CreatorKanata/pneutouch-ai-rehc2026/README.md

<!-- Project entry point: what the system is, how it works, and how to run it. -->
# PneuTouch AI

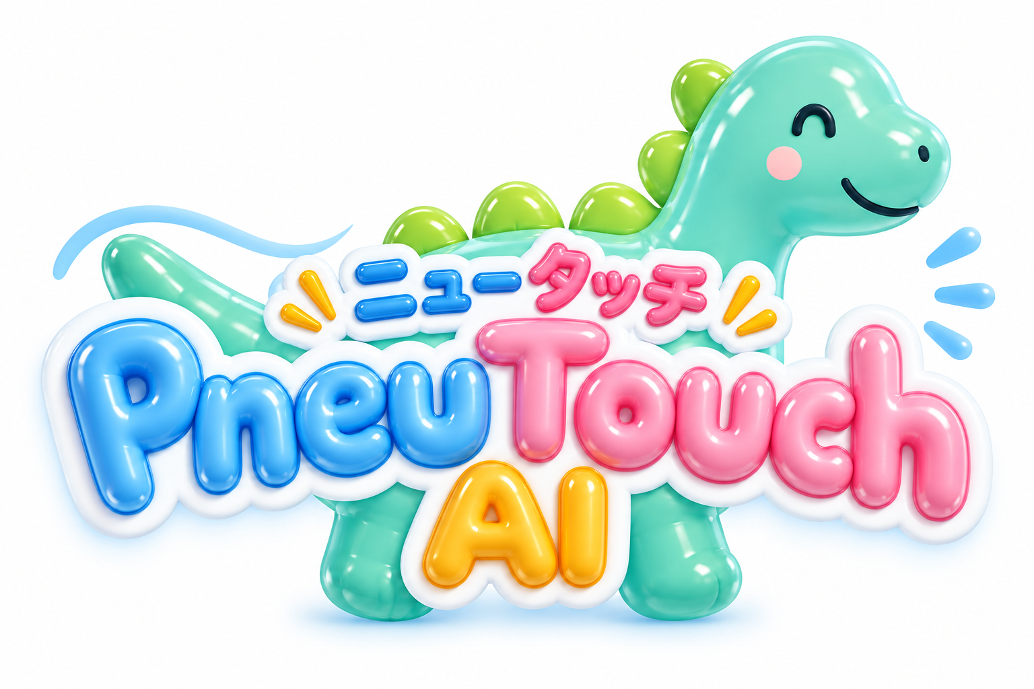
[picture p1: images/logo/pneu-touch-ai-thumbnail.png]
PneuTouch AI — 触れると動き出す中空恐竜


**Created by Kanata the Kid Creator.**

やわらかいTPU製の中空恐竜を7つの空気室に分け、
**たった1個の空気圧センサーの波形から「どこを触られたか」を推定する**システムです。
推定はROHMのマイコン ML63Q2557 に搭載された Solist-AI で行い、学習も推論もチップの中だけで完結します。
触った場所に応じて、画面の中の恐竜が反応します。

ROHM EDGE HACK CHALLENGE 2026（REHC2026）の応募作品です。

| | リンク |
|---|---|
| 作品ページ（ProtoPedia） | <https://protopedia.net/prototype/9781> |
| デモ動画（YouTube） | <https://youtu.be/TioNkfCQrJ0> |

## システム構成

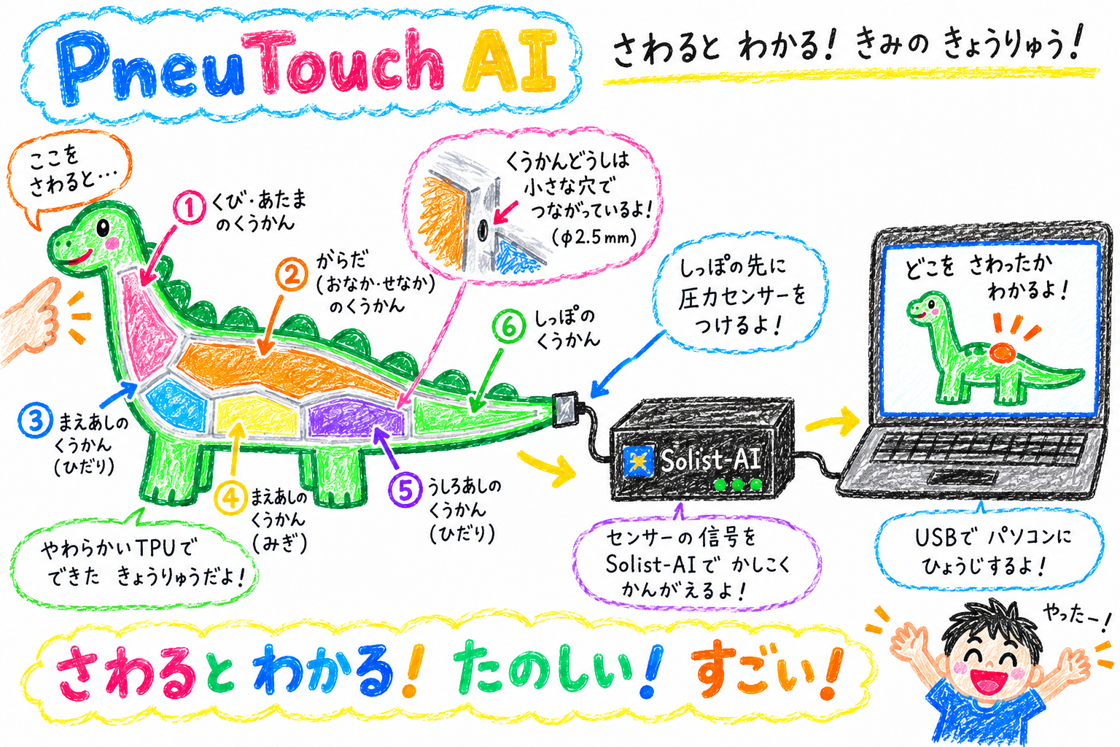
[picture p2: images/others/system.png]
システム構成


## しくみ

ふつう、7か所のタッチを検出するには7個のセンサーが必要です。
PneuTouch AI は、センサーを増やす代わりに**恐竜の「形」に情報を持たせます**。
恐竜の中には電子部品も配線も入っておらず、センサーはしっぽの先に1個だけです。

```text
恐竜を押す → 空気が穴を通って伝わる → 圧力の波形を測る → 波形の形を12個の数にする
→ Solist-AI が部位を当てる → LCD と画面の恐竜が反応する
```

### 1. 恐竜の中は7つの部屋

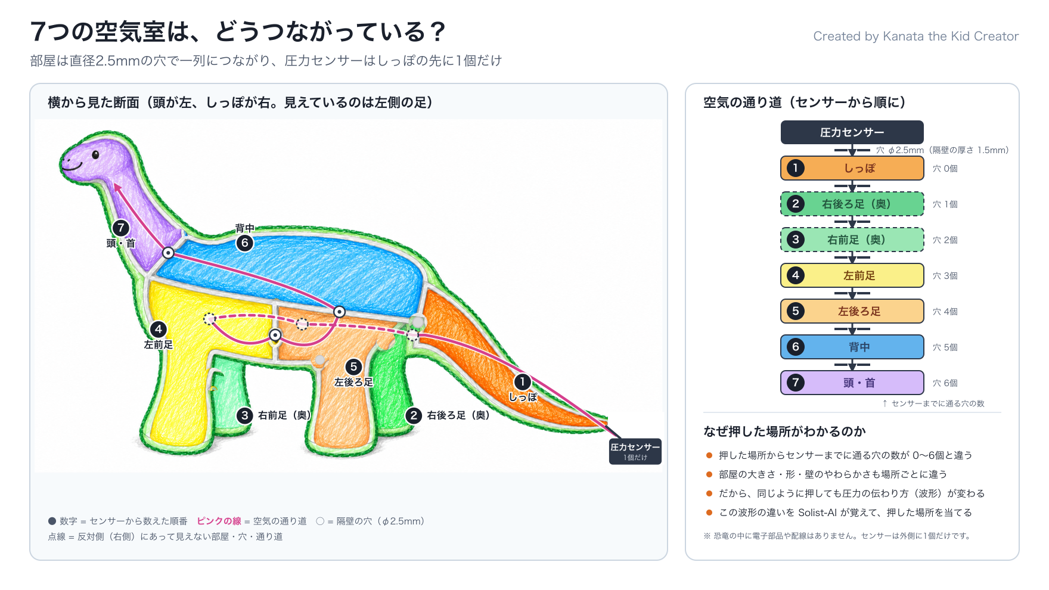
[picture p3: images/protopedia/air-chambers.png]
7つの空気室のつながり


恐竜の中は7つの空気室に分かれていて、となりの部屋とは直径2.5 mmの穴1個でつながっています
（外殻と隔壁の厚さは1.5 mm）。部屋は一列につながり、センサーから数えると次の順です。

```text
センサー → ①しっぽ → ②右後ろ足 → ③右前足 → ④左前足 → ⑤左後ろ足 → ⑥背中 → ⑦頭・首
```

しっぽを押すと空気の変化は穴を通らずにセンサーへ届き、頭を押すと6個の穴を通って届きます。
通る穴の数や部屋の大きさが場所ごとに違うので、**圧力の伝わり方が場所ごとに変わります**。

| Zone | 部位 | 分類クラス |
|---:|---|---|
| 1 | しっぽ | `TAIL` |
| 2 | 背中・胴体 | `BACK` |
| 3 | 右後ろ足 | `LEGS` |
| 4 | 左後ろ足 | `LEGS` |
| 5 | 右前足 | `LEGS` |
| 6 | 左前足 | `LEGS` |
| 7 | 首・頭 | `HEAD` |

Zone番号は設計上の区画番号で、センサーからの順番とは異なります。

### 2. 押して離すと、波形ができる

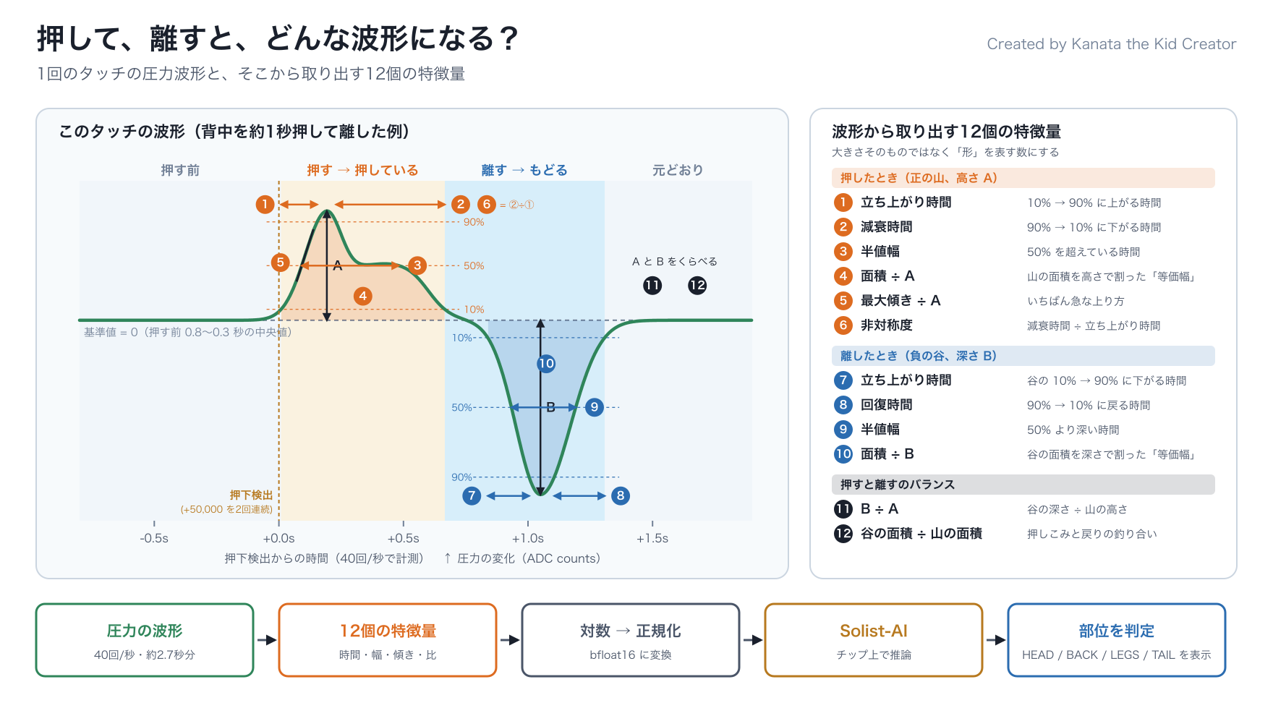
[picture p4: images/protopedia/waveform-features.png]
押して離したときの波形と12個の特徴量


恐竜を約1秒押して離すと、センサーには次のような波形が届きます。

- **押したとき** — その部屋の空気が押し出され、圧力が**上がる**（正の山）
- **離したとき** — 形が元に戻ろうとして空気を吸い込み、圧力が**下がる**（負の谷）

圧力は MPS20N0040D + HX710B で40回/秒、24 bitで測ります。

マイコンは圧力の「大きさ」ではなく、この山と谷の「形」を12個の数（特徴量）にしてAIに渡します。

| グループ | 特徴量 |
|---|---|
| 押したとき（正の山、高さ A） | ①立ち上がり時間 ②減衰時間 ③半値幅 ④面積÷A ⑤最大傾き÷A ⑥非対称度（②÷①） |
| 離したとき（負の谷、深さ B） | ⑦立ち上がり時間 ⑧回復時間 ⑨半値幅 ⑩面積÷B |
| 押すと離すのバランス | ⑪B÷A ⑫谷の面積÷山の面積 |

時間や比にすることで、押す強さが多少変わっても形の特徴が残るようにしています。

### 3. AIが部位を当てる

12個の特徴量を ROHM ML63Q2557 の Solist-AI に入力し、`HEAD / BACK / LEGS / TAIL` の4つに分類します。
学習も推論もマイコンの中だけで行い、クラウドもPCも使いません。

### 4. 恐竜が反応する

結果はボードのLCDに3秒表示され、USBでPCへ送られます。
ブラウザーのデモ画面が、触った部位に応じた動画・部位の画像・そのときの実測波形を表示します。

## ハードウェア

| 部品 | 役割 |
|---|---|
| TPU製の中空恐竜（3Dプリント） | 触られる本体。7つの空気室を持つ |
| MPS20N0040D + HX710B モジュール | 空気圧センサーと24 bit A/D変換 |
| DT-EBML63Q2557 | ROHM ML63Q2557（Arm Cortex-M0+、Solist-AI）搭載の評価ボード |
| MCU-LINK | ファームウェアの書き込み・デバッグ |
| PC（Chrome / Edge） | デモ画面の表示 |

### 回路図

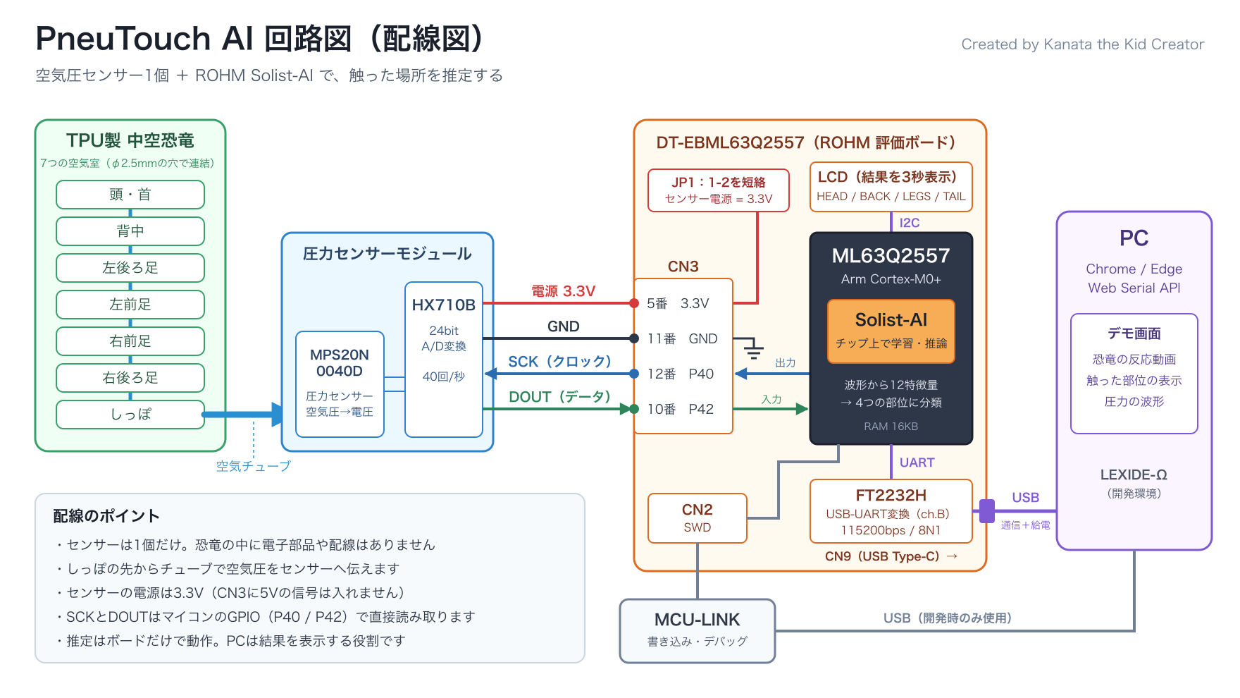
[picture p5: images/protopedia/circuit-diagram.png]
回路図


| センサーモジュール | DT-EBML63Q2557 | マイコン |
|---|---|---|
| VCC | CN3-5（3.3V） | — |
| GND | CN3-11 | — |
| SCK | CN3-12 | P40（GPIO出力） |
| DOUT | CN3-10 | P42（GPIO入力） |

- JP1は1–2を短絡してセンサー電源を3.3Vにします。CN3に5Vの信号は入れません。
- PCとの通信はCN9（USB Type-C）。FT2232HのチャネルBがUARTで、115200 baud / 8N1 / フロー制御なしです。
- MCU-LINKはCN2（SWD）に接続します。

詳しくは[ボード・センサー・配線](docs/hardware.md)を参照してください。

## ソフトウェア

| 場所 | 言語 | 内容 |
|---|---|---|
| `src/pneutouch-solist` | C | ファームウェア（プロジェクト名 `PneutouchAi`）。センサー読み取り、特徴抽出、Solist-AIの学習・推論、LCD表示、UART送信 |
| `src/demo-visualizer` | JavaScript | デモ画面。Web Serial APIで推定結果を受け取り、動画・部位画像・波形を表示 |
| `src/learning-tool` | JavaScript / Python | 波形の表示とCSV保存を行う計測ツール |
| `src/shared` | JavaScript | シリアル接続、通信の解析、記録の共通処理 |
| `tools` | Python | 波形の分析、学習データの生成、設定ヘッダーの生成、ローカルサーバー |
| `tests` | C / Python / JavaScript | PC上で動かすテスト |

自作のファームウェアは `src/pneutouch-solist/S_PneuTouch` にあります。

### AIモデル

| 項目 | 内容 |
|---|---|
| 入力 | 波形から計算した12特徴量（[しくみ 2](#2-押して離すと波形ができる) を参照） |
| 構成 | 12入力・隠れ層32・4出力 |
| 学習 | 電源投入時に、FLASHへ格納した60イベントからチップ上で自動学習（約0.5秒） |
| 推定 | 前処理を含めて約5ミリ秒 |
| 2段階判別 | 1段目が `HEAD` か `LEGS` を返したとき、専用モデルで判別し直す |

推定に使うのはその場のセンサーの値だけで、推定時にPCの操作は要りません。
モデルの詳細は[ライブデモの実装](docs/live-pressure-demo-20260920.md)と
[頭と足の判別](docs/head-legs-refinement-20260920.md)を参照してください。

### 通信

ボードはUARTで次の行を送ります。ブラウザー側で分類し直すことはありません。

| 出力 | 意味 |
|---|---|
| `PNEU1,seq,ms,raw` | センサーの生値 |
| `# PNEE1` / `# PNEF1` | 検出したイベントと12特徴量 |
| `# PNEC1,id,ms,label,...` | 推定結果とスコア |
| `# PNEL1,label,ms` | LCDの表示 |

## 使い方

### 1. ファームウェアを書き込む

LEXIDE-Ωで `src/pneutouch-solist` を開きます。

1. **PneutouchAi (in pneutouch-solist)** を選び、**Debug** でビルド。
2. **PneutouchAi Write** をDebugとして起動して書き込み。
3. LCDに `READY` が出たら、約2秒待ってから恐竜を押します。

手順の詳細は[配線・ビルド・計測手順](docs/phase0-bringup.md)と
[Mac / Windowsでの開発方法](docs/development-workflow.md)にあります。

### 2. デモ画面を開く

```sh
python tools/serve_demo.py
```

Chrome / Edgeで <http://localhost:8001/demo-visualizer/> を開き、
「恐竜につなぐ」からCN9のUARTポート（開発環境ではCOM7）を選びます。
表示の仕様は[HTMLデモ](src/demo-visualizer/README.md)を参照してください。

### 3. 波形を見る・記録する

```sh
python tools/serve.py
```

<http://localhost:8000/learning-tool/> を開いて同じポートに接続します。
同じシリアルポートを複数の画面で同時に開くことはできません。

### 設定の変更とテスト

```sh
python tools/generate_config.py   # config.py から設定ヘッダーを生成
python tools/test.py              # PC上のテストを実行
```

## ディレクトリ構成

```text
pneutouch-ai-rehc2026/
├── 3d-models/     # 恐竜の3Dモデル（STL / 3MF）
├── config.py      # 設定の原本
├── docs/          # 設計・手順・検証記録
├── images/        # ロゴ、デモ画像、構成図、回路図
├── src/           # ファームウェアとPCアプリ
├── tests/         # テスト
├── tools/         # 分析・生成・起動スクリプト
└── videos/demo/   # デモ画面で再生する動画
```

## ドキュメント

- [ドキュメント一覧](docs/README.md)
- [コンセプト](docs/concept.md) / [企画の核と検証方針](docs/product-design.md)
- [ボード・センサー・配線](docs/hardware.md)
- [ディレクトリ構成とアプリの役割](docs/architecture.md)
- [Solist-AI実機での学習・比較結果](docs/solist-chip-validation-20260920.md)
- [隔壁・穴径によるフィルタ設計の検討](docs/pneumatic-filter-design-20260920.md)

実測データと検証の記録は `docs/analysis/` にあります。

## ライセンス

Copyright 2026 Kanata the Kid Creator

このプロジェクトは [Apache License 2.0](LICENSE) で公開しています。
次の部分は提供元の著作権表示と条件に従います。詳しくは [NOTICE](NOTICE) を参照してください。

- `src/pneutouch-solist` のうち `S_PneuTouch` 以外は、ROHM Co., Ltd. が配布するドライバー、
  サンプルコード、Solist-AIライブラリーに基づいています。
- 恐竜の外形は [Cute Stylized Dinosaur Toy](https://www.printables.com/model/489585-cute-stylized-dinosaur-toy) をベースにしています。
  内部の空気室・隔壁・穴・圧力取り出し口は独自に設計しました。
