CreatorKanata/pneutouch-ai-rehc2026/docs/concept.md

もちろん。今回は「実際にこのまま開発を進められる仕様書」に寄せて、**設計 → 造形 → センサ接続 → 波形取得 → 原理検証 → Solist-AI学習 → PCアプリ → 評価 → 次版改善**まで含めてまとめます。

# PneuTouch AI

## 1つの空気圧センサで柔らかい立体物の接触位置を推定するオンデバイスAI

**Project:** ROHM EDGE HACK CHALLENGE 2026（REHC2026）
**AI Platform:** Solist-AI™ / DT-EBML63Q2557
**Prototype:** 7-Zone Soft Dinosaur
**Pressure Sensor:** MPS20N0040D + HX710B
**Material:** TPU
**Project Status:** Prototype Development

---

# 1. 概要

**PneuTouch AI** は、柔らかい中空構造物の内部を複数の空気室（チャンバー）へ分割し、**たった1個の空気圧センサから「どこを押されたか」をオンデバイスAIで推定する触覚センシング技術**です。

一般的な多点タッチセンシングでは、検出したい場所ごとに、

* スイッチ
* FSR
* 静電容量センサ
* 圧力センサ
* 磁気センサ

などを配置する必要があります。

PneuTouch AIでは、各部位に電気的なセンサを配置しません。

代わりに、柔らかい構造物内部を複数の空気室に分割し、それぞれを小さな穴（オリフィス）によって接続します。

どこかを押すと内部の空気圧が変化します。

その圧力変化が複数のチャンバーとオリフィスを通って1個の圧力センサまで伝わる際に、

* 立ち上がり速度
* ピーク圧力
* ピーク到達時間
* 波形形状
* 減衰
* 復帰波形

などに違いが発生することを利用します。

この複雑な圧力波形を **Solist-AI™** に学習させることで、押された位置を分類します。

---

# 2. コンセプト

## 1 Sensor, Whole-Body Touch

PneuTouch AIの基本コンセプトは、

> **柔らかい物体そのものを触覚センサにする**

ことです。

```text
複数の触覚エリア
       ↓
複数の空気チャンバー
       ↓
オリフィスによる空気圧ネットワーク
       ↓
圧力センサ × 1
       ↓
Solist-AI™
       ↓
接触位置推定
```

例えば7ヶ所の接触を検出するために7個のセンサを配置するのではなく、

**7区画 + 圧力センサ1個**

で実現することを目標とします。

---

# 3. REHC2026での技術的な狙い

本プロジェクトでは、単純な圧力閾値判定ではなく、Solist-AI™による波形分類を利用します。

最終的な圧力値だけを見る場合、どの区画を押しても内部圧力は最終的に均一化する可能性があります。

しかし、圧力が均一化するまでの**過渡応答**には、接触位置による違いが含まれると考えています。

```text
Touch
  ↓
Pneumatic transient response
  ↓
Pressure waveform
  ↓
Solist-AI
  ↓
Touch location
```

つまりPneuTouch AIは、

**「圧力の大きさ」をAIで分類するのではなく、「圧力が伝わる過程」をAIで分類する**

システムです。

---

# 4. プロトタイプ外形

初期プロトタイプには、Printablesで公開されている以下の恐竜モデルをベース外形として利用します。

**Cute Stylized Dinosaur Toy**

[https://www.printables.com/model/489585-cute-stylized-dinosaur-toy](https://www.printables.com/model/489585-cute-stylized-dinosaur-toy)

利用するのは主として**外形デザイン**です。

PneuTouch AIとして必要となる、

* 内部空洞
* 7区画
* 隔壁
* オリフィス
* 圧力取り出し口
* TPU向け壁構造

については独自に設計します。

元モデルのライセンス条件については、公開・配布時に原作者の指定条件を確認し、それに従います。

---

# 5. 3Dプリント構造

## 5.1 材料

初期試作：

**TPU**

柔らかく、押すことで外壁および内部空気室が変形する材料を利用します。

求める特性：

* 手で容易に押せる
* 押した後に形状が復帰する
* ある程度の気密性を確保できる
* 繰り返し押しても破損しにくい

---

# 6. 内部区画

恐竜内部を以下の7区画に分割します。

| Zone | 部位 |
| ---: | ----- |
| 1 | 尻尾 |
| 2 | 背中・胴体 |
| 3 | 右後ろ足  |
| 4 | 左後ろ足  |
| 5 | 右前足 |
| 6 | 左前足 |
| 7 | 首・頭 |

各区画はTPU製の隔壁で分離します。

---

# 7. 空気圧ネットワーク

初期試作では各区画を以下の順番で接続します。

```text
Pressure Sensor
      │
      ▼
[1 Tail]
      │
    φ2.5
      │
[3 Right Rear Leg]
      │
    φ2.5
      │
[5 Right Front Leg]
      │
    φ2.5
      │
[6 Left Front Leg]
      │
    φ2.5
      │
[4 Left Rear Leg]
      │
    φ2.5
      │
[2 Body / Back]
      │
    φ2.5
      │
[7 Neck / Head]
```

接続順：

**1 → 3 → 5 → 6 → 4 → 2 → 7**

---

# 8. オリフィス

## 初期試作

各隔壁を接続する穴：

**φ2.5 mm**

初期段階からφ2.5 mmで試作します。

この穴は単なる空気穴ではなく、PneuTouch AIにおいて重要な**空気抵抗要素**です。

穴径が大きすぎる場合：

```text
圧力が急速に均一化
↓
区画間の波形差が小さくなる
```

穴径が小さすぎる場合：

```text
圧力伝達が遅すぎる
↓
応答性低下
↓
TPU造形時に穴が塞がる可能性
```

そのため初期値としてφ2.5 mmを採用します。

---

# 9. Pneumatic Encoding

PneuTouch AIでは、内部構造そのものを情報エンコーダとして利用します。

これを本プロジェクトでは、

**Pneumatic Encoding**

と呼びます。

各区画には、

* センサまでの経路長
* 通過するオリフィス数
* チャンバー容積
* チャンバー形状
* TPU壁面形状
* 周囲の構造

の違いがあります。

例えばZone 1（Tail）は圧力センサのすぐ近くにあります。

```text
Tail
 ↓
Sensor
```

一方Zone 7（Head / Neck）は、

```text
Head
 ↓
Body
 ↓
Left Rear
 ↓
Left Front
 ↓
Right Front
 ↓
Right Rear
 ↓
Tail
 ↓
Sensor
```

という長い空気圧経路を通ります。

そのため、同じ程度の力で押しても異なる過渡応答が発生することを期待します。

---

# 10. 想定される圧力波形

概念的には以下のような違いを期待します。

## センサに近い部位

```text
Pressure
   │
   │     ╭────────
   │  ╭──╯
   │__╯
   │
   └──────────────── Time
```

## 中間部位

```text
Pressure
   │
   │        ╭───────
   │     ╭──╯
   │____╯
   │
   └──────────────── Time
```

## センサから遠い部位

```text
Pressure
   │
   │            ╭────
   │         ╭──╯
   │________╯
   │
   └──────────────── Time
```

実際にはもっと複雑な波形になることが予想されます。

むしろ、その複雑さをSolist-AI™で分類することが本プロジェクトの狙いです。

---

# 11. 圧力取り出し口

恐竜の**尻尾先端**に圧力取り出し口を設けます。

初期設計では約φ2.5 mmのチューブ形状とし、圧力センサ側へ接続します。

重要事項：

* 接続部から空気が漏れないこと
* TPUとチューブの接続部を気密化すること
* センサ側チューブ容量をなるべく一定にすること
* 実験ごとに配管条件を変更しないこと

---

# 12. 圧力センサ

使用予定：

**MPS20N0040D + HX710B系圧力センサモジュール**

購入先：

[https://www.amazon.co.jp/dp/B0DMDL39BG](https://www.amazon.co.jp/dp/B0DMDL39BG)

想定モジュール端子：

```text
VCC
GND
SCK
DOUT
```

想定電源：

**3.3〜5V**

DT-EBML63Q2557との接続では、3.3V系GPIOとの整合性を考慮し、原則として**3.3V給電**で使用します。

---

# 13. 圧力センサの役割

MPS20N0040Dによって内部空気圧の変化を検出し、HX710Bによってデジタル値として取得します。

重要なのは、絶対圧力の高精度測定ではありません。

本プロジェクトでは、

**時間方向に変化する相対圧力波形**

を主なAI入力として利用します。

---

# 14. AI開発ボード

使用：

**DT-EBML63Q2557**

搭載MCU：

**ML63Q2557**

AI：

**Solist-AI™ / AxlCORE-ODL**

主な役割：

1. HX710Bから圧力データ取得
2. 圧力データのリングバッファ保存
3. 接触イベント検出
4. 固定長波形生成
5. 必要な前処理
6. Solist-AI学習
7. Solist-AI推論
8. USB UARTによるPC通信

---

# 15. MCU-LINK

ファームウェアの開発・デバッグには**MCU-LINK**を使用します。

用途：

* ファームウェア書き込み
* デバッグ
* ブレークポイント
* メモリ確認
* センサ取得処理の検証
* Solist-AI処理の検証

構成：

```text
PC
 │
 ├── MCU-LINK
 │      │
 │      ▼
 │ DT-EBML63Q2557
 │
 └── USB UART
        │
        ▼
   DT-EBML63Q2557
```

MCU-LINKとUSB UARTは目的を分離します。

**MCU-LINK = 開発・デバッグ**

**USB UART = PneuTouch Consoleとのデータ通信**

---

# 16. USB UART

DT-EBML63Q2557とPCはUSB UARTで接続します。

PCからは仮想COMポートとして扱う構成を想定します。

---

# 17. PCアプリケーション

PC側には専用アプリ、

# PneuTouch Console

を開発します。

初期案ではブラウザベースのWebアプリとします。

候補：

* HTML
* CSS
* JavaScript / TypeScript
* Web Serial API
* Chart.js または ECharts

Chrome / EdgeのWeb Serial APIを利用することで、ブラウザから直接USB UARTへ接続することを想定します。

---

# 18. PneuTouch Consoleの役割

PneuTouch Consoleは単なるデモ画面ではなく、

**開発・学習・評価・デモを統合したツール**

とします。

主な機能：

1. シリアルポート接続
2. 生圧力値表示
3. リアルタイム波形表示
4. 接触イベント表示
5. 学習対象Zone指定
6. 学習開始/停止
7. サンプル数表示
8. AI推論結果表示
9. クラススコア表示
10. 接触位置の恐竜図への表示
11. 接触位置に対応した動画再生
12. CSV保存
13. 過去波形との比較

---

# 19. PC画面案

```text
┌────────────────────────────────────────────┐
│ PneuTouch AI Console                      │
├──────────────────┬─────────────────────────┤
│                  │                         │
│   Dinosaur       │   Pressure Waveform     │
│                  │                         │
│      HEAD        │         ╭──────         │
│       ██         │      ╭──╯               │
│     █████        │  ___╯                   │
│    ███████       │                         │
│                  │                         │
├──────────────────┼─────────────────────────┤
│ Prediction       │ Training / Scores       │
│                  │                         │
│ HEAD / NECK      │ HEAD  █████████ 92%     │
│                  │ BODY  ██         5%     │
│                  │ TAIL  █          3%     │
├──────────────────┴─────────────────────────┤
│              Reaction Video               │
└────────────────────────────────────────────┘
```

---

# 20. PCアプリ：恐竜表示

画面には恐竜の模式図を表示します。

推論された区画をハイライトします。

例えば頭を押した場合：

```text
Zone 7
HEAD / NECK

→ 頭と首をハイライト
```

尻尾なら：

```text
Zone 1
TAIL

→ 尻尾をハイライト
```

これによりAIの推論結果を直感的に確認できます。

---

# 21. PCアプリ：動画リアクション

推論結果に応じて異なる動画を表示します。

例：

| Zone | 部位 | Reaction |
| ---: | ---- | --- |
| 1 | 尻尾 | 怒る |
| 2 | 背中 | 振り向く |
| 3 | 右後ろ足 | 足を動かす |
| 4 | 左後ろ足 | 足を動かす |
| 5 | 右前足  | 手を振る |
| 6 | 左前足  | 手を振る |
| 7 | 首・頭  | 喜ぶ |

これにより、

> **触った場所を恐竜自身が感じて反応している**

ような体験を作ります。

---

# 22. PCアプリ：学習UI

学習時にはPCから対象Zoneを指定します。

```text
TRAINING MODE

Select Zone:

[1 Tail]
[2 Body]
[3 Right Rear Leg]
[4 Left Rear Leg]
[5 Right Front Leg]
[6 Left Front Leg]
[7 Head / Neck]

Target:
7 HEAD / NECK

Samples:
██████████████░░░░░░
23 / 30

[ START ]
[ STOP ]
```

対象Zoneを指定した状態で、その部位を繰り返し押します。

---

# 23. データ取得手順

## Phase 0：AIを使わずセンサを動かす

最初はSolist-AIを使用しません。

目標：

**MPS20N0040D + HX710Bの値をDT-EBML63Q2557で取得し、PCへ表示する。**

手順：

1. HX710BをDT-EBML63Q2557へ接続
2. 3.3Vで動作確認
3. HX710B読み出し処理実装
4. USB UARTへ値を送信
5. PCで値を表示
6. センサへ直接圧力を加えて変化を確認

---

続きとして、**Phase 1以降の検証フェーズ**をそのまま仕様書に追記できるMarkdownでまとめます。特に「φ2.5 mmの7区画構造が本当に位置情報を残しているか」をSolist-AI学習前に確認する流れを重視しています。

# 24. Phase 1：恐竜の気密確認

TPU恐竜が完成したら、最初にAIではなく**空気圧センサとして成立しているか**を確認します。

## 目的

* TPU外壁から大きな空気漏れがないこと
* 7区画が空気圧的につながっていること
* φ2.5 mmオリフィスが造形時に塞がれていないこと
* 尻尾先端から圧力変化を取得できること
* 押した後に圧力が正常に復帰すること

## 手順

1. 尻尾先端の圧力取り出し口をMPS20N0040Dへ接続する
2. PCでリアルタイム圧力値を表示する
3. Zone 1（Tail）をゆっくり押す
4. 圧力値が変化することを確認する
5. Zone 7（Head / Neck）を押す
6. センサから最も遠いZone 7でも圧力変化が到達することを確認する
7. Zone 1〜7を順番に押す
8. すべてのZoneで圧力変化が取得できることを確認する

## 気密テスト

任意のZoneを一定時間押した状態に保持します。

正常な場合：

```text
押す
 ↓
圧力上昇
 ↓
一定値付近を維持
 ↓
手を離す
 ↓
基準値へ復帰
```

押し続けているにもかかわらず圧力が急速に基準値へ戻る場合は、以下を確認します。

* TPU外壁からの空気漏れ
* 積層間の微細なリーク
* 尻尾のチューブ接続部
* 圧力センサ接続部
* 隔壁の意図しない穴
* オリフィス以外での区画間リーク

---

# 25. Phase 2：7区画の生波形取得

気密性が確認できたら、**Solist-AIを使わずに7区画の圧力波形を取得**します。

このフェーズがPneuTouch AIの成立可否を判断する最重要実験です。

## 目的

各Zoneを押したときに、圧力波形へ再現可能な違いが現れるか確認します。

## 初期データセット

各Zoneについて最低30回取得します。

```text
Zone 1 Tail             × 30
Zone 2 Body / Back      × 30
Zone 3 Right Rear Leg   × 30
Zone 4 Left Rear Leg    × 30
Zone 5 Right Front Leg  × 30
Zone 6 Left Front Leg   × 30
Zone 7 Head / Neck      × 30
```

合計：

```text
7 classes × 30
= 210 touch events
```

可能であれば50回ずつ取得します。

---

# 26. 押し方の標準化

初期検証では、位置以外の変数をできるだけ減らします。

最初は、

* 指1本で押す
* 約1秒程度押す
* 約1秒程度保持
* 手を離す
* 次の試行まで1〜2秒待つ

という一定の操作を行います。

初期段階では「弱く押す」「強く押す」などを混在させません。

まず、

> **同じように押した場合、位置だけを分類できるか**

を確認します。

---

# 27. PCへの生波形保存

PneuTouch Consoleでは各接触イベントをCSV等で保存します。

例：

```text
timestamp,zone,sample_index,pressure
12:03:21.120,1,0,838241
12:03:21.125,1,1,838255
12:03:21.130,1,2,838291
...
```

各イベントには以下の情報を保存します。

* Zone ID
* 試行番号
* Timestamp
* Raw pressure
* Baseline pressure
* Delta pressure
* サンプリング周期
* 必要に応じてメモ

---

# 28. Phase 3：波形の可視化

収集した210回以上の波形をPC上で比較します。

## まず確認するもの

### 1. Raw waveform

生の圧力値。

### 2. Baseline corrected waveform

接触直前を0として、

```text
ΔP(t) = P(t) - Pbaseline
```

を表示します。

### 3. Normalized waveform

押す強さの違いを減らして波形形状を比較するため、

```text
0.0 ～ 1.0
```

へ正規化した波形も表示します。

---

# 29. Zoneごとの波形重ね合わせ

例えばZone 1を30回押した波形を同じチャートへ重ねます。

目的は、

**同じZoneの波形に再現性があるか**

を確認することです。

その後、

```text
Zone 1 mean waveform
Zone 2 mean waveform
Zone 3 mean waveform
...
Zone 7 mean waveform
```

を比較します。

理想的には、Zoneごとに特徴的な立ち上がり・減衰パターンが確認できます。

---

# 30. Phase 4：Pneumatic Encoding成立確認

ここで初めて、

> **7区画の空気圧ネットワークに位置情報が残っているか**

を判断します。

## 観察候補

各波形について、

* 最大ΔP
* Rise time
* Peak time
* Fall time
* 波形面積
* 初期傾斜
* 最大傾斜
* 押している間の変動
* Release時の負圧/復帰特性
* 接触後一定時間の波形

などを比較します。

重要なのは、これらを必ず手作業で分類ルールへ変換することではありません。

Solist-AIへ入力する前に、

**「そもそもZoneによる情報差が存在する」**

ことを確認するために利用します。

---

# 31. 成立判定

## Case A：7区画が明確に違う

最良ケース。

そのまま7クラスSolist-AI学習へ進みます。

## Case B：4〜5グループ程度に分かれる

例えば、

```text
HEAD
BODY
FRONT LEGS
REAR LEGS
TAIL
```

程度なら区別できる場合。

まず5クラスでSolist-AIを完成させます。

その後、内部構造を改良して7クラスを目指します。

## Case C：センサからの距離だけが分かる

例えば、

```text
Near
Middle
Far
```

程度しか分離しない場合。

φ2.5 mmのオリフィスだけでは十分なPneumatic Encodingができていない可能性があります。

次版で、

* オリフィス径
* チャンバー容量
* 接続順序
* 流路長

を変更します。

## Case D：ほぼ同じ波形

Pneumatic Encodingが成立していません。

この場合はAI学習へ進まず、内部構造を改良します。

---

# 32. Phase 5：イベント検出

位置分類の前に、

**押された瞬間を自動検出する処理**

を実装します。

通常状態では圧力値をリングバッファへ保存します。

```text
P(t)
P(t-1)
P(t-2)
...
```

一定以上の変化を検出したらTouch Eventを開始します。

例：

```text
if abs(P(t) - baseline) > TOUCH_THRESHOLD:
    touch_event = true
```

この部分はAIではなく通常のMCU処理で構いません。

---

# 33. Pre-trigger Buffer

接触直後だけでなく、**接触直前の波形も保存**します。

例えば128サンプルをAIへ入力する場合、

```text
Pre-trigger  : 16 samples
After trigger: 112 samples
-------------------------
Total        : 128 samples
```

とします。

これにより、

```text
通常
↓
接触開始
↓
圧力上昇
↓
保持
```

までを1つの固定長データとして取得できます。

---

# 34. Phase 6：Solist-AI用入力生成

初期案では128点の圧力波形を固定長入力として使用します。

```text
X = [
 P0,
 P1,
 P2,
 ...
 P127
]
```

初期実験では過度な特徴量設計をせず、波形そのものを利用します。

---

# 35. 前処理候補

必要に応じて以下を比較します。

## A. Raw

```text
P0 ... P127
```

最もシンプル。

## B. Baseline subtraction

```text
Xi = Pi - Pbaseline
```

大気圧やセンサオフセットの影響を減らします。

## C. Normalization

最大値などで正規化します。

押す強さの違いより波形形状を重視する場合に利用します。

## D. Differential waveform

```text
dP(t) = P(t) - P(t-1)
```

圧力の変化速度を強調します。

---

# 36. 最初に試すAI入力

優先順位：

```text
1. Baseline corrected raw waveform
2. Normalized waveform
3. Differential waveform
```

まず1で実験します。

分類精度が不足した場合に2、3を試します。

---

# 37. Phase 7：Solist-AI 4クラス学習

いきなり7クラスにせず、まず簡単な4クラスでAIパイプライン全体を検証します。

推奨：

```text
Class 1 : HEAD / NECK
Class 2 : BODY
Class 3 : LEGS
Class 4 : TAIL
```

ここで、

```text
センサ取得
↓
イベント検出
↓
波形生成
↓
Solist-AI
↓
分類
↓
UART
↓
PC表示
```

まで完成させます。

---

# 38. Phase 8：7クラス学習

4クラスが安定したら7クラスへ拡張します。

```text
1 Tail
2 Body / Back
3 Right Rear Leg
4 Left Rear Leg
5 Right Front Leg
6 Left Front Leg
7 Head / Neck
```

各ZoneをSolist-AIへ学習させます。

---

# 39. 学習操作

学習対象の指定はPneuTouch Consoleから行います。

例：

```text
TRAINING

Target:
[7 HEAD / NECK]

Samples:
12 / 30

Status:
READY

[RECORD NEXT TOUCH]
```

ユーザーが頭を押すたびに1サンプル登録します。

---

# 40. Phase 9：未知データによる評価

学習に使用したデータで精度を評価してはいけません。

学習後、新たに各Zoneを20回程度押します。

```text
7 zones × 20
= 140 validation samples
```

これをValidation Datasetとします。

---

# 41. Confusion Matrix

PCアプリでは最終的に混同行列を表示できるようにします。

概念例：

```text
              Predicted
           1  2  3  4  5  6  7

Actual 1  19  0  1  0  0  0  0
       2   0 18  0  1  0  0  1
       3   0  0 17  1  2  0  0
       ...
```

これにより、

**どのZone同士をAIが間違えているか**

を確認します。

---

# 42. Phase 10：押す強さへのロバスト性

次に、

* Weak
* Normal
* Strong

の3種類の強さで押します。

目的：

> **押す強さではなく位置を認識しているか**

を確認すること。

もし強さによって誤分類する場合は、

* 学習データへ複数強度を追加
* 波形正規化
* 入力前処理変更

を検討します。

---

# 43. Phase 11：押す速度へのロバスト性

以下を試します。

```text
Slow Press
Normal Press
Quick Press
```

人による操作なので押す速度は必ず変動します。

実際のデモではこの変動に耐える必要があります。

---

# 44. Phase 12：ユーザー差評価

開発者だけで学習・評価すると、その人固有の押し方をAIが学習する可能性があります。

そこで複数人でテストします。

例：

```text
User A
User B
User C
```

理想的には、

**User Aのデータを含めて学習 → B/Cが押しても位置分類可能**

を目指します。

---

# 45. Phase 13：φ2.5 mmオリフィス評価

初期試作はすべてφ2.5 mmです。

実測結果から以下を評価します。

## φ2.5 mmで十分な場合

そのまま採用します。

## 区画差が小さい場合

次版でより小さな穴を試します。

候補：

```text
φ2.0 mm
φ1.5 mm
```

ただしTPU FDMでの造形精度を考慮します。

---

# 46. Phase 14：非均一オリフィス

全区画を同じ穴径にする必要はありません。

次版では例えば、

```text
Zone 1 → φ2.5
Zone 3 → φ2.2
Zone 5 → φ2.0
Zone 6 → φ1.8
Zone 4 → φ1.6
Zone 2 → φ1.5
Zone 7
```

など、意図的に異なる空気抵抗を持たせることができます。

目的は、

**各Zoneに固有の圧力応答を持たせること**

です。

これはPneumatic Encodingをより積極的に設計するアプローチです。

---

# 47. Phase 15：チャンバー容量の最適化

オリフィスだけでなく、各Zoneの空気容量も波形に影響します。

次版では、

* 小さいチャンバー
* 大きいチャンバー
* 細長いチャンバー

などを意図的に組み合わせることも検討します。

つまり最終的には、

```text
Touch Position
↓
Unique Pneumatic Transfer Function
↓
Pressure Waveform
↓
Solist-AI
```

という設計を目指します。

---

# 48. Phase 16：PCアプリ統合

AI推論まで動作したら、PneuTouch Consoleへ統合します。

通常画面では、

* 恐竜の図
* 現在の圧力波形
* 推論Zone
* クラススコア
* 接触回数

を表示します。

---

# 49. Phase 17：リアクション動画

Zone推論後、対応する動画を再生します。

例：

```text
HEAD
→ 喜ぶ動画

BODY
→ 振り向く動画

TAIL
→ 怒る動画
```

重要なのは動画そのものではなく、

> **触った位置をAIが理解して恐竜が反応する**

という体験です。

---

# 50. 最終デモフロー

```text
ユーザーが恐竜に近づく
        ↓
好きな場所を押す
        ↓
TPU外壁が変形
        ↓
そのZoneの空気が押し出される
        ↓
φ2.5 mmオリフィスを通って圧力波が伝搬
        ↓
MPS20N0040D ×1
        ↓
HX710B
        ↓
DT-EBML63Q2557
        ↓
128点程度の波形取得
        ↓
Solist-AI
        ↓
7 Zone分類
        ↓
USB UART
        ↓
PneuTouch Console
        ↓
恐竜図の該当部位をハイライト
        +
対応する動画を再生
```

---

最後の「最終目標」は、恐竜というデモから**汎用技術として何を実証したいのか**まで広げると締まります。

# 51. 最終目標

PneuTouch AIの最終目標は、単に**「恐竜のどこを押されたかを当てる」**ことではありません。

技術的な目標は、

> **複数の柔らかい触覚エリアを、内部の空気圧ネットワークとたった1個の圧力センサによってセンシングし、その過渡的な圧力波形をオンデバイスAIで解析することで、接触位置を推定できることを実証する。**

ことです。

通常、多点の接触位置を検出するには、検出したい場所ごとにスイッチや圧力センサ、静電容量センサなどを配置する必要があります。

PneuTouch AIでは、それとは異なるアプローチを取ります。

```text
多数の接触位置
        ↓
柔らかい立体構造
        ↓
複数の空気チャンバー
        ↓
φ2.5 mmオリフィスによる
Pneumatic Encoding
        ↓
圧力センサ × 1
        ↓
圧力の過渡波形
        ↓
Solist-AI™
        ↓
接触位置推定
```

センサを増やす代わりに、**3Dプリントされた物体内部の物理構造そのものに接触位置の情報を符号化する**ことが、この方式の特徴です。

初期プロトタイプでは、柔らかいTPU製の恐竜を7区画に分割し、

1. 尻尾
2. 背中・胴体
3. 右後ろ足
4. 左後ろ足
5. 右前足
6. 左前足
7. 首・頭

のどこが押されたかを、尻尾側に接続された**1個のMPS20N0040D圧力センサだけで推定する**ことを目標とします。

さらに、単純にセンサからの距離を判定するのではなく、各チャンバーの容積、接続順序、オリフィス径、流路長、柔軟構造などによって生じる複雑な圧力応答をSolist-AI™に学習させます。

これにより、

> **「1個のセンサから、物体全体の触覚情報を取り出す」**

という新しいソフトセンシング手法の可能性を検証します。

## 将来的な展開

この技術は恐竜型玩具に限定されません。

柔らかく中空構造を持つ物体であれば、内部にPneumatic Encodingを設計することで、

* ぬいぐるみ・インタラクティブトイ
* ソフトロボット
* ロボット用人工皮膚
* クッション・家具
* ウェアラブルデバイス
* リハビリ・介護機器
* 柔軟なヒューマンインターフェース
* 空気圧式グリッパー
* 人と接触するロボット外装

などへの応用が考えられます。

特に、広い柔軟表面を多数の電気センサで覆う代わりに、**内部の空気圧ネットワークと少数のセンサで触覚化できる**ようになれば、配線数、センサ数、コスト、構造の複雑さを大幅に減らせる可能性があります。

## REHC2026で実証したいこと

ROHM EDGE HACK CHALLENGE 2026では、以下の仮説を実機で検証します。

> **柔らかい立体物内部の空気圧ネットワークには、接触位置に応じた固有の過渡応答が発生する。その波形をSolist-AI™でオンデバイス学習することで、1個の圧力センサだけでも複数の接触位置を分類できるのではないか。**

成功基準は、まず4区画以上を安定して分類できること。

目標は、初期プロトタイプに設定した**7区画すべてを1個の圧力センサで分類すること**です。

そして最終的には、

# One Sensor, Whole-Body Touch.

**たった1個のセンサで、柔らかい物体の全身に触覚を与える。**

これをPneuTouch AIの最終目標とします。
