CreatorKanata/pneutouch-ai-rehc2026/docs/final-judging/reprint-design.md

# 恐竜 v2 の再印刷：先行研究、設計原理、10日間での進め方

作成日: 2026-10-14。Hide の提案「構造が位置を符号化する研究に基づいて恐竜を作り直し、そもそもの精度を上げる。首も押しにくい」を受けた検討。
判断の結論は末尾。設計値は STL の実測寸法と公開文献から導いた**仮説**で、試験片で確認してから本体に使う。

---

## 0. 訂正（10/15）: 空気の流路では時定数を作れない

10/14 の 3 節は流路の**相対抵抗**（約30倍）だけを見て、**絶対値**を見ていなかった。集中定数で桁を計算すると次のとおり（区画 15 cm³、空気の圧縮性のみ、層流）。

| 流路 d × L | 抵抗 R [Pa·s/m³] | 時定数 τ = R·C | 0.5 cm³/0.1 s のときのオリフィス損失 |
|---|---:|---:|---:|
| φ2.5 × 1.5 mm（現行） | 8.5e4 | 0.01 ms | 2 Pa |
| φ1.5 × 15 mm | 2.5e6 | 0.26 ms | 13 Pa |
| φ1.2 × 35 mm | 1.3e7 | 1.4 ms | 33 Pa |
| φ1.0 × 40 mm | 3.0e7 | 3.2 ms | 68 Pa |
| φ0.6 × 20 mm | 1.2e8 | 12 ms | 520 Pa |
| φ0.3 × 35 mm | 3.2e9 | 340 ms | 8,300 Pa |

- 40 SPS（25 ms 間隔）で見える時定数（50 ms 以上）を作るには φ0.3 mm が必要で、FDM の TPU では印刷できず、オリフィス損失が信号（約 0.5〜2 kPa）を超える。
- 空気の圧縮性による容量 C = V/(γp₀) は、15 cm³ で 1.1e-10 m³/Pa。壁の弾性による容量（薄肉球近似、95A、1.5 mm）は 4e-12 で、気体の 1/25。85A・1.2 mm でも 1.7e-11。つまり**容量は空気が支配し、流路抵抗が小さすぎる**。
- 文献 [2]（空気リザバー）はメートル級のチューブ、[3] は粘性流体、[4] はマイクロ流路で、どれも印刷スケールの空気流路と 40 SPS の組み合わせではない。AirTouch [1] は 5 kHz サンプリングでポンプ流を見ている。

**実波形が示していること**（しっぽ直押し、`docs/analysis/2026-09-20-live-calibration/pressure-tail-20260920.csv`）:
押している間に +640k counts から 0 へ τ≈240 ms で減衰し、離すと −2,156k（山の 3.4 倍）の谷が τ≈50 ms で戻る。
密閉系なら押し続ける間は圧力が保たれるはずなので、この減衰は**漏れ**（戻りが速いので非線形）か壁の緩和。谷が山より大きいのは**TPU の跳ね返り**が指の押し込みより速いため。
つまり現在の波形の形は、空気の流路ではなく**漏れと壁の力学**が作っている。場所の差（しっぽ・背中が当たる理由）も壁の局所的な変形の違い。

**結論の修正**: 位置を符号化するなら、流路の径・長さではなく、**区画ごとの壁の力学**（厚さ、ドーム・蛇腹などの形、復元の速さ）で設計する。
流路設計で時定数を作るには kHz サンプリング（内蔵 ADC＋アンプ、`docs/mcu-adc-option.md`）が必要で、審査後の課題とする。
定量化は `tools/pneumatic_sim.py`（10/15 作成中）で行い、結果は `docs/analysis/2026-10-15-pneumatic-sim/` に置く。

---

## 1. 先行研究：「構造が位置を符号化する」は既に系譜がある

| 研究 | 何をしたか | PneuTouch との関係 |
|---|---|---|
| **AirTouch**（Tejada, Ramakers, Boring, Ashbrook, CHI 2020）[1] | 3Dプリント物体にポンプで空気を送り、表面の最大12個の小穴から逃がす。指で穴を塞ぐと気圧センサー1個の応答が変わり、Arduino＋機械学習でどの穴かを当てる。校正不要、12か所で90%以上（最大98%） | **最も近い先行研究。** 審査員（特に栗原氏＝HCI）が知っている可能性が高い。こちらから名前を出して違いを言うべき。違い: AirTouch は**能動**（ポンプ）・**硬い**PLA・**穴を塞ぐ**・PCで分類。PneuTouch は**受動**・**柔らかい**TPU・**どこでも押す**・**チップ内で学習** |
| **Pneumatic Reservoir Computing**（Kawase, Miyazaki, Kanno, Tadano, Nakajima, Kawashima, Sensors and Materials 2021）[2] | 空気室をつなぐ**チューブ内の空気の動特性そのものを計算資源**（物理リザバー）として使い、ソフト外骨格の姿勢を推定。計算能力は**チューブの内径と長さで決まり、適切に選べば上げられる** | 「構造が情報を作る」の理論的な裏付け。「流路の径と長さを設計する」という v2 の方針そのもの。Solist-AI の ODL は ESN 型（`scaleGamma`, `leakRate` を持つ）で、リザバーの読み出し層と相性がよい |
| **Tactile perception through fluid–solid interaction**（Nature Communications 2026）[3] | 粘性流体を満たした弾性チャネルの両端に圧力センサー2個。触る位置で両端の**最大圧力と立ち上がり時間**のパターンが変わり、機械学習で位置と力を推定 | 「大きさではなく時間特徴で位置を読む」という PneuTouch の特徴量設計と同じ考え方。粘性流体で時定数を作っている点が参考になる |
| **Soft Pneumatic Tactile Pressure Sensor Matrix**（Lampinen, Sariola ら, 2024）[4] | 行3本・列3本の空気チャネルで3×3の接触位置をNNで推定（87.3%）。応答は一次遅れで**時定数 100±30 ms** | 空気式触覚の時定数の実例。PneuTouch の回復時間 ~140 ms と同じ桁 |
| Lamello（CHI 2015）、Blowhole（2018）、Acoustruments（2015）[5] | 3Dプリントした櫛・空洞・管の形で音を変え、マイク1個で入力を識別 | HCI における「印刷した構造が入力を符号化し、トランスデューサー1個で読む」系譜 |

**PneuTouch の立ち位置**（発表で言う一文）:
> AirTouch のように形で位置を符号化し、リザバー計算のように流路の動特性を情報源にし、それを柔らかい物体の「押す」操作と、チップ内学習に持ち込んだ。

「世界初」とは言わない。「この組み合わせは見つけていない」と言う。

---

## 2. 現在の恐竜がうまくいかない理由（記録から）

- 穴 φ2.5 mm × 壁厚 1.5 mm は「長い細管」ではなく、抵抗がほぼない。7室が実質ひとつの空気室として振る舞い、センサーに届くのは**押した場所の局所的な壁の変形**の違いだけ（`docs/pneumatic-filter-design-20260920.md:93-94`）。
- だから HEAD（穴6個先）と LEGS（穴1〜4個先）の回復時間がほぼ同じ（140.6 ms vs 139.1 ms）で、「遠いほど遅い」が起きない（`docs/head-legs-waveform-analysis-20260920.md:17`）。
- 直列接続は、隣り合う区画（背中と頭、足同士）の差が「1段分」しかなく、操作のばらつきに埋もれる。

STL 実測: 外形 62 × 208 × 149 mm、TPU 材料体積 68.5 cm³（約 80 g）。

---

## 3. v2 の設計原理（原理 A・B は 0 節の訂正により**取り下げ**。原理 C・D は有効）

> 10/15 訂正: 原理 A（星形で流路ごとの時定数）と原理 B（時定数を 2 倍刻み）は、空気＋印刷流路では成立しない（0 節）。記録として残す。代わりに 3b 節の「壁の力学による符号化」を採用する。

### 原理 A: 直列をやめ、胴体をハブにした**星形（並列）**にする

```text
現在:  センサー → 尾 → 右後足 → 右前足 → 左前足 → 左後足 → 背中 → 頭   （直列、同じ穴）

v2:    センサー ── 胴体（ハブ、背中を含む）
                     ├─ 流路 T ─ 尾
                     ├─ 流路 L1 ─ 右後足
                     ├─ 流路 L2 ─ 左後足
                     ├─ 流路 L3 ─ 右前足
                     ├─ 流路 L4 ─ 左前足
                     └─ 流路 H ─ 頭
```

- 押した区画の空気は**自分の流路だけ**を通って胴体（センサー）に届く。流路ごとに径 d と長さ L を変えれば、区画ごとに独立した時定数 τ = R·C を設計できる（R ∝ L/d⁴、[2] と `pneumatic-filter-design-20260920.md:43`）。
- 胴体（背中）を押すと流路を通らず直接届く → 最も速い波形。尾は短い流路。頭は最も長く細い流路。足4本は中間を4段階。
- 直列と違い、どの区画を変えても他の区画の経路は変わらない。設計・デバッグが独立する。

### 原理 B: 時間特徴の差を「数サンプル以上」にする

40 SPS（25 ms 間隔）なので、区画間の立ち上がり・半値幅の差は **50 ms 以上**、できれば 2 倍刻みを狙う（`pneumatic-filter-design-20260920.md:125-128` の設計目標）。

| 区画 | 狙う時定数 | 流路の例（d × L） | L/d⁴（相対抵抗） |
|---|---:|---|---:|
| 胴体・背中 | 直結 | なし | 0 |
| 尾 | 〜50 ms | φ2.0 × 8 mm | 0.5 |
| 足（4本で4段階） | 〜80 / 120 / 180 / 270 ms | φ1.6 × 10 / φ1.5 × 15 / φ1.4 × 20 / φ1.3 × 25 mm | 1.5 / 3.0 / 5.2 / 8.8 |
| 頭 | 〜400 ms | φ1.2 × 35 mm | 16.9 |

- 相対抵抗は 0.5 → 17 で約 30 倍。実際の τ は壁のコンプライアンス（TPU の膨らみ）で決まり、**寸法だけでは予測できない**。だから試験片で測る（5節）。
- 遅くしすぎると「約1秒押す」操作と 4 秒タイムアウトに合わない（`pressure_features.c` の `TIMEOUT_MS`）。上限は 400〜500 ms。
- TPU の FDM で安定して開く最小径は約 1.0〜1.2 mm。細い流路は**隔壁を 4〜5 mm に厚くして、その中に蛇行させる**と、サポートなしで印刷できる。

### 3b. 採用する原理: 壁の力学で区画ごとの「押し心地」を変える

空気はほぼ瞬時に均圧するので、センサーが見るのは**全体積の変化 ΔV(t) の時間変化**（と漏れ）。ΔV(t) は押した区画の壁がどう沈み、どう跳ね返るかで決まる。だから区画ごとに壁の力学を変えれば、同じ指の動きでも ΔV(t) の形が変わる。

| 設計変数 | 波形への効き方 | 強さへの依存 |
|---|---|---|
| 壁厚（0.8〜2.0 mm） | 薄いほど同じ力で大きく沈む（振幅）。復元の速さも変わる | 振幅は強さに依存するが、復元時定数（c/k）は線形域ならほぼ依存しない |
| ドーム（薄い球面の押し面） | 沈み込みが非線形。深く押すと急に沈む（スナップ）→ 山が 2 段になる | 形の特徴（2 段）は強さにある程度頑健 |
| 蛇腹・リブ | 復元が遅く、谷が浅く長い | 時定数は材料で決まる |
| 押し面の面積 | 同じ沈み込みで ΔV が変わる | 振幅のみ |
| 区画の容積 | 同じ ΔV で圧力が変わる（C = V/γp₀） | 振幅のみ |

狙い: 4 分類なら「速い・浅い（背中: 厚い壁）」「速い・深い（しっぽ: 薄い壁、小容積）」「遅い復元（足: リブ付き）」「2 段の山（頭: ドーム）」のように、**時間・形の特徴**で分ける。足 4 本の区別はこの方式でも難しいので、4 分類を目標にする。

TPU 85A への変更は、同じ力で沈みが大きく（信号が増える）、復元が遅くなる方向。既存の学習データは 95A のものなので、v2 では必ず取り直す。

### 3c. 漏れの扱い

現在の「押している間に戻る」挙動は漏れ由来の可能性が高い。漏れが**センサー側の継手やチューブ**にあるなら、全区画に共通の形を作っていて、区画差を薄めている。
- 10/15 に確認: 恐竜を 5 秒押し続けて圧力が 0 に戻るか。戻るなら漏れ。チューブをセンサー直近でつまんで再試験し、場所を絞る。
- 漏れを塞ぐと波形は「押している間は一定、離すと戻る」に変わり、特徴抽出（減衰の交差点を要求）が失敗する可能性がある。塞ぐかどうかはシミュレーションと実測で決める。意図的に漏れを残すなら、量を再現できる形（小さな穴）にする。

### 3d. シミュレーション結果（10/15、`tools/pneumatic_sim.py`）

集中定数モデルを実しっぽ波形で校正（残差 0.041、`docs/analysis/2026-10-15-pneumatic-sim/calibration.png`）し、7 区画 × 30 回の押下（強さ 0.5〜1.5 倍、速さもランダム）を 40 SPS でサンプリングして、ファームウェアと同じ 12 特徴量で最近重心法の一回抜き精度を出した。

| 構造 | 7 分類 | 4 分類 | 頭 vs 足 | 読み方 |
|---|---:|---:|---:|---|
| 現行（全区画同じ壁、φ2.5 穴） | 16% | 21% | 46% | 偶然と同じ。**モデルも「今の恐竜は場所を区別できない」と言っている** |
| 星形・流路 φ1.2〜2.0（昨日の案） | 23% | 25% | 62% | 流路では差が出ない（0 節の裏付け）。1 kHz で見ても区画間の遅れは 4〜15 ms |
| 壁の硬さ k だけ区画ごとに ×0.5〜2 | 30% | 51% | 72% | 振幅は変わるが、特徴量が振幅で正規化されているので効きが弱い |
| **沈み込みの時定数 τ = c/k を区画ごとに変える**（尾 ×0.25、背中 ×0.5、足 ×1、頭 ×4） | 48% | **95%** | **100%** | 効く特徴は山の幅・減衰（η² 0.95）。強さを 3 倍変えても壊れない |
| τ ＋ 跳ね返りの速さも区画ごと | 53% | 96% | 100% | — |
| τ を足 4 本でも ×0.7/1/1.4/2 に分ける | 68% | 75% | 88% | 7 分類は 1.4 倍刻みでは足りない |
| τ ＋ 跳ね返り、7 区画 | **79%** | 87% | 100% | 7 分類の上限の目安 |
| 現行、漏れを塞ぐ | 14% | 20% | 52% | 塞いでも区別はできない（振幅は 5 倍） |
| τ 設計、漏れを塞ぐ | 53% | 92% | 100% | 漏れの有無は本質ではない |

**結論**: 場所を分けるのは「押した壁がどれだけ速く沈み込むか」（τ = c/k）。これを区画ごとに 2 倍以上ずらせれば 4 分類 90% 超が見込める。流路設計・漏れ対策・壁の硬さだけでは届かない。

**物理の注意**: c/k は壁材料の遅延時間に近く、均質な TPU 壁では厚さを変えても k と c が一緒に変わって c/k が変わらない可能性がある。だから**形で τ を作る**: 薄い膜（速い）、スナップするドーム（段付き）、蛇腹（遅い）、格子（ジャイロイド）で中を埋めた区画（空気と壁の両方に減衰）。どれが実際に τ を変えるかは試験片で測るしかない。

**区画への割り当て（10/15 追加）**: 一番遅い区画は山が小さくなり（τ ×4 で約 150k counts）、採用閾値 100k に近づいて INVALID が出る。遅い役は押し面が広い**背中**に、速い役は押しにくかった**頭**に割り当てる。

| 割り当て | 4 分類 | 頭 vs 足 | INVALID（区画別） |
|---|---:|---:|---|
| 頭を遅く（×4）、尾を速く（×0.25） | 95% | 100% | 頭 7/30 |
| **頭を速く（×0.25）、背中を遅く（×4）、尾 ×0.5、足 ×1** | **97%** | 100% | 背中 2/30 |
| 頭 ×0.25、足 ×2、背中 ×0.5、尾 ×1 | 86% | 100% | 0 |

つまり v2 の設計は: 頭＝薄い膜かドーム（速く沈む、押しやすい）、背中＝蛇腹や格子で遅く、尾＝やや速く、足＝基準。

**その他の注意**（implementer の指摘）:
- 漏れを完全に塞ぐと山が 3〜4.6M counts になり、基準値 3.94M と合わせて 24 bit（8.39M）を超えて ADC が飽和する。漏れは塞がない（または塞ぐならゲインを下げる）。
- シミュレーターは壁を質量なし・線形としている。ドームのスナップや蛇腹の非線形は入っていないので、形による τ の変化は試験片でしか分からない。

**10/15 の試験片（確定版、STL 生成済み）**: `3d-models/test-pieces/`（`tools/make_test_pieces.py`、README に印刷順と測定手順）。
Hide の制約で**最小肉厚 1.5 mm**（0.8 mm の TPU は破れる・穴があく）。薄膜 0.8 とジャイロイド充填は取り下げた
（充填はスライサーの内壁で空気経路から切り離されるので空気圧要素にならない）。
1. 平面 1.5 mm（基準）
2. 平面 2.5 mm（硬さだけ変える対照）
3. 球面ドーム 底半径 12・高さ 5・壁 1.5（スナップ候補）
4. 蛇腹 3.5 山・振幅 3・壁 1.5（遅い復元候補）
5. 平面 1.5 mm・奥行 5（容積 1/3。圧力フィードバック k_eff = k + A²/C の確認）
測るもの: 各 10 回（強弱混在）の `width_ms`、`decay_ms`、`recovery_ms`。**go 条件: 5 種類のうち 4 種類以上で幅・減衰が互いに 2 倍以上違い、強弱で順序が変わらない。**
壁厚はシミュレーションでは k（硬さ）に入る。厚さだけでは「硬さだけ」の行（4 分類 48〜51%）が上限で、形（ドーム・蛇腹）で τ が変わるかを試験片で見る。

### 3e. 前提の変更（10/16）: 表面の形は指定され、内部だけを設計する

Hide の目標は「どんな外形でも、押したい場所を指定すれば、内部の空気室・構造を自動設計して 1 センサーで見分ける」こと。
**表面はいじれない**。したがって 3d 節の試験片（ドーム・蛇腹など押し面そのものを変える案）は前提に合わない。
使える設計変数は皮の**内側**だけ:

| 内部の設計変数 | 外から見えるか | 期待する効果 | 試験片 |
|---|---|---|---|
| 内側からの肉厚 | 見えない | 硬さ k（c/k は変わらない予想） | ti2 |
| 皮の裏のリブ | 見えない | 曲げ剛性と減衰 | ti3 |
| 皮の裏の隙間＋第 2 の膜（床に通気） | 見えない | 押し込みの「あそび」= 変位の閾値。遅れて立ち上がる 2 段の山。**閾値なので強さに頑健** | ti4（1.5 mm）、ti5（3.0 mm） |
| 空気室の容積・分割 | 見えない | 圧力フィードバック k_eff = k + A²/C（小） | — |
| 流路の径・長さ | 見えない | **効かない**（0 節） | — |

試験片は `3d-models/test-pieces-internal/`（`tools/make_test_pieces.py --set internal`）。外形は 5 個とも同じ。
go 条件: ti1 / ti4 / ti5 が強弱混在でも 8 割以上分かれること（あそびが設計変数になる証拠）。
**結果（10/21）: go。** 3 分類 97.2%（n = 16 / 10 / 10）、減衰時間の比 ti1/ti4 = 2.9、ti1/ti5 = 2.4。あそびのある片は山の後に急に落ちる。詳細は `docs/analysis/2026-10-21-test-pieces/`。

### 4b. 自動設計への道筋（表面固定）

1. **部品ライブラリ**: 「あそび d mm の第 2 膜」「リブ密度」「局所肉厚」を部品にし、それぞれの波形署名を試験片で実測する（10/16〜）。
2. **設計器**: 外形メッシュと押したい場所の一覧を入力。各場所に互いに区別できる部品を割り当て、皮の内側に CSG で付ける（`make_test_pieces.py` の `add_gap_membrane` / `ribs` がそのまま種）。内部は 1 つの空洞でよく、穴は大きくてよい（流路は効かないので配管設計は不要。これは制約ではなく簡単化）。センサー口を 1 か所。
3. **予測**: 集中定数シミュレーターに、部品ごとに実測した (k, c, あそび) を入れて分離精度を予測し、割り当てを選び直す。あそびは「変位の閾値」としてモデルに追加する（現状は線形壁のみ）。
4. **検証**: 恐竜 v2 を、この手順で設計した最初の物体にする（外形は現行 STL のまま、内側だけ変える）。

別の原理として、ポンプで微小な流れを作り、皮の裏の流路を押しつぶすと流路抵抗ネットワークの分圧が変わる方式（AirTouch の穴を皮の下に移したもの、Sariola らのタッチパッドと同じ）がある。
静的な値で読めるのでサンプリング速度も指の速さも関係なく、設計は回路計算で閉じる。ただしポンプが要る。審査後の選択肢。

### 3f. 恐竜 v2 の設計（10/21、STL 生成済み）

`tools/make_dino_v2.py --gap 2.5` → `3d-models/dino-air-v2-leg-gap.stl`（断面図 `.png`、寸法 `.json`）。
外形は v1 の STL そのまま。変更は足 4 本の内側だけ。

| 要素 | 寸法 | 役割 |
|---|---|---|
| スリーブ（第 2 の膜） | 足の内壁から 2.5 mm 内側、壁 1.5 mm。各段は下と上の断面の輪の和（2 mm 刻み）で隣の段と必ず重なり、最下段は足の裏の壁に 1.5 mm 埋め込む | 皮が 2.5 mm 沈んでから当たる |
| 天井（円錐） | 足の空洞の上端で、スリーブの外面が 0.5 mm 刻みで外へ広がり 45° で皮に届く | ポケットを主室から密閉。サポートなしで自立 |
| 通気穴 | φ1.2 mm、足の中ほどの高さ、内もも側（胴体中心線に向く） | ポケットを外気に通じさせる。**外形への唯一の変更** |

- **印刷性（10/21 に Hide の指摘で修正）**: 最初の版はスリーブ最下段が足の裏の曲面の上で浮いていた。修正後、層ごとに「0.6 mm 以内の真下に材料があるか」を検査する `support_check` を追加。挿入部の範囲で宙に浮く材料の割合は最大 3〜9%（45° の段差分）。足と胴体の付け根の 10〜16% は v1 と同じ値で、v1 はそのまま印刷できている。
- 確認済み: 各足の中ほどの断面で 4 つの閉曲線（皮の外・内、スリーブの外・内）、フランジ高さで 2 つ（ポケットが塞がっている）、その上でスリーブ内側が開いている。メッシュは閉じている（TPU 体積 68.5 → 74.3 cm³）。
- あそび 2.5 mm は試験片の 1.5（ti4）と 3.0（ti5）の間。どちらも基準と 95% 以上分かれたので中間値を採用。
- 頭・背中・しっぽは変更なし（しっぽと背中はすでに分かれ、頭は「あそびなし」側として足と対比する）。
- 後ろ足のスリーブ内側は上端で 5×10 mm と細い（足が上に向かって細くなるため）。空気の通り道としては十分。
- 材料は 85A。v1（95A）のデータは使えないので、学習データは v2 で取り直す。

### 原理 C: 押す場所を「押しやすい形」にする（首の問題）

- 首は細くて押しにくい。**頭を大きめの独立した空気室**にし、頭頂か額に平らな面を作る。壁は 1.0〜1.2 mm で、他より押しやすくする。
- 各区画の「押す面」は壁 1.2 mm、構造を支える部分（胴体の底、脚の付け根）は 2.0 mm。局所的に押せて、全体がつぶれないようにする。
- 足は裏（足の裏）ではなく、横か上から押す前提で平面を用意する。

### 原理 D: センサー取り出し口は胴体に

- 今は尾の先端。v2 では胴体の底か背中の裏から出す。尾も独立した区画になり、センサーのチューブが尾を引っ張らなくなる。

---

## 4. v2 で期待できること・できないこと

| 期待 | 根拠 | 不確実性 |
|---|---|---|
| 頭 vs 足の分離が明確になる | 頭だけ長い細管を通る。時定数 3〜5 倍 | 壁コンプライアンスが大きいと τ が想定より短く、差が縮む |
| 足4本の区別（7分類） | 流路を4段階にできる | 4段階の差（1.5倍刻み）が操作ばらつきを超えるかは未知。まず 4 分類で安定させ、7 は追加で評価 |
| 押す強さへの頑健性 | 時定数は強さに依存しにくい（線形域） | 強く押すと壁が大きく変形して非線形になる |
| 「構造が符号化している」と言える | 流路を設計し、波形の時定数が設計通り並べば直接の証拠 | 並ばなければ、現状と同じく「局所変形」が支配していると分かる（それも成果） |

---

## 5. 10 日間での進め方（再印刷トラック）

印刷機は無人で動くので、人の時間を使うのは CAD・試験・収録だけ。ファームウェア（teach モード）は implementer エージェントが並行して進められる。

| 日 | 作業 | 判断 |
|---|---|---|
| 10/15（木） | **（訂正後）試験片**: 同じ胴体室（40×40×30 mm、壁 1.5）に、**押し面の力学だけが違う**押す室を 4 種類（壁 0.8 mm 平面 / 1.6 mm 平面 / 1.0 mm ドーム / 1.2 mm リブ付き）。流路は全部 φ2.5×1.5。対照として φ1.0×40 の流路片を 1 つ（モデルの「差が出ない」予測の確認）。材料は 85A。各 1〜2 時間。同日に既存恐竜の独立評価と**5 秒押し続けの漏れ確認** | — |
| 10/16（金） | 試験片を同じセンサーで計測: 各 10 回押す（強・弱を混ぜる）。12 特徴量（`tools/analyze_pressure.py`）で押し面ごとの分離を見る。シミュレーションの予測と比較 | **Go**: 押し面の違いで 4 種類が最近重心法で 8 割以上分かれ、強弱で順序が入れ替わらない。**No-go**: 分かれない → 再印刷は中止し、現行恐竜＋teach モードに集中 |
| 10/17（土） | 恐竜 v2 の CAD（区画ごとの押し面の力学を試験結果で決める、頭の押し面、胴体にセンサー口、接続は現行の穴のままでよい）。夜に印刷開始 | 印刷は約 10 時間（Hide 実績、95A）。85A は同程度と仮定 |
| 10/18（日） | v2 の気密確認（水没 or 保持圧）、センサー接続。4 部位 × 15 回 ＋ 足別ラベルで収録。`tools/generate_pressure_model.py` で埋め込みデータを再生成、ビルド | 波形を重ねて 4 区画の形が目で分かるか |
| 10/19（月） | v2 で独立評価（2 人、各部位 10 回以上）。v1 と同じ手順 | **v2 採用の条件**: v1 より混同行列が良く、ライブで頭が当たる |
| 10/20（火） | 7 分類の評価（余力があれば）。デモ手順固定 | 7 は「できたら」。発表は 4 分類で設計 |
| 10/21（水） | 凍結。v1 / v2 どちらで発表するか決定 | — |

### リスクと手当て

| リスク | 手当て |
|---|---|
| 印刷失敗・気密不良（TPU の層間漏れ、細い流路の閉塞） | 試験片で層設定を先に確認。流路は φ1.2 以上。本体は 10/17 夜〜10/18 で 1 回しか印刷できないので、試験片で設定を固める |
| v2 でも差が出ない | 10/16 の go/no-go で止める。そこまでの損失は 1.5 日 |
| 収録・評価が v1 と v2 で二重になる | v1 の独立評価は 10/15 に済ませる。v2 の評価は 10/19 の 1 日 |
| 発表直前に新しい物体に切り替える不安 | 10/21 に決める。v2 が安定しなければ v1 で発表し、v2 は「次の設計」としてスライド 1 枚で見せる（試験片の波形だけでも説得力がある） |

---

## 6. 発表での使い方

- v2 が成功した場合: スライド 2「空気の回路」で v1 → v2 の変更を**設計の物語**として話す。「v1 は穴が大きすぎて全身がひとつの部屋だった。流路の径と長さで時定数を設計し直した v2 では、区画ごとに波形の形が変わる」。7 本の重ね描き波形を 1 枚出す。
- v2 が間に合わなかった場合: 試験片の波形（流路で立ち上がりが変わる図）を「次の設計」として見せる。失敗の原因を物理で説明できること自体が、からあげ氏・栗原氏への答えになる。
- どちらでも: AirTouch とリザバー計算の名前を自分から出し、違いを一文で言う（1 節）。

---

## 7. 結論（Fable の判断）

- **再印刷はやる価値がある。ただし 10/16 の試験片で go/no-go を切る。** 理由: (1) 現状の「頭と足が同じ形」は学習では直らない物理の問題で、記録もそう言っている。(2) 星形トポロジーと流路設計は先行研究 [2][3] に根拠があり、成功すれば「構造が位置を符号化する」が初めて証拠付きで言える。(3) 印刷は無人で走り、ファームウェアはエージェントが並行して作れるので、人の時間の競合は収録・評価の 2 日だけ。
- **現行恐竜（v1）は捨てない。** 10/15 に独立評価を取り、安定版として最後まで残す。
- **teach モードは v2 とも両立する。** v2 で精度が上がっても操作者差は残るし、Solist-AI 活用度の評価は teach モードで取る。
- 印刷時間は約 10 時間（Hide 実績）。次は押しやすさ重視で TPU 85A。CAD の元データが編集可能かは未確認。

## 参考文献

1. Tejada, Ramakers, Boring, Ashbrook. "AirTouch: 3D-printed Touch-Sensitive Objects Using Pneumatic Sensing." CHI 2020. https://dl.acm.org/doi/10.1145/3313831.3376136 （コード: https://github.com/ctejada10/airtouch ）
2. Kawase, Miyazaki, Kanno, Tadano, Nakajima, Kawashima. "Pneumatic Reservoir Computing for Sensing Soft Body: Computational Ability of Air in Tube and Its Application to Posture Estimation of Soft Exoskeleton." Sensors and Materials, 2021. https://www.researchgate.net/publication/354087261
3. "Tactile perception through fluid–solid interaction." Nature Communications, 2026. https://www.nature.com/articles/s41467-026-72497-3
4. Lampinen, Koivikko, Pihlajamäki, Sharma, Sariola. "Soft Pneumatic Tactile Pressure Sensor Matrix." Soft Robotics Reports, 2024. https://doi.org/10.1089/rorep.2024.0034
5. Savage et al. "Lamello." CHI 2015. https://people.eecs.berkeley.edu/~bjoern/papers/savage-lamello-chi2015.pdf ／ Tejada, Ashbrook. "Blowhole." 2018. http://danielashbrook.com/pubs/2018%20Tejada-Blowhole.pdf ／ Laput et al. "Acoustruments." CHI 2015.
