CreatorKanata/pneutouch-ai-rehc2026/docs/final-judging/retrain-85a.md

# 85A 恐竜の再学習手順

作成日: 2026-10-21。印刷が終わった新しい恐竜（TPU 85A）を、
**訂正（10/22、Hide）**: 印刷したのは v2（`dino-air-v2-leg-gap.stl`）ではなく、**9 月と同じ v1 の STL を 95A から 85A に変えて印刷したもの**。
この文書の「v2」「あそび」「通気穴」「ポケット」に関する記述は該当しない（残してあるのは経緯の記録として）。足の山が低いのは 85A で足の皮が柔らかく容積が小さいためで、設計によるものではない。
いまのファームウェアで**一から学習し直す**ための手順。この文書だけで作業が完結するように書いてある。

9 月のデータは 95A の恐竜のもので、85A は同じ力で沈みが大きく復元が遅いので、**混ぜずに全部取り直す**。
9 月と違い、C の再生プログラム（Windows の exe）は使わない。MCU 自身が送る 12 特徴（`# PNEF1`）をそのまま学習データにする。

## 0. 全体の流れ

| 段階 | やること | 道具 | 目安 |
|---|---|---|---|
| A | 気密とセンサー接続 | 手 | 10 分 |
| B | **簡易チェック**: 4 部位 × 5 回。足と頭で減衰が変わるか、旧モデルがどう間違うか | `capture_live_calibration.py` → `prepare_retrain.py` | 20 分 |
| C | **本収録**: 4 部位 × 15 回以上（強弱混在、足は 4 本を均等に） | 同上 | 40 分 |
| D | 学習データ生成 → ヘッダー再生成 → ビルド → 書き込み | `prepare_retrain.py` → `generate_pressure_model.py` → LEXIDE-Ω | 30 分 |
| E | 独立評価（部位をランダム順、2 人） | `monitor_live_demo.py` | 30 分 |

B で足と頭の減衰比が 2 倍に届かなくても C 以降はそのまま進める（85A だけでも再学習は必要）。
B の結果は収録を止める条件ではない（v2 を印刷した場合だけ設計の判断材料になる）。

## A. 準備

1. センサーのチューブを尾の先の口に差し込む（9 月と同じ深さ）。モジュールとボードの配線は試験片のときと同じ。
2. （v2 を印刷した場合のみ）足の内もも側の φ1.2 mm の通気穴 4 つがバリで塞がっていないか針で確認する。**今回の 85A 恐竜は v1 の形なので不要。**
3. 気密: 背中を 5 秒押し続け、学習ツールのグラフで圧力が戻りきる前に離す。急に抜けるなら漏れ。
4. ボード電源 ON、CN9 の USB を Windows PC へ。LCD に `READY`。**書き換えは不要**。LCD の HEAD/LEGS 表示は 95A のモデルの推定なので、当たらなくてよい。

## B・C. 収録（Windows、COM7）

部位ごとに 1 ファイル。ファイル名の先頭が部位名で、解析はこれをラベルにする。

```sh
python tools/capture_live_calibration.py --label HEAD --output captures/dino-85a/head-20261021-1.csv --seconds 90
python tools/capture_live_calibration.py --label BACK --output captures/dino-85a/back-20261021-1.csv --seconds 90
python tools/capture_live_calibration.py --label LEGS --output captures/dino-85a/legs-20261021-1.csv --seconds 120
python tools/capture_live_calibration.py --label TAIL --output captures/dino-85a/tail-20261021-1.csv --seconds 90
```

- 開始表示が出てから **押さずに 3 秒待つ**。「約 1 秒押して離し、3 秒待つ」を繰り返す。時間内に終わらなければ Ctrl-C で止めてよい（途中までの記録は残る）。
- 強さは弱・普通・強を混ぜる。弱すぎると `INVALID` になり学習に入らない（それでよい）。
- **LEGS は 4 本の足を順番に回す**（右後ろ → 左後ろ → 右前 → 左前 → …）。足の横か上を押す。足の裏は押さない。
- HEAD は頭頂か額。首は細くて押しにくいので頭だけにする。
- 同じ部位を追加で取るときはファイル名の末尾を `-2` にする。ファイルは上書きされない。
- 簡易チェック（B）は各 5 回で止め、C で各 15 回以上を**別ファイル**（`-2`）に取る。解析は同じフォルダーの全ファイルを使う。

1 ファイルにつき `.csv`（生サンプル）、`.json`（件数と周期）、`.uart.log`（MCU の `# PNEE1 / PNEF1 / PNEC1`）ができる。3 つとも Mac の同じフォルダーに置く。

## D. 学習データ → ヘッダー → ビルド

Mac（`.venv`）で:

```sh
.venv/bin/python tools/prepare_retrain.py captures/dino-85a --out docs/analysis/2026-10-21-dino-85a
```

`docs/analysis/2026-10-21-dino-85a/summary.md` を見る。

1. **部位ごとの件数**: `kept` が各 10 以上。足りない部位は追加収録（`-2`, `-3`）。
2. **旧モデルの混同行列**: 95A のモデルを 85A の恐竜に当てたときの正解率。発表で「素材を変えたら当たらなくなった → 学習し直したら戻った」と言うための数字。
3. **一回抜き最近重心法の 4 分類**: 学習データの中での分かれ方（9 月と同じ、同日・同一操作者の値）。
4. **v2 チェック**（summary.md の「v2 check」）: 頭 ÷ 足の減衰時間の比。v2 を印刷した場合の確認項目で、今回の v1 形状では参考値。
5. 末尾の「次のコマンド」が出ていれば:

```sh
.venv/bin/python tools/generate_pressure_model.py --input docs/analysis/2026-10-21-dino-85a/pressure-demo-training.json
```

これで `src/pneutouch-solist/S_PneuTouch/pressure_model_data.h` が書き換わる（起動時学習の埋め込みデータ、正規化の平均とスケール、HEAD/LEGS 専用モデルの分も）。

Windows（LEXIDE-Ω）で: プロジェクトを Refresh → **Debug** でビルド（エラー・警告 0 を確認）→ **PneutouchAi Write** で書き込み → 電源を入れ直して LCD `READY`。
起動時学習が失敗すると `AI ERROR`。件数が 255 を超えるか特徴に 0 があると生成時に止まる。

書き込んだ HEX は `demo-v2` のバックアップとして別名保存する（95A 用の HEX は残す）。

## 2026-10-22 の変更（足の検出としきい値、モデル入力）

- **検出しきい値**: `TRIGGER_COUNTS` を 50000 → 30000、`MIN_PEAK_COUNTS` を 40000 → 25000 に下げた（`pressure_features.c`）。85A の恐竜では足を押したときの正の山が 30〜88k カウント（中央値 49k）しかなく、50k では大半を取りこぼしていた。30k にすると収録ファイルごとに約 20 回の足押しのうち 13〜23 回を検出し、頭・背中・しっぽのファイルでは余分な検出は 0 回だった。
- **モデル入力**: 主モデル（4 分類）と HEAD/LEGS 専用モデルの両方で、入力 5 を「正の山 / 1000 カウント」、入力 10 を「谷の大きさ / 1000 カウント」に置き換えた（それ以外の 10 個は形の特徴のまま。12 個とも対数 → 平均・スケールで正規化するのは従来どおり）。形だけの 12 特徴では一回抜き最近重心法の 4 分類が 72% だったのに対し、山と谷の絶対値を入れると 96% になった。部位ごとの山は LEGS 30〜88k、HEAD 78〜130k、TAIL 91〜281k、BACK 477〜977k。
- **リスク**: 山と谷の大きさは押す強さで変わる。デモでは学習時と同じくらいの強さで押すこと。収録では各部位とも弱・普通・強を混ぜて押す。
- **summary.md**: 一回抜きの結果に 2 行目「4 zones, model inputs (peak/trough replace inputs 5/10)」（実際のモデル入力での正解率と混同行列）が増えた。モデルの見込みはこちらを見る。
- **書き込みが先**: 検出しきい値も入力の置き換えもファームウェアの中にあるので、評価や収録の前に必ず LEXIDE-Ω でビルドして書き込む（古いファームのままだと足が検出されず、入力も旧ルールのまま）。

## E. 独立評価

[plan-10days.md](plan-10days.md) の「独立評価の取り方」のまま: 2 人、部位をランダム順に混ぜ、正解を声に出して記録者が書く。各部位 10 回以上。

```sh
python tools/monitor_live_demo.py --port COM7 --seconds 600 --output build/live-85a-eval-1.json
```

`# PNEC1` の推定と正解の混同行列を出す。**v2 採用の条件は、9 月の v1（ライブの HEAD/LEGS が約 50%）より混同行列が良く、ライブで頭が当たること。**
採用なら発表スライドの数字を差し替える（[presentation-5min.md](presentation-5min.md)）。足りなければ、同日のうちに C を追加して D をやり直す。

## 注意

- 学習データは同日・同一操作者のものなので、`summary.md` の 4 分類精度は発表に使わない。使うのは E の混同行列。
- `# PNEC1` の推定文字はラベルにしない（ファイル名の部位だけが教師情報）。
- 足 4 本を区別する 7 分類は、E で 4 分類が安定してからにする。

## 結果（10/21 夜、1 回目の収録）

4 部位を Mac で収録（`captures/dino-85a/*-20261021-1.csv`、各 90〜120 秒、欠番 0、39.7 SPS）。

**見つかった問題**: ファームウェアは「山の高さ 100,000 カウント以上」でないと波形を捨てる（`pressure_features.c` の `extract`）。
85A の恐竜では足の山が 49k〜88k、頭が 78k〜130k しかなく、**足は 14 回すべて、頭は 20 回中 8 回が INVALID** になった（背中は 480k〜980k、尾は 90k〜280k で問題なし）。
足の山が低いのは、85A で足の皮が柔らかく、足の容積が小さいため（当初は v2 のあそび設計によるものと書いたが、印刷したのは v1 形状だった）。

**対処**: しきい値を 40,000 に下げる（`MIN_PEAK_COUNTS`）。Mac でファームウェアと同じ C の特徴抽出を再生（`tests/replay_pressure_features.c`）すると、100k では MCU の送った特徴と完全に一致し、40k では 4 部位すべての押下が採用された。

| 部位 | 押下 | 100k で採用 | 40k で採用 | 山の中央値 |
|---|---:|---:|---:|---:|
| HEAD | 20 | 12 | 20 | 108k |
| BACK | 22 | 21 | 21 | 736k |
| LEGS | 14 | 0 | 14 | 65k |
| TAIL | 25 | 23 | 25 | 173k |

**40k で再生した 80 波形の分かれ方**（12 の振幅なし特徴、一回抜き最近重心法。同日・同一操作者の値）:

| 指標 | 85A（10/21） | 95A（9/20、同じ計算） |
|---|---:|---:|
| 4 分類 | **87.5%** | 72% |
| HEAD vs LEGS | **94.1%** | 56% |
| TAIL vs BACK | 95.7% | 97% |
| 旧モデル（95A 学習）をそのまま当てた正解率 | 41%（全部 TAIL と答える） | — |

足と頭を分けているのは主に**離したときの立ち上がり時間**（LEGS 462 ms、HEAD 61 ms、7.6 倍）と谷/山の比（2.7 対 1.4）。
押したときの減衰は HEAD 64 ms、LEGS 100 ms、TAIL 185 ms、BACK 113 ms で、頭が最も速い。
差は「足は離したときに主室へ戻る空気がゆっくり」という形で出た（当初はあそびのポケットのせいと書いたが、v1 形状なので理由は 85A の足の皮の復元の遅さと考えられる）。

| 部位 | 立ち上がり | 減衰 | 山の幅 | 離した立ち上がり | 回復 | 谷/山 |
|---|---:|---:|---:|---:|---:|---:|
| HEAD | 75 | 64 | 77 | 61 | 44 | 1.4 |
| BACK | 132 | 113 | 122 | 180 | 44 | 1.2 |
| LEGS | 124 | 100 | 130 | **462** | 55 | **2.7** |
| TAIL | 123 | 185 | 195 | 65 | 59 | 2.6 |

（ms、中央値。谷/山は比）

**残る疑問**: 押し続けても圧力が 100 ms 程度で抜ける（山の幅の中央値 77〜195 ms、9 月は 180〜250 ms）。
85A は 95A より薄い壁から空気が抜けやすい可能性がある。背中を 5 秒押し続ける記録で確かめる。漏れていても分類は上の数字のとおり成り立つ。

**生成済み（10/21 夜）**: `prepare_retrain.py --replay build/replay_pressure_features` → 80 件 → `generate_pressure_model.py` で `pressure_model_data.h` を再生成（本体 80 例、HEAD/LEGS 専用 34 例）。
ファームウェア側は `pressure_features.c` の `MIN_PEAK_COUNTS 40000`（旧 100000）。Mac の全テスト（C・Python・Node）通過。
**次**: Windows の LEXIDE-Ω で Refresh → Debug ビルド → PneutouchAi Write。書き込み後に独立評価（E 節）。足の追加収録（`legs-20261021-2`）が入れば同じコマンドで再生成する。

## 結果（10/22、2 回目: 足が検出されない問題と対処）

10/21 のモデルを書き込んだところ、**足を押しても検出されないか、されても TAIL** になった（Hide の確認）。
足の追加収録（`legs-20261022-2`、約 20 回）では MCU の検出が 3 回だけ。原因は 2 つ。

1. **検出のしきい値**: 足の正の山は 30〜88k（中央値 47k）で、トリガー 50k を 2 サンプル連続で超えないものが大半。→ `TRIGGER_COUNTS` 30000、`MIN_PEAK_COUNTS` 25000。6 ファイルの再生で、足は 13〜23 回／約 20 回を検出し、頭・背中・しっぽでは誤検出なし（上の「2026-10-22 の変更」）。
2. **形だけでは足としっぽが分からない**: しきい値を下げて足のイベントを全部集めると、振幅なし 12 特徴の一回抜き 4 分類は 73.5%（LEGS 51 件中 27 件が TAIL・BACK に混ざる）。山の高さは部位でほぼ重ならない（LEGS 30〜88k、HEAD 78〜130k、TAIL 91〜281k、BACK 477〜977k）ので、入力 5・10 を山と谷の絶対値に置き換えた。

**生成済み（10/22）**: `prepare_retrain.py captures/dino-85a --out docs/analysis/2026-10-22-dino-85a --replay build/replay_pressure_features` → 117 件（TAIL 25、BACK 21、LEGS 51、HEAD 20。足は 10/21・10/22 の 3 ファイル）→ `generate_pressure_model.py` で `pressure_model_data.h` を再生成（本体 117 例、HEAD/LEGS 専用 71 例）。

| 一回抜き最近重心法（同日・同一操作者） | 形の 12 特徴 | モデル入力（山・谷入り） |
|---|---:|---:|
| 4 分類 | 73.5% | **94.9%** |
| HEAD vs LEGS | 95.8% | 95.8% |
| TAIL vs BACK | 95.7% | 100% |

混同（モデル入力）: LEGS 51 件中 46 正解（TAIL 2、BACK 1、HEAD 2）。他の部位は各 1 件以下の誤り。
**次**: Windows で Refresh → Debug ビルド → PneutouchAi Write → 足を 10 回押して LCD が LEGS になるか確認 → 独立評価（E 節）。
