CreatorKanata/pneutouch-ai-rehc2026/docs/final-judging/what-discriminates.md

# 何で「押した場所」を見分けられるか：文献と計算の総合判断

作成日: 2026-10-18。問い: 外形は指定され変えられない。内部（空気室の形、穴の形・サイズ、経路）だけを設計して、センサー1個で押した場所を見分けるには、**何が情報を運ぶのか**。
根拠: [survey-A 受動流体](survey-A-passive-fluidic.md)、[survey-B 音響](survey-B-acoustic.md)、[survey-C 流れ・構造符号化](survey-C-flow-and-structure.md)、および集中定数モデル（[reprint-design.md](reprint-design.md) 0 節、`tools/pneumatic_sim.py`）。

---

## 1. 結論（1 段落）

**受動（ポンプなし）・空気・圧力センサー1個の現在の構成では、空気室の形も穴のサイズも位置の情報を運ばない。** 文献上そのような実証例はなく（survey-A）、唯一の近縁である Goshtasbi ら（Nature Communications 2026）は同じ形状で空気・水・オイルを比べ、「空気では立ち上がり・立ち下がり時間が位置によらずほぼ同じ」と明記している。計算も同じで、印刷できる穴では空気が数 ms で均圧し、センサーが見るのは押した皮の沈み方だけ。したがって現構成で残る設計変数は**皮の内側の力学**（あそび・リブ・肉厚）だけである。
一方、**空気室の形と穴のサイズが情報になる方式は 3 つある**: (1) **音響**（マイク1個、受動タップまたは能動スイープ）では容積と首の面積・長さがヘルムホルツ共鳴周波数を決める。文献が最も厚く（Zöller/Wall/Brock 2018–2023、CMU 2025）、表面固定・内部設計・ポート1個・ポンプ不要を全部満たす。(2) **液体充填**では穴の径と経路長が流路RCの時定数になる（Goshtasbi 2026 は 100 cSt オイル、φ1〜2 mm × 50〜150 mm）。(3) **ポンプ＋流路抵抗の分圧**では出口（穴）の面積が符号になる（AirTouch 2020: 面積 0.35〜1.45 mm²、**管長は無関係**）が、表面に穴が要る。
推奨は、10/24 の審査は現行＋皮の内側で戦い、その後の本命を**音響（周波数分割した多室設計）**に置くこと。

---

## 2. 方式ごとの比較

| 方式 | 情報を運ぶもの | 空気室の形 | 穴のサイズ | 表面無加工 | 本体内の電子部品 | 必要なサンプリング | 文献の強さ | 主なリスク |
|---|---|---|---|---|---|---|---|---|
| A. 受動・空気・圧力（現行） | 押した皮の力学（沈み方、あそび） | 効かない | 効かない | ○ | なし | 40 SPS で可 | なし（独自） | 操作者差。設計変数が皮の裏に限られる |
| B. 音響・受動（タップ音） | 空気室の共鳴（容積・首）＋タップ過渡 | **効く** | **効く** | ○ | マイクをポートに1個 | 4〜8 kHz | IROS 2018: 8 か所 74.7%（<200 Hz の帯域が最良） | 対称な内部だと左右が区別できない。個体差 |
| C. 音響・能動（スピーカー＋マイク） | 共鳴ピークのシフトと減衰 | **効く** | **効く** | ○ | マイク＋小型スピーカーをポートに | 8〜16 kHz | IJRR 2023: 6 か所 93%、回帰 3.7 mm、20 ms の音で 97〜99.7%。CMU 2025: 非対称内部で 5 点 98.7% | 個体差（転移 35%）、温度（音速 0.17%/°C） |
| D. 液体充填・圧力 | 流路 RC（粘性 × 穴径・長さ） | 容積が C に効く | **効く**（R ∝ L/d⁴） | ○ | なし | 40 SPS で可 | Nat. Commun. 2026（センサー2個、1D 誤差 1.8 mm） | 充填・密閉・重さ・温度でも粘度変化・オイル拡散。1 センサーの実証なし |
| E. ポンプ＋穴塞ぎ（AirTouch） | 出口面積による定常圧 | 効かない | **効く**（面積） | ×（穴が要る） | なし（ポンプは外） | 任意（静的） | CHI 2020: 12 か所 95〜100%、1 サンプル学習 | 表面に穴、SLA が要る（FDM は漏れ） |
| F. ポンプ＋皮下流路の潰し（Sariola） | 流路抵抗の分圧 | 効かない | **効く**（流路断面） | ○ | なし | 任意（静的） | 2024/2025（ただし流路ごとに圧力計） | 1 センサーでの設計は未検証。7 区画で φ0.3〜0.4 mm の絞りが要る（survey-C 5 節） |

---

## 3. 「空気室の形か、穴のサイズか」への直接の答え

- **受動・空気**: どちらでもない。空気の圧縮性による容量（15 cm³ で 1.1e-10 m³/Pa）に対して印刷可能な流路の抵抗が小さすぎ、τ は 0.01〜3 ms（reprint-design 0 節）。サンプリングを 5 kHz にしても変わらない（指の入力が遅く、単独センサーには基準時刻がない）。シミュレーションでも 40 Hz〜5 kHz で正解率は頭打ち。
- **音響**: **両方**。空気室 1 個の共鳴は f = (c/2π)·√(A/(V·L_eff))。容積 6→25 cm³ で 820→402 Hz、首 φ2.5→1.0 mm で 820→407 Hz（6 cm³、L 1.5 mm）。容積と首径を組み合わせれば区画ごとに 300〜900 Hz の別々のピークを割り当てられ（survey-B 4 節の例: φ2/3/4/5 mm → 365/500/625/730 Hz）、押した区画だけピークがシフト・減衰する。CMU の結果は「対称な内部だと左右が区別できず、非対称な内部構造を足すと 98.7%」で、**内部設計そのものが性能を決める**ことを示している。
- **液体**: **穴の径と長さ**（容積は壁コンプライアンスを介して弱く効く）。水で φ1.5×15 mm → τ 14 ms、φ1.2×25 mm → 52 ms、押し抵抗 0.7〜2.6 kPa。40 SPS の窓に入る。
- **ポンプ系**: **穴（出口・流路）の面積**。AirTouch は管長 3〜100 mm が無関係と実測している。

---

## 4. 推奨

### 10/24 まで（変更しない）
現行構成（受動・空気・40 SPS）。位置の情報源は皮の内側の力学。内部だけが違う試験片（`3d-models/test-pieces-internal/`）で「あそび」が設計変数になるかを確かめ、恐竜 v2 は外形そのまま・内側だけ変える。発表では「流路では分からないことを計算と文献で確認し、皮の内側で符号化した」と言える。

### 審査後の本命: 音響・周波数分割設計
理由:
1. 問いへの答えが「空気室の形と穴の両方が設計変数」になり、**自動設計の対象が明確**（場所ごとに容積と首径を割り当てる＝周波数の割り当て）。
2. 表面無加工、内部設計のみ、ポートに MEMS マイク 1 個（能動なら小型スピーカーも）。本体内に配線は不要。
3. 文献が強く、TPU 以外（シリコーン、3D プリント＋バルーン）で 93〜99% が出ている。
4. **個体差が大きい（転移 35%）ことは、その場学習（Solist-AI の teach モード）の必然性になる**。コンテストの物語と一致する。
5. MCU で足りる: 12 bit ADC 8 kHz、256 点 Q15 FFT ≈ 2.3 ms（48 MHz M0+ 推定）、16〜24 帯域エネルギー → 小さな NN。RAM 約 4 KB（survey-B 5 節）。

最初の実験（1 日）: 試験片の胴体室に首径 φ2/3/4/5 mm の小室 4 つを付け、ポートにマイク（スマホの録音でも可）を当ててタップ・押下を録音し、FFT で区画ごとにピークが分かれるかを見る。TPU の減衰で Q がどこまで落ちるかが最大の未知数。

### 条件付きの選択肢: 液体充填
「圧力センサーのまま、穴と経路で設計したい」ならこれ。水＋φ1.2〜1.5 mm の流路で時定数 14〜52 ms。ただし密閉・重さ・温度（粘度）・センサーの液体適合の検証が要り、1 センサーでの実証は世界的にない（新規性でもある）。

### 見送り
ポンプ系（表面に穴、または φ0.3 mm 級の絞りが必要）。流路 RC を空気で狙う案（物理的に不可）。

---

## 5. 残る未確認事項

- TPU 85A の壁での音響減衰（文献はすべてシリコーン・ラテックス・硬質）。
- 受動タップだけで足りるか（IROS 2018 は 74.7%。能動なら 93%＋）。
- 温度・膨らみ具合による共鳴シフト（ピーク比の特徴で相殺できるか）。
- 液体充填の場合の壁コンプライアンス（τ の見積もりは 1e-10 m³/Pa 仮定で ±10 倍の不確かさ）。

---

## 6. 補足（10/21）: 「穴をもっと小さくすれば」はどこまで本当か

元の構想「空気室を小さな穴でつなぐと空気の抜ける時間が変わり、押した場所が分かる」は、方向としては正しい。
否定されたのは**空気・40 SPS・印刷できる穴**という組み合わせで、数字で言うとこうなる（1 区画 15 cm³、0.5 cm³ を 0.1 秒で押す場合）。

| 穴の径 | 長さ | 時定数 τ | 穴の流れ損失 | 備考 |
|---:|---:|---:|---:|---|
| φ1.2 | 35 mm | 1.4 ms | 0.03 kPa | 今の恐竜に近い。見えない |
| φ0.8 | 35 mm | 7 ms | 0.3 kPa | 見えない |
| φ0.6 | 35 mm | 22 ms | 1.0 kPa | 1 サンプル以下 |
| **φ0.5** | **35 mm** | **44 ms** | **2 kPa** | 40 SPS でぎりぎり見える。損失が信号（約 1 kPa）と同程度 |
| φ0.4 | 35 mm | 108 ms | 5 kPa | 見えるが、押しても空気がほぼ移動しない |
| φ0.3 | 35 mm | 340 ms | 16 kPa | 区画が事実上密閉される |

- 見える時定数（50〜300 ms）を作るには **φ0.3〜0.5 mm × 数十 mm** が要る。TPU の FDM で安定して開く穴は約 1 mm が下限で、10 倍小さい。
- しかもその径では穴自体の流れ損失が信号を超え、押した区画の空気がセンサーまで届かなくなる（区画が密閉されたのと同じ）。使える窓は φ0.5 付近のごく狭い範囲。
- 実測でも、今の恐竜（φ2.5）で経路の穴数と立ち上がり時間に相関はなく（経路順 82→149→196→215→134→114→225 ms）、空気で同じ形を試した Goshtasbi ら（2026）は「位置情報が消える」と報告している。

**元の構想を活かす道は 3 つ**（詳細は 2〜4 節）:
1. **印刷せず、細い管を埋め込む**: φ0.4〜0.6 mm 内径の PTFE チューブや注射針を区画間の流路として挿入する。印刷限界を回避できるが、損失と信号の兼ね合いは上の表のとおり狭い。
2. **液体を入れる**: 粘性が 55〜300 倍になり、φ1.2〜1.5 mm の印刷できる穴で 14〜52 ms が出る。
3. **音で読む**: 穴の面積と区画の容積が共鳴周波数を決める（ヘルムホルツ）。穴は大きいままでよく、kHz のマイクが要る。
