CreatorKanata/pneutouch-ai-rehc2026/docs/final-judging/gpt-strategy-draft-20261014.md

# GPT作成の戦略案（原文保存・2026-10-14）

> 注意: この文書は、コードを見ていないGPTが公開情報（ProtoPedia、rehc.jp）から生成した戦略案の原文です。
> 現状把握の記述には実装と食い違う点があります。照合結果と採用方針は [strategy-review.md](strategy-review.md) を参照してください。
> 原文の価値は、競合10作品の分析、審査員ごとの訴求点、5分プレゼンの骨子、想定質疑にあります。

---

# PneuTouch AI — REHC2026 最終審査戦略・開発計画書

作成日：2026年10月14日 / 最終審査：2026年10月24日（土）

# 1. エグゼクティブサマリー

## 1.1 最終審査進出

PneuTouch AIは、32応募作品の中から選出された最終審査進出10作品の一つ。最終審査では3名の審査員によるオンラインプレゼン審査が実施され、受賞作品が決定する。本プロジェクトでは最優秀賞の獲得を目標とする。

## 1.2 PneuTouch AIとは

**One Sensor, Whole-Body Touch.**
柔らかいTPU製の恐竜内部を7つの空気室に分割し、区画間を直径2.5mmの穴で接続する。各部位を押すことで発生する圧力波形を尻尾先端の1個の圧力センサで取得し、特徴量からSolist-AIで接触位置を推定する。将来はぬいぐるみ、ソフトロボット、柔軟なロボット外装などへ展開できる触覚センシング技術を目指す。

## 1.3 中心戦略（差別化の3点）

- **A. 物理構造そのものが触覚情報を生み出す** — 空気室・隔壁・流路・オリフィスが接触位置に応じた圧力応答を作る。物理構造とAIの協調設計。
- **B. 小さなオンデバイスAIで柔軟な物体に触覚を与える** — 小さな特徴量とSolist-AIで分類。
- **C. 現場学習によって物体自身が触覚を獲得する** — 波形取得〜再学習をMCU上で完結させ、ユーザーが触れることで物体自身が新しい触覚を学習する。

## 1.4 最も重要なメッセージ

> センサを増やすのではなく、物体の構造を工夫する。
> これまでセンサではなかった柔らかい物体そのものを、Solist-AIで触覚センサへ変える。

# 2. REHC2026公式情報（要約）

- テーマ: "現場で動くAI"が変える、仕事と日常のアップデート
- 最終審査会: 2026年10月24日（土）13:00〜16:30、オンライン、発表5分（時間厳守）、質疑3〜4分
- 賞: 最優秀賞1作品50万円、優秀賞4作品各10万円。別途 Solist-AIパートナー賞3作品、アイデア賞1作品
- 審査基準: 独創性 / 完成度（動作デモの精度） / Solist-AI活用度（その場で動くAI）。配点比率は非公開

# 3. ロームが求めるエッジAI

Solist-AIの特徴: 小規模NN、オンデバイス学習・推論、小RAM、低消費電力、設置場所・対象物に応じた学習。FAQでは異常検知専用ではないと明記。

PneuTouch AIは接触位置の教師あり分類にSolist-AIを使うが、「異常検知ではない」ことを独創性の中心に据えるべきではない（他作品にも例がある）。重要なのは、Solist-AIで従来と異なる触覚センシング方式を成立させたこと。

ロームにとっての価値: 小型MCUの新用途、センサを多数配置しにくい柔軟構造への適用、現場学習が必要なソフトロボット・玩具、低次元センサデータとエッジAIの組み合わせ、AIと物理構造の協調設計。

# 4. 最終審査員の分析（公開プロフィールからの推定）

## 西村真里子氏（HEART CATCH）
社会・生活への新しい価値、体験や製品への接続、他領域への展開、伝わる魅力。→ 柔らかいものに低コストで触覚を与えられる可能性を訴求。用途は今後の研究課題として説明する。

## 栗原一貴氏（津田塾大学 / Coolied CTO）
既存の発想を覆しているか、驚く体験か、原理が面白いか。→ 「普通の恐竜人形が、なぜ触られた場所を知っているのか？」という驚き。恐竜に電子部品も配線もないことを強調。リアルタイム体験が重要。

## からあげ氏（AIエンジニア）
なぜAIが必要か、特徴量、精度、評価の妥当性、本当にオンデバイスか。→ 12特徴量、4クラス、学習時間、RAM、未使用データ評価、AIなし比較。失敗例を隠さず原因分析と改善方法を提示。

# 5. 最終審査進出10作品の分析

| 作品 | ページ | 概要 | 強み | PneuTouch AIとの関係・差別化 |
|---|---|---|---|---|
| 人間の生体デバイス化による第六感情報の検出と活用 | protopedia.net/prototype/8394 | 心拍・心電図・GSRから無意識の違和感を検出。競馬場で実証 | 独創性・ストーリー性が非常に強い | 「面白い仮説を定量的な物理実験で実証する」方向で差別化 |
| Solistpan | protopedia.net/prototype/9608 | 加速度・振動でアクリル板の打撃位置を推定し音を鳴らす電子楽器 | 1センサで位置推定という仕組みが分かりやすい。デモが楽しい | **技術思想が最も近い**。振動 vs 空気圧、板 vs 柔軟立体、叩く vs 押す。「柔軟物体の内部構造自体を情報を作る回路として設計」を強調 |
| AgriHealth | protopedia.net/prototype/9733 | 農業機械の異常振動を検出しヘルメットの透明OLEDに通知。農家5人、6機種8か所で計測 | 社会課題、現場実証、HW+無線統合 | 社会実装実績では勝てない。完成度の証拠（初見ユーザー、未学習データ）を強化 |
| Plant Doctor | protopedia.net/prototype/9734 | 植物状態の教師なし異常検知と自動給水、結果確認 | 検知→行動→確認の閉ループ | 「接触検出→苦手部位の発見→追加学習→改善」の閉ループで対抗 |
| 複数吸盤対応シングルセンサワーク保持監視 | protopedia.net/prototype/9759 | 共通真空ラインの圧力波形から個別吸盤の吸着不良・微小リークを検出 | **1個の圧力センサで複数箇所の状態推定**。製造業の具体価値 | 既存の真空波形を解析する vs 触覚を生むために空気圧構造を新設計する。「センサが測る対象そのものをAIが認識しやすい構造として設計した」を強調 |
| 触覚で見分けるコンデンサ選別ロボット | protopedia.net/prototype/9760 | 6×3圧力アレイでコンデンサ種類・把持状態を識別し選別 | 実用的ロボットとして完成度高い | 18点アレイで直接取得 vs 1センサで間接推定。精度競争はしない。「表面にセンサを並べずに接触位置を推定」 |
| AIで究極のたこ焼きを焼く | protopedia.net/prototype/9761 | 針で内部温度・電気抵抗を測り焼き加減判定、3D断面表示 | 見えない情報の推定、演出 | 「恐竜の中にセンサがないのにどこを押したか分かる」という驚きを強く表現 |
| はうらへん | protopedia.net/prototype/9767 | ハウリング前兆を学習して先回り音量調整 | 現場適応、オンデバイス学習の必然性 | TPU個体差・経年変化・ユーザー差に現場学習で適応できる可能性を示す |
| RE-2-Solist-AI Gene | protopedia.net/prototype/9777 | IMU 120次元入力で4パターン分類、MIDIでエフェクター制御 | 操作拡張、自然な動きの入力 | 「異常検知以外」は独自ではない。物理センシング原理の新しさで差別化 |
| PneuTouch AI | protopedia.net/prototype/9781 | 本作品 | 物理構造×AI、全身触覚 | 独創性の実証 |

技術思想の近さで警戒すべきは 1. 複数吸盤監視、2. Solistpan、3. コンデンサ選別。総合完成度では AgriHealth、Plant Doctor、コンデンサ選別。

勝負すべき評価軸: **物理構造とAIを一緒に設計して従来と異なるセンシング方式を実現した**価値。その上で実験データで完成度を補強。

# 7. 現状の到達点（GPTの認識。実装との照合は strategy-review.md）

公開仕様: TPU恐竜、7区画、壁1.5mm、穴φ2.5mm、MPS20N0040D、HX710B、40SPS、ML63Q2557、12特徴量、隠れ層32、4クラス、RAM 16KB。
公開性能: 学習60サンプル、学習約0.5秒、推論約5ms、RAM 8,576/16,384バイト、分割評価21/22、未使用データ6/8。

GPTが挙げた課題: 頭と足の波形重複、強さ・速度で特徴が変化、ユーザー差未検証、7分類未完成、「特徴量抽出・学習データ更新の完全なMCU内処理の実装状態の確認が必要」（←特徴量抽出は実装済み。学習データはビルド時埋め込み）。

# 8. 改良戦略

## Strategy A：認識精度の実証（完成度）
未使用データテスト、複数ユーザー評価、混同行列、再現性、AIなし方式との比較。4クラス各20回=80回の未使用データ。目標: 未知データで90%以上（現時点の達成値ではない）。

## Strategy B：Solist-AI活用の進化（再ビルドなしの現場学習）
MCU内で特徴量計算 → FeRAM（2Mbit=256KiB）に特徴量+ラベル+CRCを保存 → PCからラベル指定 → 追加データ保存 → 再ビルドなしで再学習（逐次学習非対応ならまとめて再学習）。
デモ価値: 「新しい触り方を教えるためにファームウェアを書き込み直す必要がない」。

## Strategy C：自分の触覚を改善するAI（Self-Evolving Touch）
誤りやすい部位を特定し「右前足をあと5回押して教えてください」と要求 → 追加学習 → 独立評価で改善確認。苦手クラス選択はMCUの通常プログラム。

# 9. 将来構想：AI-Guided Pneumatic Design
オリフィス径・容積・流路長・壁厚を設計変数とし、分類精度評価から次の内部構造を提案する最適化ループ。Solist-AI単体でCAD生成は非現実的。最終審査では将来構想として紹介し、実装済みと誤認されないようにする。

# 10. スケジュール案（GPT）

| 日付 | 内容 | 成果物 |
|---|---|---|
| 10/14–15 | 現状整理、評価環境固定、安定版保存 | Baseline Demo v1 |
| 10/16–17 | MCU内特徴量生成（←実装済み） | MCU Feature Extraction v1 |
| 10/18–19 | FeRAM保存と再学習 | On-device Learning v2 |
| 10/20 | 4クラス未使用データ収集、複数人、混同行列 | Validation Report |
| 10/21 | 閾値方式 / 簡易分類 / Solist-AI の比較 | AI vs Baseline Comparison |
| 10/22 | スライド、デモ動画、原稿、質疑準備 | Final Presentation v1 |
| 10/23 | リハーサル、時間測定、バックアップ | — |
| 10/24 | 最終審査 | — |

# 11. 改良優先順位（GPT）

| 優先度 | 改良 | 効果 | リスク |
|---|---|---|---|
| S | 現行4分類の安定動作 | 完成度 | 低 |
| S | 未使用データによる精度評価 | 完成度 | 低 |
| S | AIあり／なし比較 | Solist-AI活用度 | 低〜中 |
| A | 特徴量計算のMCU移植 | Solist-AI活用度 | 中 |
| A | 再ビルドなしの学習 | Solist-AI活用度 | 中 |
| A | デモ映像・UI改善 | 独創性・伝達力 | 低 |
| B | Self-Evolving Touch | 独創性 | 中 |
| B | 7クラス分類 | 完成度 | 高 |
| C | 新しい空気室の3Dプリント | 独創性 | 高 |
| C | 空気圧自動調整 | 独創性 | 高 |
| C | AIによるCAD最適化 | 将来性 | 非常に高 |

# 12. プレゼン構成（5分）

| スライド | 時間 | 内容 | メッセージ |
|---|---|---|---|
| 1 たった1個のセンサで全身を感じる恐竜 | 0:00–0:40 | 実際に押して表示を見せる | この恐竜はどこを触られたか分かる。センサは1個 |
| 2 恐竜の中に「空気の回路」を作った | 0:40–1:30 | CAD断面、7空気室、φ2.5mm、尻尾センサ | 電気回路ではなく空気の回路 |
| 3 Solist-AIが触覚を読み解く | 1:30–2:25 | 波形、12特徴量、40Hz、イベント検出、MCU上学習・推論、RAM、時間 | 小さなマイコンでも複雑な波形を学習して分類できる |
| 4 実測データと完成度 | 2:25–3:20 | 未使用データ精度、条件、N、混同行列、失敗例と改善 | 動いただけでなく、どの程度正確か検証した |
| 5 その場で学ぶAI | 3:20–4:10 | 再ビルド不要の現場学習（完成していれば実演） | モノ自身が触覚を覚えることがオンデバイスAIの面白さ |
| 6 恐竜を超える未来 | 4:10–5:00 | トイ、ソフトロボット、ロボット外装、クッション型UI | センサを増やすのではなく物体の構造を賢くする |

# 13. 想定質疑応答（GPT）

- **Q1 なぜ1個のセンサで位置が分かる？** 7空気室を穴で接続しているので、押された場所で圧力の伝わり方が異なり、立ち上がり・減衰・ピークに差が出る。それをSolist-AIで学習。
- **Q2 なぜAIが必要？** 最大値だけでは区別できない場合がある。複数特徴の組み合わせで分類。AIなし簡易方式との比較で有効性を検証。
- **Q3 なぜSolist-AI？** ネットワークなしで小規模センサデータを学習・推論。柔らかい物体への組み込みに適する。オンデバイス学習で個体差・環境に適応。
- **Q4 7区画すべて分類できる？** 設計は7区画、ライブは4分類。7分類は次の目標。
- **Q5 押す強さが変わっても大丈夫？** 波形は変化する。正規化と複数の押し方を含む学習データを検討。強さ別の精度を分けて評価。
- **Q6 既存の空気圧触覚センサとの違い？** 既存研究はある。複雑な柔軟立体物内部に複数空気室を設計し、1センサ+小型オンデバイスAIと組み合わせた実装に挑戦。世界初とは主張しない。
- **Q7 PCが必要では？** 学習・推論はSolist-AI搭載マイコン。PCは可視化・データ管理・動画の補助。
- **Q8 実用化すると？** ぬいぐるみ、ソフトロボット、柔軟外装。耐久性、気密性、個体差、温度、複数同時接触の検証が必要。

# 14. リスクと対策（GPT）

TPU気密不足→リークテスト / 穴径誤差→実測 / 押す強さの個人差→正規化・多様データ / 頭と足の重複→特徴量調整・流路再設計 / 追加学習で悪化→独立評価 / FeRAM不具合→CRC・バックアップ / RAM不足→静的割当 / ライブデモ失敗→録画 / 新機能で退行→安定版分離 / 5分超過→リハーサル。

# 15. 成果物（GPT）

必須: 実機、安定版FW、4分類デモ、Console、構成図、7区画CAD図、実測波形、未使用データ精度、スライド、デモ動画バックアップ。
できれば: AIあり/なし比較、FeRAM学習データ保存、再ビルドなし再学習、複数人テスト、Self-Evolving Touch簡易実装。
将来構想: 7区画完全分類、物理構造最適化、AIによる空気室設計支援、空気圧自動調整、ソフトロボット展開。

# 最後に（GPT）

> 最優秀賞を狙うなら、7分類への拡張より先に、AIの必要性を証明する実験を行う。
> 想定される最も厳しい質問: 「7区画に分けて圧力の伝わり方を変えたのは面白い。でもその違いは単純な閾値でも判別できるのでは？ Solist-AIを使う必要はある？」
> もう一つの大きな差別化は再ビルド不要の現場学習（DT-EBML63Q2557のFeRAM 2Mbit=256KiB）。
> 「ユーザーが恐竜に触る → MCUが波形を解析して記憶する → Solist-AIがその場で学び直す → 触覚が改善する」まで実演できれば、「その場で考え、その場で動くAI」への非常に強い回答になる。

## 参考リンク
- https://rehc.jp/ / https://mashupawards.connpass.com/event/407726/ / https://protopedia.net/event/rehc2026
- https://www.datatecno.co.jp/prod_info/solistai_board_download/
- 作品: 8394, 9608, 9733, 9734, 9759, 9760, 9761, 9767, 9777, 9781（protopedia.net/prototype/番号）
