CreatorKanata/pneutouch-ai-rehc2026/docs/final-judging/presentation-5min.md

# 5分プレゼンの構成と想定質疑

ルール: 5分厳守、作品の特徴・Solist-AI の活用方法・プロトタイプの動作が伝わること、質疑3〜4分（[イベントページ記録](final-judging-event.md)）。
画面共有は自分で行う。スライド共有と手元カメラ（恐竜＋LCD）の切り替えを事前に練習する。

## 構成（teach モードが動く前提。動かなければ 5 を「起動時学習＋独立評価」に差し替える）

| # | 時間 | 画面 | 話すこと | 狙う基準 |
|---|---|---|---|---|
| 1 | 0:00–0:30 | カメラ: 恐竜を押す → 画面の恐竜が反応 | 「恐竜バトルで噛まれた場所に反応してほしかった。でもセンサーは1個しか入っていません」。かなたが自分の言葉で | 独創性・つかみ |
| 2 | 0:30–1:15 | 空気室の図（`images/protopedia/air-chambers.png`） | 中に電子部品も配線もない。7つの部屋が穴でつながり、押す場所で空気の動き方が変わる。センサーが読むのは「大きさ」ではなく「形」 | 独創性 |
| 3 | 1:15–2:00 | 波形と12特徴量の図（`images/protopedia/waveform-features.png`）、構成図 | 40回/秒で測り、マイコンが12個の数にして Solist-AI に渡す。学習も推論もチップの中。RAM 16KB、起動時学習0.5秒、推定5ms | Solist-AI活用度 |
| 4 | 2:00–2:45 | 混同行列（独立評価、操作者2人） | 正直な数字。しっぽ・背中は安定、頭と足は押し方で重なる。原因と「次は頭側の流路を変える」 | 完成度（誠実さ） |
| 5 | 2:45–4:00 | カメラ: ボタン→押す→LCD「LEARNED HEAD」→当たる | **その場で教える。** 別の人が押して外す → その人が5回教える → 当たる。電源を切っても覚えている。PCなし | Solist-AI活用度・独創性 |
| 6 | 4:00–4:40 | 応用図 | ぬいぐるみ、ソフトロボットの外装、クッション。「センサーを増やす代わりに形に覚えさせる」 | 独創性・展開 |
| 7 | 4:40–5:00 | 恐竜のアップ | 「たった1個のセンサーで、やわらかい物体の全身に触覚を。そして、恐竜自身が学びます」 | — |

- 1 と 5 がライブ。どちらも失敗したら即座に録画に切り替える（録画はスライドと別ウィンドウで待機）。
- 押し方は本番前に固定: 約1秒押して離す。速すぎると TAIL に寄る（`docs/live-pressure-demo-20260920.md:100-101`）。
- 数字はスライドに置き、口では「しっぽと背中はほぼ全部当たる、頭と足は半分くらい」のように言う。

## 想定質疑（根拠付き）

**Q. なぜ1個のセンサーで場所が分かる？**
7つの部屋が穴1個ずつで直列につながっていて、押した部屋の空気が穴を通って尻尾のセンサーに届く。押す場所で山と谷の形（立ち上がり、減衰、面積の比）が変わる。ただし今の構造では頭と足の形が近く、そこが課題。

**Q. 単純な閾値でよくない？（からあげ氏）**
圧力の大きさだけでは無理。頭と足の山の高さは記録によって大小が逆転した（HEAD 201 < LEGS 271 → HEAD 247 > LEGS 125 千counts）。だから大きさを使わず時間と比の12特徴量にしている。

**Q. 12特徴量なら k-NN でも当たるのでは？ Solist-AI の必然性は？**
はい、PC の最近重心法でも同程度に当たる。Solist-AI を使う理由は精度ではなく、**16KB のマイコン上で、押すたびに逐次学習できること**。だから「教える」ができ、持ち主の押し方に合わせて賢くなる。PC の k-NN はこの恐竜の中に入らないし、その場で学ばない。

**Q. 学習データは何件？ 評価は？**
応募時: 1日1人の60件を起動時に学習。評価は同じ記録内の分割で 21/22、保留8件で 6/8。それでは独立評価と言えないので、10月に別の日・2人で各部位10回以上を取り直した（→混同行列）。

**Q. 押す強さや人が変わったら？**
変わると当たりにくくなる。特に頭と足。そのための「教える」モード。起動時の学習に加えて、使う人が数回教えると適応する。

**Q. 7か所全部分かる？**
設計は7部屋。今は4分類。足4本は波形が近く、オフラインで7部位 79%、誤りはほぼ足同士。足を分けるには頭側と同じく流路の設計変更が要る。

**Q. 既存の空気圧触覚センサーと何が違う？（AirTouch を知っていますか？）**
知っている。AirTouch（CHI 2020）はポンプで空気を送った硬い3Dプリント物体の穴を指で塞いで、気圧センサー1個で12か所を当てる。PneuTouch はポンプなしの受動式で、柔らかい物体をどこでも押せて、学習がチップの中で完結する。流路の動特性を情報源にする考え方は Pneumatic Reservoir Computing（2021）に近い。世界初とは言わないが、この組み合わせは見つけていない。

**Q. PC は要らない？**
学習・推論・LCD表示・教える操作はボードだけ。PC は画面の恐竜の動画を出すためだけ。

**Q. 反応は速い？**
指を離してから約1.5秒。押している間の波形と、離したあとの谷まで見てから判定するため。マイコン内の推論は5msだが、それを体感速度とは言わない。弱すぎる押しは「読めなかった」と表示してもう一度を促す。

**Q. 同時に2か所押したら？ 長押しは？**
今は未対応。1秒押して離す操作が前提で、4秒で打ち切る。連続押し・同時押しは次の課題。

**Q. 実用化は？**
ぬいぐるみ、ソフトロボットの外装、介護用クッションなど「センサーを並べにくい柔らかい物」。気密の経年変化、温度、個体差の検証が必要。

**Q. 何が一番大変だった？（西村氏・栗原氏向け）**
頭と足が同じ形に見えること。空気の回路は思ったより素直で、遠いから遅いという単純な話ではなかった。だから「教える」を作った、という流れで答える。

## スライドに載せる数字（確定しているもの）

| 項目 | 値 | 出典 |
|---|---|---|
| 空気室 | 7 室、穴 φ2.5 mm、壁 1.5 mm | README |
| サンプリング | 40 SPS、24 bit | README |
| 特徴量 / モデル | 12 入力・隠れ 32・4 出力、2段 | `pressure_model_data.h` |
| 起動時学習 | 60 件 + 専用 32 件、約 0.5 秒 | `# PNEM1` 実測 |
| 推定 | 約 5 ms | `# PNEC1` 実測 |
| RAM | 8,576 / 16,384 B | `docs/protopedia/system-structure.md:45` |
| 分割評価（同一記録内） | 21/22、保留 6/8 | `docs/live-pressure-demo-20260920.md` |
| 独立評価（10月） | 取得後に記入 | `docs/analysis/2026-10-15-independent/` |
