CreatorKanata/pneutouch-ai-rehc2026/docs/final-judging/strategy-review.md

# 最終審査戦略：実装との照合と判断（Fable）

作成日: 2026-10-14 / 最終審査: 2026-10-24（土）13:00〜 オンライン、発表5分＋質疑3〜4分
目標: 最優秀賞（50万円、1作品）。審査基準は 独創性 / 完成度 / Solist-AI活用度 の3つ（[公式サイト記録](rehc2026-official-site.md)）。

この文書は [GPT案](gpt-strategy-draft-20261014.md) をリポジトリの実装・検証記録と照合し、
10日間で何をやるかを決めるための判断材料です。根拠は `file:line` で示します。

---

## 1. GPT案の現状認識で、実装と食い違う点

| GPT案の記述 | 実際 | 根拠 |
|---|---|---|
| 「PC側で特徴量を計算している。MCU移植が必要（10/16–17の作業）」 | **12特徴量の抽出は既にMCU上で動いている**。PCは生値と結果の表示だけ | `src/pneutouch-solist/S_PneuTouch/pressure_features.c:97`（`extract()`）、`pressure_app.c:57-60,158` |
| 「Solist-AIによる学習・推論」を変更後の目標に置く | 学習も推論も既にチップ上。起動時に埋め込み60件＋専用32件を ODL API で学習（240＋128ステップ） | `pressure_model.c:88-104`、`pressure_model_data.h:6-8,77-79` |
| 「学習時間 約0.5秒」 | 一致。`pneutouch_model.training_us` で実測し起動時に `# PNEM1` で送信 | `pressure_model.c:101`、`pressure_app.c:112-116` |
| 「4クラス分類」の単段モデルを想定 | **2段構成**。1段目が HEAD/LEGS を返すと、入力5を非対称度から「正圧ピークの絶対値」に差し替えた専用モデルで再判定する | `pressure_model.c:146-152`、`docs/head-legs-refinement-20260920.md:29-36` |
| 「21/22 と 6/8 は評価条件が異なる」 | 正しい。ただしどちらも**同じ日・同じ操作者・同じ記録内**の分割で、独立評価ではない。6/8 は専用モデル導入前の単段モデルの値 | `docs/live-pressure-demo-20260920.md:120-140`、`docs/head-legs-waveform-analysis-20260920.md:250` |
| 「現場学習のためにFeRAMドライバを書く」 | FRAM（MB85RS2MTA、SoftSpi）のベンダードライバは同梱済み。PneuTouch からは未使用。Beta/P を FRAM と往復する処理もベンダー実装がある | `S_Bsp/Fram.c`、`S_Bsp/SoftSpi.c:22-39`、`S_AI/AIWeight.c:82-110` |
| 「ライブラリが逐次追加学習に対応していない場合は…」 | `ODL_StartTrain` は "sequential training"。ベンダーサンプルは学習と推論を交互に呼ぶ。追加学習に Reset は不要 | `S_Driver/solistAi.h:190-198`、`S_AI/AI.c:608-625` |
| 「PCからラベル指定（PneuTouch Console）」 | ボードに押しボタン4個（PSW1–4、P50–P53）、DIP 4bit、LED 3個があり、**PneuTouchでは全部未使用**。PC なしで教えられる | `S_Input/Sw.c:9-11,36`、`S_Output/smpl_common_led.c:35-67` |
| 「恐竜の中は7区画。しっぽ→…→頭の順に穴を通る」 | 直列順は しっぽ→右後ろ足→右前足→左前足→左後ろ足→背中→頭。頭は穴6個先、足は1〜4個先 | `README.md:43` |

### 既に答えが出ている「厳しい質問」

GPT案は「単純な閾値でも判別できるのでは？」を最も厳しい質問とし、AIあり/なし比較を最優先に挙げています。
手元の記録はもう半分答えています。

- 12特徴量に対する**PC上の最近重心法**で 4群 LOEO 40/43（93.0%）。Solist-AI実機（21/22）と同程度 — `docs/pressure-validation-20260920.md:191`、`docs/solist-chip-validation-20260920.md`
- つまり「AIだから当たる」のではなく、**「12特徴量だから当たる」**。審査でそう言われても困らないよう、Solist-AIの価値は精度ではなく**「16KBのチップ上で逐次学習できること」**に置く必要がある（→ 3節）。
- 一方「圧力の大きさ（ピーク）だけ」では判別できない証拠はある。HEAD と LEGS の正圧ピークの大小が記録間で**逆転**している（最初の記録 HEAD 201 < LEGS 271 千counts、追加記録 HEAD 247 > LEGS 125）— `docs/head-legs-waveform-analysis-20260920.md:15,66`。これは「大きさではなく形」の説明に使える。

---

## 2. 正直な現在地（3基準で）

### 独創性：強い。ただし「構造が情報を作っている」証拠は弱い

- 1センサ＋内部構造で全身触覚、というコンセプトは10作品中で唯一。一番近い Solistpan（振動）と複数吸盤監視（真空圧）は、**既にある物体の波形を読む**。PneuTouch は**読ませるための構造を設計した**。この差は本物。
- ただし記録上は、HEAD と LEGS の負側回復時間がほぼ同じ（140.6 ms vs 139.1 ms）で、正規化波形の部位間距離は部位内のばらつきと同程度 — `head-legs-waveform-analysis-20260920.md:17,119-120`。「遠い区画ほど遅い」仮説は支持されていない — `pressure-validation-20260920.md:19,34`。穴・隔壁が差を作った証拠も未実証 — `pneumatic-filter-design-20260920.md:17-18`。
- 審査では「空気の回路が位置を符号化する」と言い切らず、「しっぽ・背中は形で安定して分かる。頭と足は今の構造では重なる。次は頭側流路を変える」と**設計課題として語る**方が、栗原氏・からあげ氏には強い。

### 完成度：一番弱い。独立評価がゼロ

- 全データは 2026-09-20 の1日、1人の操作者 — `head-legs-waveform-analysis-20260920.md:250`。
- 実操作では HEAD と LEGS が「半々くらい」— `head-legs-refinement-20260920.md:19-21`。初回ライブ試験は押しが速すぎて6件すべて TAIL — `live-pressure-demo-20260920.md:91-101`。
- 2段モデルの最終ファームウェアの数字は「学習データ自身の再現」56/60 しかない — `head-legs-refinement-20260920.md:86-87`。**これを精度として出してはいけない。**
- 公開ページの「22件中21件」「8件中6件」は条件を添えれば嘘ではないが、別の日・別の人のデータが1件もないのは、からあげ氏に一発で見抜かれる。

### Solist-AI活用度：中。「起動時に埋め込みデータを再学習」止まり

- チップ上で学習しているのは事実だが、学習データはビルド時に `generate_pressure_model.py` で焼き込んだ固定セット。正規化の平均・スケールも固定 — `pressure_model_data.h:9-10`。
- 公式FAQは「学習も推論も、**追加学習まで**単体で完結可能なのが Solist-AI の特徴」と明言（[公式サイト記録](rehc2026-official-site.md)）。今のデモはこの「追加学習」を使っていない。
- 既存の `PAI1` 検証モードは PC からベクトルを送ってチップで学習・推論できる — `ai_validation.c`。つまり「再ビルドなしの学習」の土台は既にある。足りないのは**実押下をその場でラベル付きサンプルにする経路**と**保存**。

---

## 3. 判断：10日間で何に賭けるか

### 最優先（S）：「恐竜に教える」モード — PCなし、ボタンとLCDだけで追加学習

理由:
1. **3基準すべてに効く唯一の施策**。Solist-AI活用度（追加学習＝FAQが挙げる本質）、独創性（物体自身が触覚を覚える）、完成度（操作者差という最大の弱点を「その場で適応する」機能に変える）。
2. **部品が全部そろっている**。未使用のボタン4個・LED・LCD、FRAM ドライバ、Beta/P の保存コード、逐次学習 API。新規ハードなし。
3. 「k-NN でも同じ精度」への答えになる。PC の k-NN は、電源を切ってもう一度押しても賢くならない。
4. 10作品の中で、**その場で学ぶ様子を5分の中で見せられる作品**はたぶんない（はうらへん、Plant Doctor は学習を見せにくい）。

仕様は [teach-mode-spec.md](teach-mode-spec.md)。実装前に**1日で効果を確かめる**（4節）。

### 同じく最優先（S）：独立評価データを今週中に取る

- 別の日、**2人の操作者**（かなた＋大人）、4クラス × 各10〜15回、同じ恐竜、押し方は「約1秒押して離す」だけ指定し強さは自由。
- 現行ファームウェアの `# PNEC1` 出力をそのまま記録し、正解ラベルは記録ファイル名で固定（既存の `tools/capture_live_calibration.py` と同じ手順）。
- 出すのは**混同行列と条件**。90%に届かなくてよい。届かない数字を正直に出し、「教えると上がる」まで見せるのが筋。
- このデータは teach モードの効果検証（教える前/後）にも使う。操作者Bのデータで教える前の精度 → B が各部位5回教える → B の残りで再評価。

### 高（A）：ピーク閾値ベースラインの可視化（半日）

- 既存CSVで「正圧ピークだけで4分類」と「12特徴量」を並べ、ピーク単独では記録間で逆転して当たらないことを1枚の図にする。質疑の「閾値でよくない？」にはこれで答える。
- k-NN 比較はやらない方がよい（同等だと分かっているので、出すと自分の首を絞める）。聞かれたら 3節の論理で答える。

### やらないこと（再印刷は 10/14 に「条件付きでやる」に変更）

| 項目 | 理由 |
|---|---|
| 7クラス（足4本の区別） | 追加記録の LEGS 17件に足別ラベルがない（`head-legs-waveform-analysis-20260920.md:45`）。7部位オフライン 79% で誤りの大半が足同士（`pressure-validation-20260920.md:195`）。10日では無理 |
| 恐竜の再印刷・流路変更 | **10/14 に方針変更。** Hide の提案で再印刷トラックを追加。10/16 の試験片で go/no-go。詳細は [reprint-design.md](reprint-design.md)。v1 は安定版として残す |
| 波形直接入力への切り替え | 64/128点入力は 12特徴量より明確に悪い（`solist-chip-validation-20260920.md`） |
| Self-Evolving Touch（AIが苦手部位を要求） | teach モードが動いてから。LCDに「HEAD 3/5」と出すだけで半分実現する |
| AIによるCAD最適化 | スライド1枚の将来構想に留める |

---

## 4. 実装前に確かめること（go / no-go、10/16まで）

teach モードの最大の技術リスクは**「追加学習が効くか」**です。

- 起動時に 240 ステップ学習済みのモデルは、RLS 系の逐次学習では P が小さくなっており、追加の数サンプルで Beta がほとんど動かない可能性がある。`forgettingFactor` は現在 1.0（忘れない）— `pressure_model.c:66`。
- 対策候補: (a) 教えるサンプルを複数回（4回=起動時のエポック数と同じ）学習させる、(b) forgettingFactor を 1 未満にする、(c) 起動時学習のステップ数を減らす。どれが効くかは実機で測るしかない。
- **幸い PC から試せる**。`PAI1` モード（`ai_validation.c`）と `tools/validate_solist_ai.py` 系の仕組みで、「52件で学習 → 操作者Bの8件を追加学習 → Bの残りで評価」をファームウェア改修なしに回せる。ここで効果がなければ、teach モードは「ゼロから教える」デモ（埋め込みデータなしで起動し、4部位×6回を教えて動かす）に切り替える。これも十分に強い。

専用モデル（HEAD/LEGS）の扱い: 入力5が正圧ピークの絶対値なので押す強さに敏感（`head-legs-refinement-20260920.md:28`、`head-legs-waveform-analysis-20260920.md:218`）。教えるときはラベルが HEAD/LEGS なら両方のインスタンスに同じサンプルを学習させる。操作者が変わってピークが変わることにこそ追加学習が効くはず。

---

## 5. 公開情報・発表で直すべき表現

- 「PC不要」は**学習・推論・LCD表示**に限る。動画の演出は PC。`docs/protopedia/system-structure.md:9` の通りに言う。
- 「22件中21件」「8件中6件」には「同じ日・同じ人の記録内分割」と添える。独立評価の数字が取れたらそちらを主に出す。
- 56/60（学習データの再現）は出さない。
- 「空気圧触覚センシングを発明した」とは言わない。**直接の先行研究は AirTouch（CHI 2020）**: ポンプで空気を送った3Dプリント物体の穴を指で塞ぎ、気圧センサー1個＋MLで最大12か所を識別。こちらから名前を出し、「受動・柔らかい・押す・チップ内学習」の違いを言う。理論的な裏付けは Pneumatic Reservoir Computing（2021）。一覧は [reprint-design.md](reprint-design.md) 1節。

---

## 6. 競合との位置づけ（GPT案の分析はおおむね妥当）

GPT案5〜6節の競合分析は公開情報と整合しており、そのまま使えます。付け加えるなら:

- **AgriHealth / コンデンサ選別 / 吸盤監視**は「現場で役に立つ」で勝ちに来る。こちらは「現場で役に立つ」では勝てないので、**「物体に触覚を与える新しい方法」＋「その場で学ぶ」**で独創性と活用度を取りに行く。
- GPT案が落としている最大の武器は**作者がキッドクリエイターで、動機が「恐竜バトルで噛まれた場所に反応してほしかった」**（`docs/protopedia/story.md:3-6`）であること。企業R&D調の資料になっているが、Makerコンテストで西村氏（プロデューサー）・栗原氏（物議を醸すものづくり）に刺さるのは、この動機と、それを支える正直な実験。**最初の20秒はこの話で始める。**

発表構成と想定質疑は [presentation-5min.md](presentation-5min.md)、日程は [plan-10days.md](plan-10days.md)。

---

## 7. 第二意見（Codex）で追加された点

詳細は [second-opinion-codex.md](second-opinion-codex.md)。計画に取り込んだのは次の4つ。

- **検出率を数字にする**: 足の候補26件のうち9件が振幅不足で棄却されている（`head-legs-waveform-analysis-20260920.md:182-191`）。独立評価では INVALID / TIMEOUT も数える。
- **遅延の言い方**: 検出から特徴確定まで中央値 1.385 秒（`solist-chip-validation-20260920.md:137`）。「推論 5ms」は体感ではない。「離してから約1.5秒」と言う。
- **demo-visualizer の案内文が出ない**: `notice()` が `error=false` の文言を空にしている（`src/demo-visualizer/app.mjs:12`）。INVALID 時の「もう一度押して」が表示されない。10/20 に直す。
- **teach モードの実装注意**: FRAM 書込の読み戻し確認、学習中の取得停止、`PAI1` からの復帰時に FRAM を再読込、専用モデル用の peak も保存。[teach-mode-spec.md](teach-mode-spec.md) に反映済み。

Codex は「teach モードは独立評価の後の追加点」と位置づけた。私は両方を最優先にし、10/16 の効果検証で賭け金を限定する（3〜4節）。理由は second-opinion-codex.md の「判断」に書いた。
