CreatorKanata/pneutouch-ai-rehc2026/docs/analysis/2026-10-15-pneumatic-sim/summary.md

# Pneumatic lumped-parameter simulation

Generated by `tools/pneumatic_sim.py run`. Simulated data only: 40 events per zone,
randomised force/speed, Gaussian ADC noise, firmware 12-feature extraction,
log + standardise, leave-one-out nearest centroid.

| scenario | 7-class acc | 4-class acc | HEAD/LEGS acc | invalid | mean peak counts | mean trough counts | top-2 features |
|---|---|---|---|---|---|---|---|
| series_current | 14 % | 22 % | 50 % | 0 % | 544,294 | 2,338,101 | recovery_ms, area_ratio |
| series_thin | 49 % | 61 % | 73 % | 0 % | 423,883 | 1,652,285 | recovery_ms, release_area_width_ms |
| star_graded | 23 % | 25 % | 62 % | 0 % | 544,046 | 2,290,678 | release_width_ms, release_rise_ms |
| star_orifice | 30 % | 56 % | 66 % | 0 % | 463,026 | 1,171,810 | trough_peak_ratio, release_width_ms |
| mech_k_only | 31 % | 48 % | 77 % | 0 % | 628,516 | 2,582,728 | recovery_ms, decay_ms |
| mech_tau4 | 53 % | 93 % | 100 % | 2 % | 618,751 | 2,210,243 | width_ms, area_width_ms |
| mech_tau4_snap | 54 % | 95 % | 100 % | 3 % | 615,762 | 2,009,831 | width_ms, decay_ms |
| mech_tau7_snap | 80 % | 88 % | 100 % | 2 % | 595,371 | 1,883,593 | width_ms, area_width_ms |
| mech_tau4_sealed | 48 % | 94 % | 100 % | 0 % | 3,016,648 | 1,130,293 | rise_ms, recovery_ms |

Chance level: 7-class 14 %, 4-class 25 % (majority LEGS 57 %), HEAD/LEGS 50 % (majority LEGS 80 %).

## star_graded_1khz: 1000 SPS, no downsampling, noise-free sensor pressure

| zone | sensor rise 10-90 % [ms] | sensor lag behind pressed chamber at 50 % [ms] |
|---|---|---|
| TAIL | 117.4 +/- 24.5 | 3.80 +/- 1.25 |
| BACK | 122.7 +/- 23.9 | 0.00 +/- 0.00 |
| RH leg | 116.9 +/- 23.8 | 7.33 +/- 1.87 |
| LH leg | 121.4 +/- 23.6 | 12.38 +/- 2.45 |
| RF leg | 133.3 +/- 26.9 | 9.03 +/- 2.52 |
| LF leg | 123.6 +/- 25.1 | 11.09 +/- 2.72 |
| HEAD | 129.1 +/- 24.6 | 14.51 +/- 2.51 |

## Physics caveat

tau_in = c / k is the wall's retardation (sink-in) time. For a homogeneous TPU wall it is largely a material property: making a wall thicker or thinner changes k and c together and leaves c / k unchanged. The mech_k_only row shows what stiffness alone buys (48 % 4-class / 31 % 7-class). The mech_tau rows (mech_tau4: 93 % 4-class / 53 % 7-class; mech_tau7_snap: 88 % 4-class / 80 % 7-class) show the upside only if geometry (domes, ribs, bellows, lattice-filled zones) can change the apparent sink-in time constant by 2x or more. That is what the 10/16 test pieces must measure: width_ms and decay_ms per press-face type.

Fluidic (channel) encoding is ruled out at 40 SPS: the star_graded channel delays are 4-15 ms, below one 25 ms sample (see the 1000 SPS table), so it would need kHz sampling.

## Calibration

Baseline fitted to one real direct tail press; weighted RMS residual 0.041 (each lobe normalised by its own peak). See calibration.png.

## Notes and approximations

- Walls are quasi-static (massless): c x' = F - k x - A p; inertance and wall mass are ignored.
- Wall damping is direction dependent (c_out = c_out_ratio * c_in while the wall springs back). This "snap-back" term is an addition to the plan: with symmetric damping the best calibration residual is 0.124 versus 0.041, because a linear model cannot give both a 3.4x larger trough and a faster (50 ms vs 240 ms) recovery.
- Wall area, stiffness and finger force are only identifiable together (displaced volume A F / k and time constant c / k); individual values are not physical measurements.
- Gas is adiabatic and linearised (C = V / (gamma p0)) with no heat exchange; the sensor tube volume is folded into its chamber. The linearisation is stretched by the release snap-back: a 1 kHz check (5 presses per zone) found pressed-chamber minima of about -12 kPa (series_current), -25 kPa (series_thin) and -73 kPa (star_orifice), so star_orifice troughs are qualitative only.
- Channels use Poiseuille + orifice loss solved as one quadratic, quasi-steady (no inertance or entry development).
- Integration is linearly-implicit Euler at dt = 0.2 ms (channel time constants reach nanoseconds, so explicit RK4 would be unstable); 40 SPS samples are instantaneous values every 25 ms.
- Every zone uses one wall with the same area. The mech_* scenarios keep series_current connectivity and change per-zone k, c and c_out ratio (multipliers in parameters.json); mechanical_encoding is an alias of mech_tau4.
- Leg channel grading in star_graded follows series order RH, RF, LF, LH.
- Accuracy is computed on valid (complete) events only; INVALID events are reported separately.
- Calibration residual recomputed for the stored baseline: 0.041.
