CreatorKanata/pneutouch-ai-rehc2026/docs/final-judging/plan-10days.md

# 10/24 までの計画（10/14〜10/23）

前提: 最優先は [strategy-review.md](strategy-review.md) 3節の2つ（teach モード、独立評価）。
新機能は 10/21 で凍結し、以降はデモの安定とプレゼンに使う。
各日の「成果物」が出なければ、翌日は機能追加ではなく安定版の確認に回す。

## 役割分担（この計画での想定）

- 設計・判断・レビュー・発表原稿: Fable（この文書の作者）
- ファームウェア実装・テスト: implementer エージェント（Opus）に仕様書を渡す
- 実機ビルド・書き込み・押下データ取得・撮影: Hide / かなた（Windows + LEXIDE-Ω、恐竜、COM7）

## 日程

| 日 | 作業 | 成果物 / 判断 |
|---|---|---|
| 10/14（水） | 公式情報・GPT案・照合結果を `docs/final-judging/` に集約。teach モード仕様を書く | 本ディレクトリ一式 |
| 10/15（木） | **安定版の凍結**: 現在の `main` にタグ `demo-v1` を打ち、HEX をバックアップ。**独立評価データ収集 1回目**: 2人（かなた、Hide）× 4部位 × 各10回以上。現行FWの `# PNEC1` と正解ラベルを記録 | `docs/analysis/2026-10-15-independent/`、混同行列（操作者別） |
| 10/16（金） | **追加学習の効果検証（go/no-go）**: `PAI1` モードで「埋め込み60件で学習 → 操作者Bの各部位5件を追加学習 → Bの残りで評価」。4回繰り返し学習 / forgettingFactor<1 / 起動時ステップ削減 を比較 | 効果あり → 仕様の「追加学習」で進む。効果なし → 「ゼロから教える」に切り替え |
| 10/17（土） | teach モード実装（ボタン、LCD、FRAM 保存・復元、起動時の選択）。PC 上の C テスト | ビルド成功、`tests/` 緑 |
| 10/18（日） | 実機で teach モード確認。電源 OFF→ON で学習結果が残ることを確認。ピーク閾値ベースラインの図を作成 | 動画（教える前→教える→当たる） |
| 10/19（月） | **独立評価 2回目**: 教える前 / 教えた後 を同じ操作者・同じ日で比較。失敗例を記録 | 発表に載せる混同行列（前/後） |
| 10/20（火） | 不具合修正。デモ手順の固定（押し方、待ち時間、LCD/画面の見せ方）。スライド初稿 | スライド v1、デモ手順書 |
| 10/21（水） | **機能凍結**。タグ `demo-v2`。バックアップ録画（ノーカット）を撮る | 録画、HEX バックアップ |
| 10/22（木） | スライド完成、原稿、想定質疑の練習。5分の計測 | スライド v2、原稿 |
| 10/23（金） | 通しリハーサル 2回（画面共有＋カメラ切り替え込み）。接続確認。機材充電 | 本番手順書 |
| 10/24（土） | 最終審査会 13:00〜 | — |

## 独立評価の取り方（10/15, 10/19 共通）

1. 恐竜・センサー・ボードは応募時と同じもの。設定も `demo-v1` のまま。
2. 操作者 A（かなた）と B（Hide）。押し方の指示は「約1秒押して離し、3秒待つ」だけ。強さは指定しない。
3. 部位ごとに別ファイルにせず、**部位をランダムな順で混ぜて**記録する（`docs/pressure-validation-20260920.md:280` の未実施項目）。正解ラベルは操作者が声に出し、記録者がログに時刻付きで書く。
4. 各部位 10 回以上 × 2人 = 80 件以上。INVALID / TIMEOUT も数える（検出率を初めて出せる）。
5. 集計は `# PNEC1` のラベルと正解の混同行列。操作者別と合計を出す。専用モデルが使われた回数（`specialist_used`）も残す。

## バックアップ方針

- `demo-v1`（応募時相当）と `demo-v2`（teach モード入り）の HEX を両方保存。本番は `demo-v2` が10/19の評価で `demo-v1` 以上のときだけ使う。
- ライブデモ失敗時の録画は、スライドに埋め込まず別ファイルで即再生できるようにする。
- 本番PCは demo-visualizer 用。シリアルポートを他ツールで開いたままにしない（同時に開けない: `src/demo-visualizer/README.md:29`）。

## 再印刷トラック（10/14 追加、10/15 訂正）

人の作業は CAD と収録だけで、印刷は無人（約 10 時間、TPU 85A）、ファームウェアはエージェント。上の表と並行して走らせる。
物理の訂正と go/no-go 条件は [reprint-design.md](reprint-design.md) 0 節・5 節。

| 日 | 再印刷トラック |
|---|---|
| 10/15 | 試験片 5 種（平面 1.5 / 平面 2.5 / ドーム / 蛇腹 / 容積 1/3、すべて壁 1.5 以上）を `tools/make_test_pieces.py` で生成済み → 印刷（85A、tp1→tp3→tp4→tp2→tp5）。現行恐竜で 5 秒押し続けの漏れ確認。シミュレーター `tools/pneumatic_sim.py` 作成済み |
| 10/16 | 前提変更: 表面は固定、内部だけ設計。内部構造だけが違う試験片 5 種（`3d-models/test-pieces-internal/`）を印刷・計測（各 10 回、強弱混在）。ti1/ti4/ti5 が分かれるか → **go / no-go** → **10/21 に go（3 分類 97.2%、減衰比 2.9 / 2.4 倍。`docs/analysis/2026-10-21-test-pieces/`）** |
| 10/17 | 恐竜 v2 CAD（外形は現行 STL のまま。区画ごとに皮の内側のあそび・リブ・肉厚を変える）。夜に印刷 → **実際は 10/21 に v1 の STL をそのまま 85A で印刷（v2 は未印刷）** |
| 10/21〜22 | 85A なので一から再学習: 簡易チェック（4 部位 × 5）→ 本収録（4 部位 × 15 以上）→ `prepare_retrain.py` → `generate_pressure_model.py` → ビルド・書き込み。手順は [retrain-85a.md](retrain-85a.md) → **10/22: 足が未検出・TAIL になる問題を修正（トリガー 30k、モデル入力に山と谷の絶対値）。117 件で再生成、一回抜き 94.9%。要再書き込み** |
| 10/22 | 85A 恐竜の独立評価（9 月と同じ手順）。95A と比較。書き込み後の手応えは「そこそこの精度」（Hide） |
| 10/22 夜 | 95A / 85A のどちらの恐竜で発表するか決定 |

## やらないことの再確認

波形直接入力、CAD の自動最適化、流路の時定数設計（kHz サンプリングが要るので審査後）。7 クラスは v2 が成功したときだけ追加評価する。詳細は [strategy-review.md](strategy-review.md) 3節。
