CreatorKanata/pneutouch-ai-rehc2026/docs/final-judging/final-judging-event.md

# ROHM EDGE HACK CHALLENGE 最終審査会（イベントページの記録）

出典: <https://mashupawards.connpass.com/event/407726/>（2026-10-14 時点の掲載内容を保存）

開催: 2026-10-24（土）13:00〜16:30、オンライン

## 本イベントについて

ROHM EDGE HACK CHALLENGE 2026 の最終審査会。一次審査を通過した10組がオンラインで作品をプレゼンテーションし、最終審査員3名による審査で受賞作品5作品を決定する。

本コンテストは、ローム株式会社のオンデバイスAIソリューション「Solist-AI™」を活用したプロトタイプ開発コンテスト。
「その場で考え、その場で動くAI」をテーマに生まれた作品のアイデア、技術、動作を紹介する。応募作品は ProtoPedia のコンテストページでも閲覧できる。

## 申し込みについて

### 発表者における注意点

- 審査通過の連絡を受けた方のみ、発表者として登録できる。
- オンラインでの発表と質疑応答ができる接続環境を準備する。
- **当日は、自身で発表資料の画面共有や作品の説明を行う。**

### イベント参加における注意点

- 決勝進出者は、運営事務局からの案内に従って参加登録する。
- チームで発表・参加する場合は、参加者それぞれが登録する。
- 観覧者もこのページから事前に参加登録する。

## 選考通過作品（順不同。発表順は後日公開）

1. 人間の生体デバイス化による第六感情報の検出と活用
2. Solistpan
3. AgriHealth — 機械と作業者の健康を守る
4. Plant Doctor — 植物の「いつも」と違うを診て、水やりまで行うエッジAI
5. エッジAIで1個の失敗も見逃さない!!複数吸盤対応シングルセンサワーク保持監視システム
6. 触覚で見分けるコンデンサ選別ロボット
7. AIで究極のたこ焼きを焼く
8. はうらへん — マイクの不快なキーンを、鳴る前に予兆。その部屋の前兆をその場で学ぶ AI
9. RE-2-Solist-AI Gene ギタリストの物理的制約を排除し演奏を楽しくするAI
10. PneuTouch AI ― 空気圧センサー1個で「どこを触ったか」がわかる恐竜

## プレゼンルール

| 項目 | 内容 |
|---|---|
| 発表時間 | 各作品 **5分**（時間厳守） |
| プレゼン内容 | **作品の特徴、Solist-AI™ の活用方法、プロトタイプの動作**が伝わる内容 |
| 質疑応答 | プレゼン後に **3〜4分程度** |
| 審査基準 | 公式ページを参照（独創性 / 完成度 / Solist-AI™ 活用度。[記録](rehc2026-official-site.md)） |

## 審査員

| 審査員 | 肩書・紹介 |
|---|---|
| 西村 真里子 氏（@mariroom） | 株式会社 HEART CATCH 代表取締役。企業・行政・研究者・クリエイター、そして海外ネットワークをつなぎ、新しい価値を生み出す越境プロデューサー |
| 栗原 一貴 氏（@qurihara） | 津田塾大学情報科学科 教授 / Coolied, Inc. CTO。物議を醸すものづくりを得意とする情報科学者。2012年イグノーベル賞受賞。著書「消極性デザイン宣言」 |
| からあげ 氏（@karaage0703） | AIエンジニア・ブロガー。AI関係の会社でデータサイエンティストとして勤務し、生成AI・AIエージェント分野のプロジェクトに携わる。著書「教えて！からあげ先生 はじめての生成AI」ほか多数 |

## 発表準備で押さえる点（このページから分かること）

- 画面共有は発表者が自分で行う。スライドと、恐竜を映すカメラ（手元）を切り替える段取りが必要。
- 「プロトタイプの動作が伝わる」ことが明示されている。ライブで押す様子と結果表示を、5分の中で必ず見せる。
- 接続環境の確保がルールに書かれている。ライブデモが失敗したときのために録画を用意する。
