CreatorKanata/pneutouch-ai-rehc2026/docs/final-judging/rehc2026-official-site.md

# ROHM EDGE HACK CHALLENGE 2026 公式サイトの記録

出典: <https://rehc.jp/>（2026-10-14 時点の掲載内容を保存。審査基準・日程の参照用）

## メッセージ

― Solist-AI™ でつくる、次のエッジAI ―

エッジで完結するAIの可能性を、あなたのアイデアで解き放て。

ROHM EDGE HACK CHALLENGE 2026 は、ロームが提供するエッジAIソリューション「Solist-AI™（ソリストエーアイ）」を使った技術系コンテストです。
クラウド前提ではない "その場で考え、その場で動くAI" をテーマに、「Maker」のみなさまの自由な発想を募集します。

### Solist-AI™ とは

ローム株式会社がエッジコンピューティング分野に向けて提供するオンデバイスAIソリューションに与えられるブランド名称です。
クラウドサーバーやネットワークに依存せず、エッジデバイス単体でリアルタイムの学習・推論処理を可能にすることで、AIイノベーションの拡大に貢献します。

公式資料へのリンク（サイト上）: 「Solist-AI™ って何？」「Solist-AI™ 紹介資料」「Solist-AI™ 活用事例」「Solist-AI™ ページ」「アイデアソンレポート」「FAQ」

### こんな人に参加して欲しい

- クラウドに頼らないエッジAIで自分の課題を解決したいエンジニア
- エッジAIで社会課題解決やビジネスに挑戦したい法人
- 自分の技術力を試し、作品として世の中に公開したい理工系学生・高専生
- Solist-AI™ を楽しそう、面白そうと直感で感じられる Maker・電子工作好き

## お知らせ

| 日付 | 内容 |
|---|---|
| 10/14 | 一次選考の結果を最終審査会ページにて公開 |
| 09/30 | 「オンライン一般投票」開始 |
| 09/29 | 32作品の応募があった |

## スケジュール

| 日程 | イベント | 補足 |
|---|---|---|
| 07/01（水） | 応募開始 | 技術サポート・参加者Q&A用のDiscord開設。オンラインハンズオンも予定 |
| 09/28（月） | 応募締切 | 一次審査員による一次審査と一般投票（10/9まで）により最終審査進出作品を決定。結果は10/14までに連絡 |
| 10/24（土） | 最終審査会 | 受賞作品が決定。一部の受賞作品は「Edge Tech+ 2026」の出展対象 |
| 11/18（水）〜20（金） | Edge Tech+ 2026 出展 | 優秀作品はロームが運営する Solist-AI™ ブースで展示 |

## 応募要項

### テーマ

"現場で動くAI" が変える、仕事と日常のアップデート

ロームの「Solist-AI™」を活用し、現場で実際に動作するエッジAIのアイデアとプロトタイプを募集。
仕事から日常まであらゆる「現場」を舞台に、リアルタイムで動くAIの新たな可能性を提示する。

### 応募期間

2026/7/1（水）〜 9/28（月）

### 応募条件

1. Solist-AI™ デバイスを活用したオリジナル作品として、デモが可能なプロトタイプ作品であること
2. 指定の応募期間内に、本サイト上の応募フォームより必要事項の入力および提出が完了していること
3. ProtoPedia において作品が登録および「一般公開」されており、3分以内のデモ動画が含まれていること
4. 未発表作品であること（これまでに応募・受賞・販売などを行っていない Solist-AI™ を活用した未発表のオリジナル作品に限る）

### 応募資格

- 個人またはチーム（チームの場合は代表者1名を定める）
- 成年者、もしくは親権者の同意を得た未成年者
- 日本国内在住者

### 応募方法

1. ProtoPedia に以下を登録する
   - 作品タイトル
   - 概要（100文字以内。広報などに利用）
   - 動画（デモ動作している動画。3分までが審査対象）
   - ストーリー（オリジナリティや創意工夫など、審査員にアピールしたいポイント）
   - 開発素材として「Solist-AI」を登録する
2. 応募フォームに必要事項を記入し、「応募規約」に同意の上、応募する

## プライズ

| 賞 | 作品数 | 賞金 |
|---|---:|---:|
| 最優秀賞 | 1作品 | 50万円 |
| 優秀賞 | 4作品 | 10万円 |

- 優秀作品は 11月18日〜20日 開催の「Edge Tech+ 2026」のロームが運営する Solist-AI™ ブースで作品展示を行う。
- Solist-AI™ パートナー賞（3作品）、アイデア賞（1作品）も予定。

## 審査

### 審査基準

1. **独創性**（アイデアが独創的である、新規性がある）
2. **完成度**（作品の完成度が高い、動作デモの精度が高い）
3. **Solist-AI™ 活用度**（その場で動くAIの特徴を活かした作品である）

### 一次審査

応募情報によるオンライン審査。エンジニア審査員（3名）＋事務局＋オンライン一般投票の総合評価で最終審査進出10組を決定。

| 審査員 | 肩書 |
|---|---|
| 福野 泰介 氏（@taisukef） | 公益財団法人IchigoJam財団代表理事、神山まるごと高専 技術教育統括ディレクター |
| 湯村 翼 氏（@yumu19） | 北海道情報大学 情報メディア学部 情報メディア学科 准教授 |
| からあげ 氏（@karaage0703） | AIエンジニア・ブロガー |
| REHC事務局 | ロームエンジニア、ProtoPedia運営メンバーなど |

オンライン一般投票: 応募作品を公開し、一人3票の一般投票（投票者には抽選で謝金あり）。

### 最終審査

最終審査会によるオンラインプレゼン審査（質疑あり）。一次審査を通過した10組がプレゼンし、以下の最終審査員3名が受賞作品5作品を決定する。

| 審査員 | 肩書 |
|---|---|
| 西村 真里子 氏（@mariroom） | 株式会社 HEART CATCH 代表取締役。企業・行政・研究者・クリエイター、海外ネットワークをつなぎ新しい価値を生み出す越境プロデューサー |
| 栗原 一貴 氏（@qurihara） | 津田塾大学情報科学科 教授 / Coolied, Inc. CTO。物議を醸すものづくりを得意とする情報科学者。2012年イグノーベル賞。著書「消極性デザイン宣言」 |
| からあげ 氏（@karaage0703） | AIエンジニア・ブロガー。AI関係の会社でデータサイエンティストとして勤務し、生成AI・AIエージェント分野のプロジェクトに携わる。著書「教えて！からあげ先生 はじめての生成AI」他多数 |

## よくある質問（Solist-AI™ に関するもの）

**Q. Solist-AI™ は異常検知専用ですか？**
A. 専用ではないので応用可能です。状態判定・動作認識・習慣学習などにも応用可能です。

**Q. どれくらい値がズレたら異常と判断されますか？**
A. しきい値の設定が可能です。アプリ側で自由に判定条件を作成できます。

**Q. どんなセンサーを利用できますか？**
A. 加速度・振動・音・温度・人感など、各種センサーの利用が可能です。約500点の情報を取り込むことが可能で、複数センサーを組み合わせることもできます。

**Q. 音声やマイク入力は扱えますか？**
A. アナログ入力によるマイク接続は可能です。音声解析系アイデアにも対応可能です。

**Q. AIの出力で何ができますか？**
A. LED点灯、ブザー通知、無線送信など、マイコンでできることは可能です。AIによる学習データと推論データの差（いつもと違う）を演算値（異常度）として出力します。後段回路はマイコンの出力と同じです。

**Q. スマホやクラウド連携はNGですか？**
A. 問題ありません。Solist-AI™ デバイスを活用した上でのスマホ通知・クラウド連携等は問題ありません。ビジネスで考えても「センサー」「バッテリー」「どのようにお知らせするか」の3つの機能は外せないと考えています。

**Q. 学習も推論も Solist-AI™ デバイス単体でできますか？**
A. 可能です。学習も推論も、追加学習まで単体で完結可能なのが Solist-AI™ の特徴です。また、学習と推論をソフトウェア上でタイミング含めて自由に設定することができます。

**Q. 学習済みモデルを別デバイスへ移せますか？**
A. 別デバイスへコピーは可能です。学習データを取っておき、別のデバイスへコピーは可能です。

**Q. デバイスなし、PCだけで事前検証できますか？**
A. 「Solist-AI™ Sim」でPCシミュレーション可能です（要MyROHMログイン）。
<https://www.rohm.co.jp/products/micon/solist-ai#developmentSupportsubmenu>
センサーのデータをCSVで取っておき、「Solist-AI™ Sim」に読み込ませることで、PCのGUI上で学習や推論をシミュレーションできます。

その他のFAQ（サイト上に見出しのみ）: 応募後の作品アップデート可否、チーム応募、著作権、Edge Tech+ のブース対応、Raspberry Pi Pico2 / gene 対応デバイスの実物確認、キャンペーン非当選者の応募、キャンペーン当選後のアイデア変更。
