CreatorKanata/pneutouch-ai-rehc2026/docs/protopedia/story.md

## One Sensor, Whole-Body Touch.

ぼくは、恐竜の人形でバトルをするのが大好きです。
でも、どこを攻撃しても人形は何も反応しません。
「かまれた場所によって恐竜が反応したら、バトルはもっと面白くなるんじゃないか」。
それがPneuTouch AIの出発点でした。

ふつう、7か所のタッチを検出するには7個のセンサーが必要です。
PneuTouch AIは、**センサーを増やす代わりに「形」に情報を持たせる**ことに挑戦しました。
センサーはしっぽの先に1個だけで、恐竜の中には電気的なセンサーも配線も入っていません。

## しくみ

恐竜の中は7つの空気室に分かれていて、小さな穴でつながっています。
どこかを押すと、空気が穴を通ってしっぽの先のセンサーまで伝わります。
押した場所によって通る道のりや部屋の大きさが違うので、圧力の「伝わり方」が変わります。

圧力の大きさではなく、立ち上がり方や戻り方といった波形のかたちをAIに覚えさせて、触った場所を当てます。
触った場所がわかると、画面の中の恐竜がその場所に応じて反応します。

## こだわったところ

全部マイコンの中で動かしました。
ROHMのSolist-AIを使い、学習も推論もチップ上で実行します。
電源を入れると約0.5秒で学習が終わり、PCなしでLCDに結果が出ます。

RAM 16KBの中で作りました。
12個の特徴量に絞り込み、隠れ層32の小さなモデルで分類します。

実測データで確かめました。
7区画それぞれの波形を記録して分析し、うまくいかなかった結果も残しました。

## いまできていること・できていないこと

- 頭・背中・足・しっぽの4分類がライブで動作します。
- 保存データの分割評価では22件中21件、追加計測後の未使用データでは8件中6件が正解でした。
- 頭と足の区別はまだ不安定です。波形を調べ直すと、押し方によって特徴が重なることがわかりました。

## これから

穴の大きさや流路の長さを変えると、空気の「フィルタ」としての特性が変わります。
頭につながる流路を作り変えて波形の違いを大きくし、最終的には7区画すべての分類を目指します。
7か所すべてがわかるようになれば、バトルはもっと面白くなるはずです。

ぬいぐるみ、ソフトロボット、介護機器など、やわらかいもの全体を少ないセンサーで「触覚化」できる技術にもつなげたいです。

## Wow メッセージ

**たった1個のセンサーで、やわらかい物体の全身に触覚を！**
