CreatorKanata/pneutouch-ai-rehc2026/3d-models/old/new-dinosaur/01-initial/new-dinasour-7chambers-t1p8-report.txt

新しい恐竜 — 7空気室モデルの変更・検証レポート
作成日: 2026-11-02

完成ファイル
3d-models/new-dinasour-7chambers-t1p8.stl
単位: mm。137,824三角形、6,891,284 bytes。
元の new-dinasour-filled.stl と old 内のファイルは変更していない。

寸法
ユーザーの確認に従い、鼻先から尻尾までを全長200 mmに設定した。
軽量化後の本体全長は約199.97 mm。
センサー接続口を含む外接寸法は約88.03 × 207.93 × 161.49 mm。
外形を最大偏差0.15 mm指定で軽量化し、外側は44,140三角形の形状を採用した。

空気室
旧モデルと同じ部位分けと直列経路を採用した。
Zone 1 尻尾 → Zone 3 右後ろ足 → Zone 5 右前足 → Zone 6 左前足
→ Zone 4 左後ろ足 → Zone 2 背中 → Zone 7 頭・首
6か所の隔壁に、各1個、直径2.0 mmの穴を設けた。
頭が大きくなった外形に合わせて首の仕切り位置・傾斜を調整し、頭全体を頭・首室へ収めた。
背中の下の仕切りは、旧モデルと同じ右から左へ30°上がる傾斜。

肉厚
本体外皮は1.8 mmを下限として作成した。
Fusionの標準メッシュシェル処理には局所的な薄肉が生じたため、内側だけを補正した。
補正後の空洞と外殻との全体最短距離は約1.82059 mm。
形状の凹凸や補正箇所には、1.8 mmより厚い部分がある。全表面が一律1.8 mmではない。
隔壁は旧モデルと同じ1.5 mm。ユーザー指定の外皮1.8 mmとは区別している。
尻尾の接続口は旧モデル互換の内径2.7 mm、外径5.7 mm、突出長8 mm。
接続口の筒壁のみ、従来寸法を維持するため1.5 mmである。

検証
・穴を開ける前: 空気領域がちょうど7つ。
・6個の穴を順に開けた後: 空気領域数が6、5、4、3、2、1と減ることを確認。
・各穴が指定された2室にだけ接続し、直径2.0 mmであることをFusionの実形状で確認。
・穴周辺には1.8 mmの余裕を持つ検査用円柱を設定し、外形内に収まることを確認。
・印刷用メッシュを独立した形状演算で作成し、各室の容積をFusionの結果と照合。
  室ごとの差は約0.00001 cm³以下。
・接続口を検査上だけ塞ぐと、閉じた外面1つと閉じた空洞面1つになることを確認。
・完成STL: 境界エッジ0、非多様体エッジ0、退化面0、法線の向き整合、一体の閉じた表面。
・完成STLの材料体積: 約123.20236 cm³。
・test_geometry.py の自動検査7件が成功。
・3d-modelsへ保存したSTLと検査済みSTLのSHA-256が一致。

STLのSHA-256
0995026bffa5995e9f8381f877d412363dc748359a082240dda15454c2d46902

Fusionの状態
新規ドキュメント NewDinosaur_7Chambers_t1p8 で、修復・中空化・隔壁・穴をFusion MCPで作成した。
補正済みの完成ソリッドはローカルの final.smt に書き出せている。
高密度BRepの細分化で一度応答停止したが、ユーザーの再起動後にMCPの接続を回復した。
保存済みの完成ソリッドを新規ドキュメントへ復元し、最終表示を確認した。
ローカルFusionアーカイブ: 3d-models/NewDinosaur_7Chambers_t1p8.f3d
ファイルサイズ: 64,943,588 bytes。クラウド保存は行っていない。
復元したFusion形状は1個のソリッド、128,872面、体積123.202443156 cm³。
完成STLとの体積差は約0.000081415 cm³で、外接寸法も0.005 mmの許容差内で一致した。
FusionアーカイブのCRCと復元形状の照合を追加の自動検査2件で確認した。
このアーカイブは完成形状を1個のベースフィーチャーとして保持しており、工程別の編集履歴は含まない。

検証の限界
スライス、実印刷、実物の気密試験は未実施。
印刷前に頭の張り出しや内部の天井をスライサーで確認し、内部に除去不能なサポートを作らない設定を検討する。
印刷後には2 mmの通気穴が塞がっていないことと、積層部・接続口の漏れを確認する。

根拠データと再検証
作業フォルダ: artifacts/new-dinosaur-seven-chambers
source_audit.json / scale_report.json / cavity_correction.json / partition_report.json
passage_report.json / print_air_validation.json / print_validation.json / test_geometry.py
fusion_recovery.json / test_fusion_recovery.py は再起動後の復元・保存確認。
Python環境: pneutouch-ai-rehc2026/.venv/bin/python
実行例: 上記Pythonで作業フォルダ内の test_geometry.py を実行する。
new-dinasour-7chambers-t1p8-sections.png は完成STLから算出した左右の実断面。
