CreatorKanata/pneutouch-ai-rehc2026/3d-models/dino-air-v2-leg-gap.png

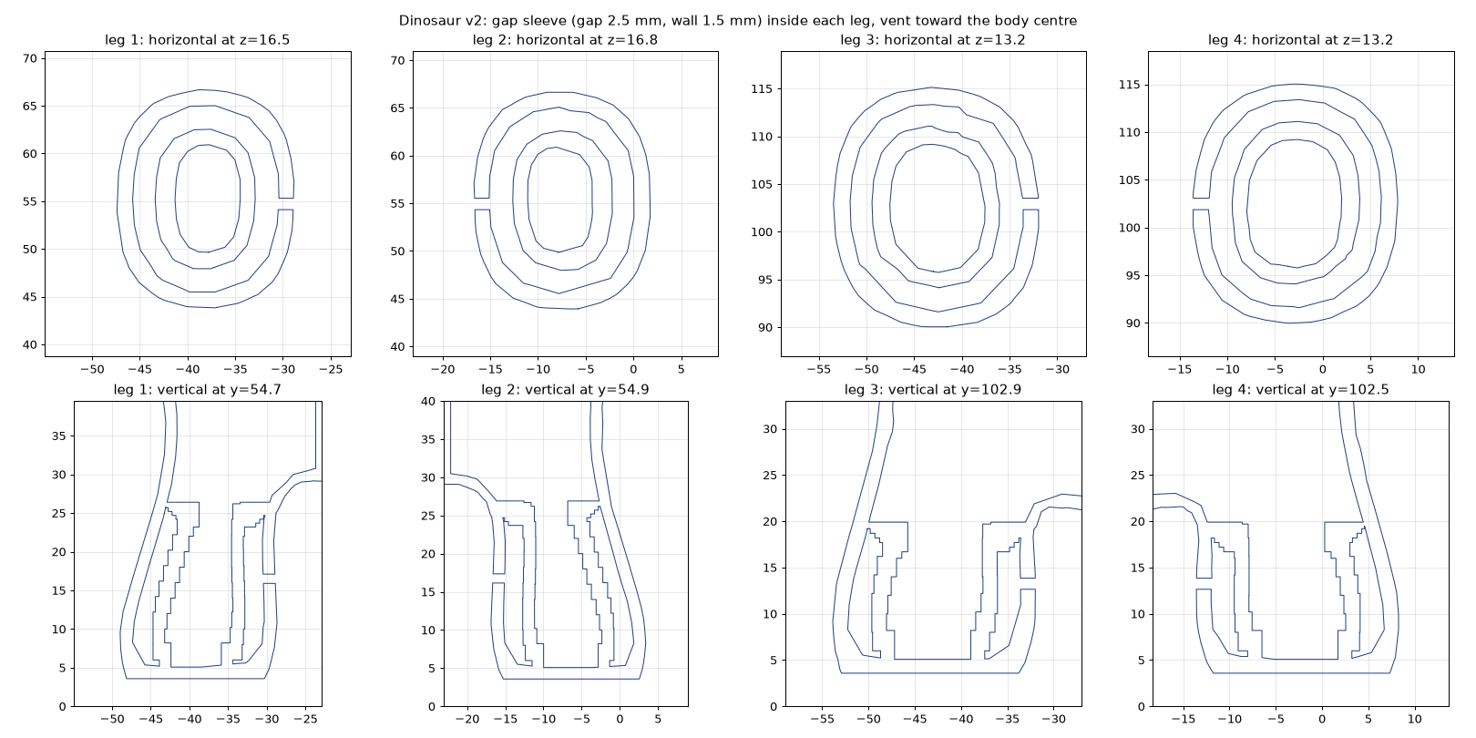
3d-models/dino-air-v2-leg-gap.png
