CreatorKanata/pneutouch-ai-rehc2026/3d-models/notes/new-dinasour-7chambers-t1p8-back-raised-sections.png

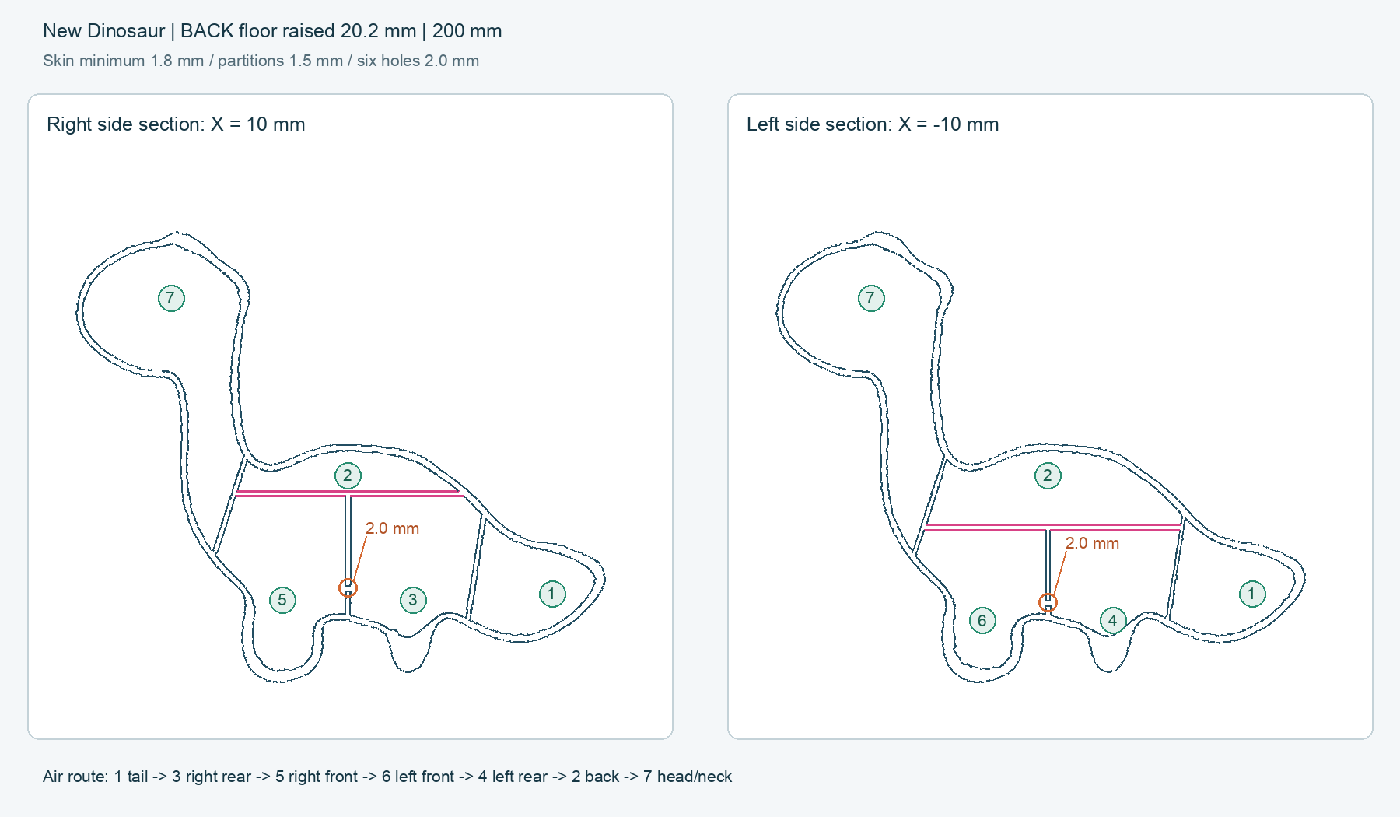
3d-models/notes/new-dinasour-7chambers-t1p8-back-raised-sections.png
