CreatorKanata/pneutouch-ai-rehc2026/docs/analysis/2026-10-15-pneumatic-sim/features-mech_tau4_sealed.png

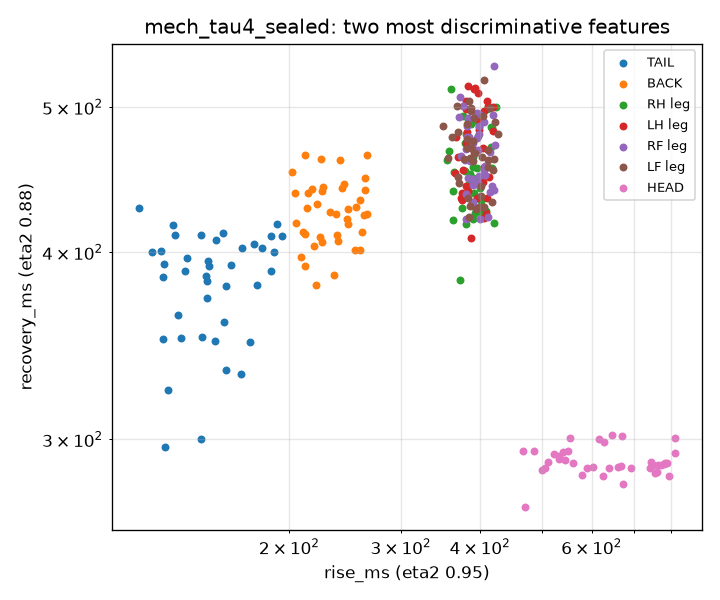
docs/analysis/2026-10-15-pneumatic-sim/features-mech_tau4_sealed.png
