CreatorKanata/pneutouch-ai-rehc2026/docs/analysis/2026-10-15-pneumatic-sim/features-star_graded.png

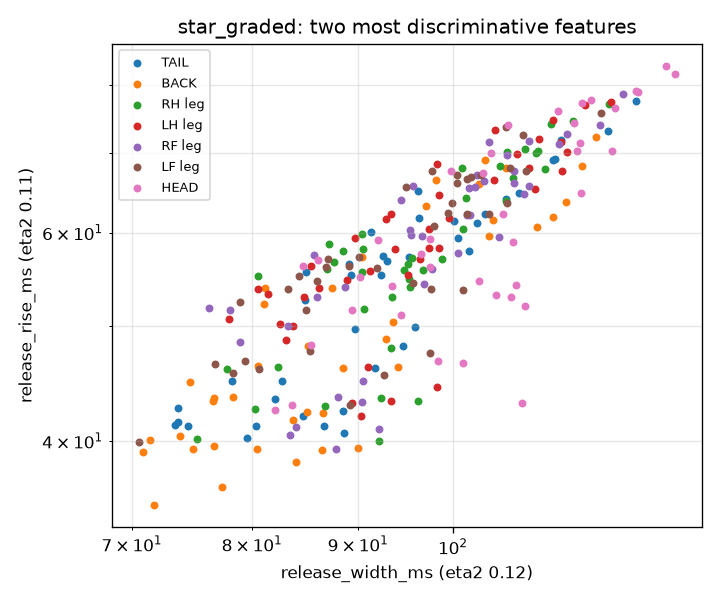
docs/analysis/2026-10-15-pneumatic-sim/features-star_graded.png
