CreatorKanata/pneutouch-ai-rehc2026/docs/analysis/2026-10-15-pneumatic-sim/waveforms-mech_tau4_snap.png

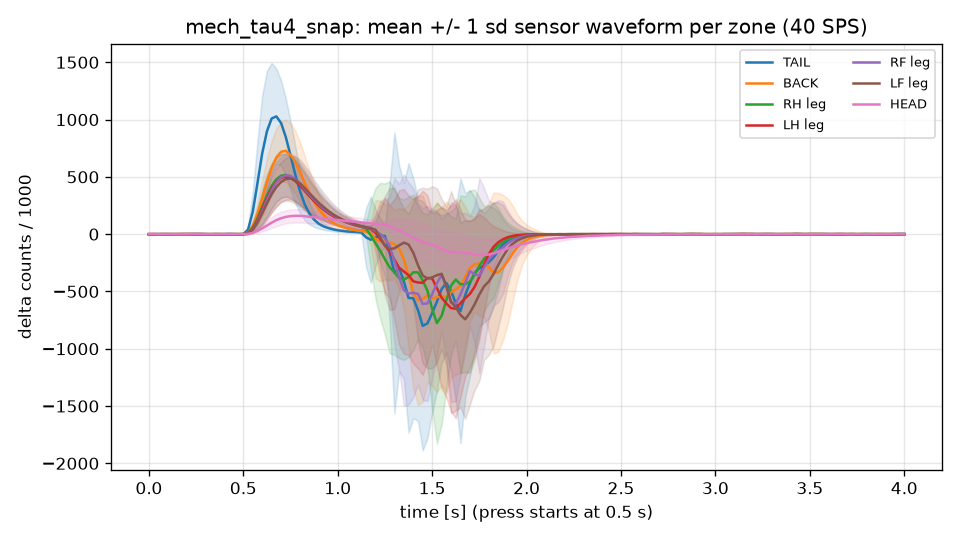
docs/analysis/2026-10-15-pneumatic-sim/waveforms-mech_tau4_snap.png
