CreatorKanata/pneutouch-ai-rehc2026/docs/analysis/2026-10-23-dino-85a/waveforms.png

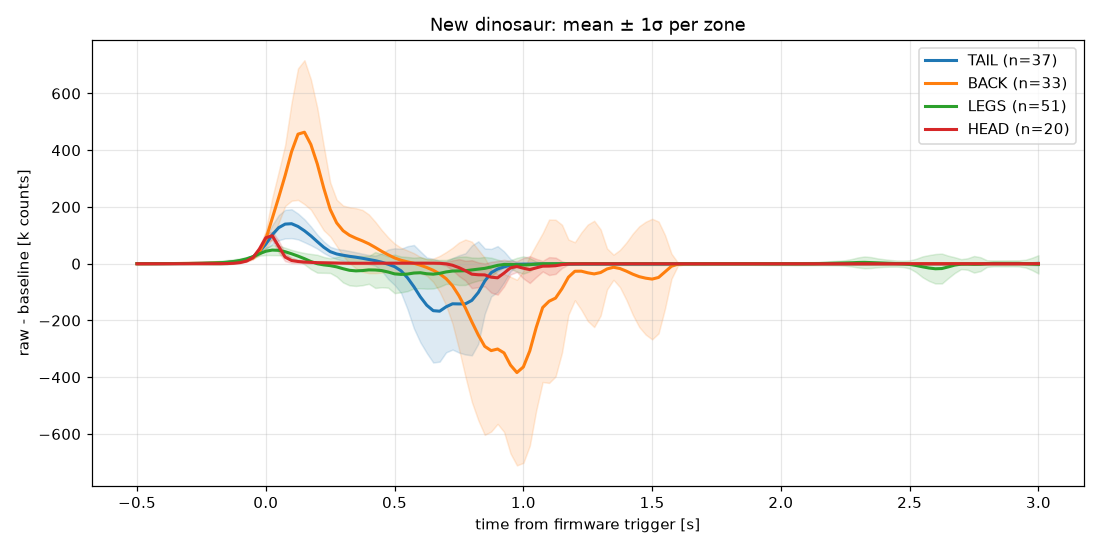
docs/analysis/2026-10-23-dino-85a/waveforms.png
