CreatorKanata/pneutouch-ai-rehc2026/images/demo/back.jpg

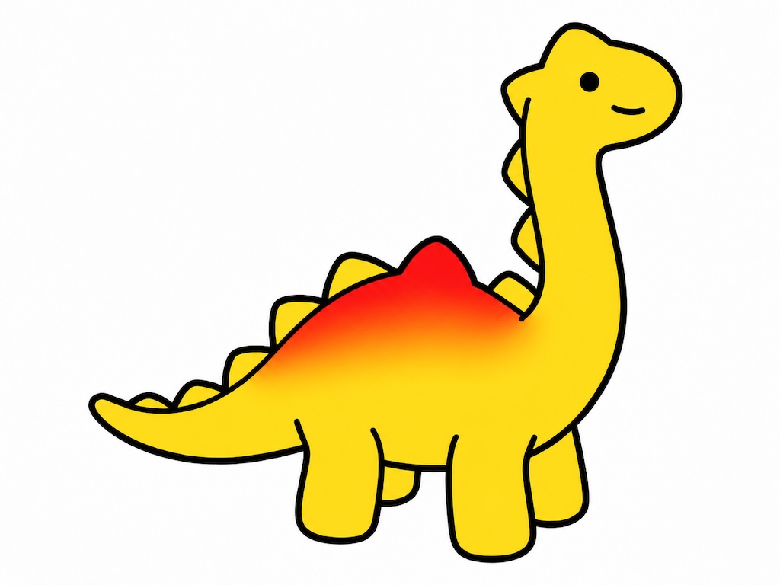
images/demo/back.jpg
