CreatorKanata/pneutouch-ai-rehc2026/images/demo/head.jpg

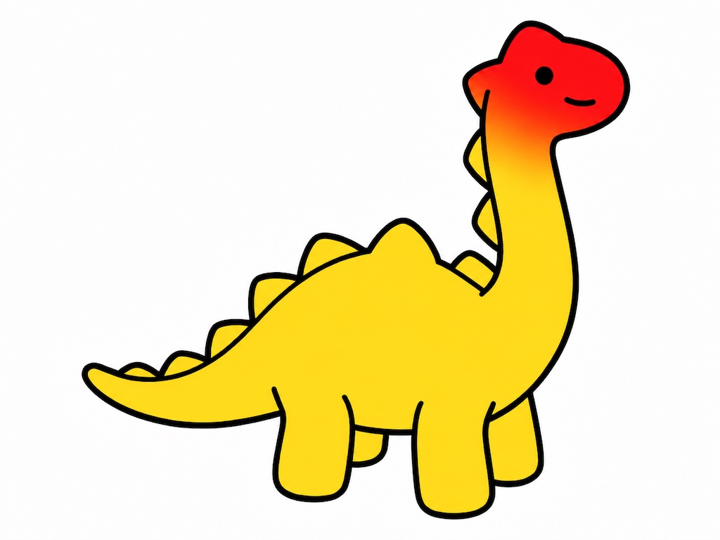
images/demo/head.jpg
