CreatorKanata/pneutouch-ai-rehc2026/images/demo/krag-hat.jpg

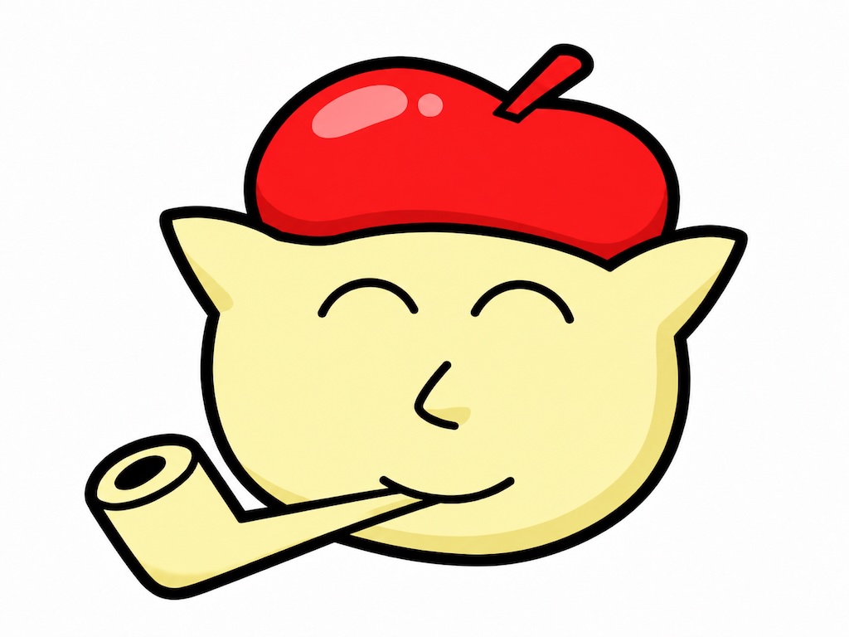
images/demo/krag-hat.jpg
