CreatorKanata/pneutouch-ai-rehc2026/images/demo/krag-normal.jpg

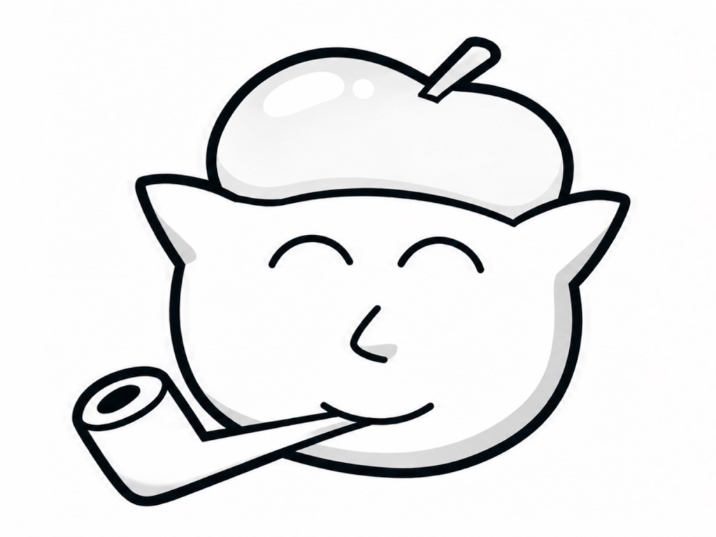
images/demo/krag-normal.jpg
