CreatorKanata/pneutouch-ai-rehc2026/images/final/circuit-diagram.jpg

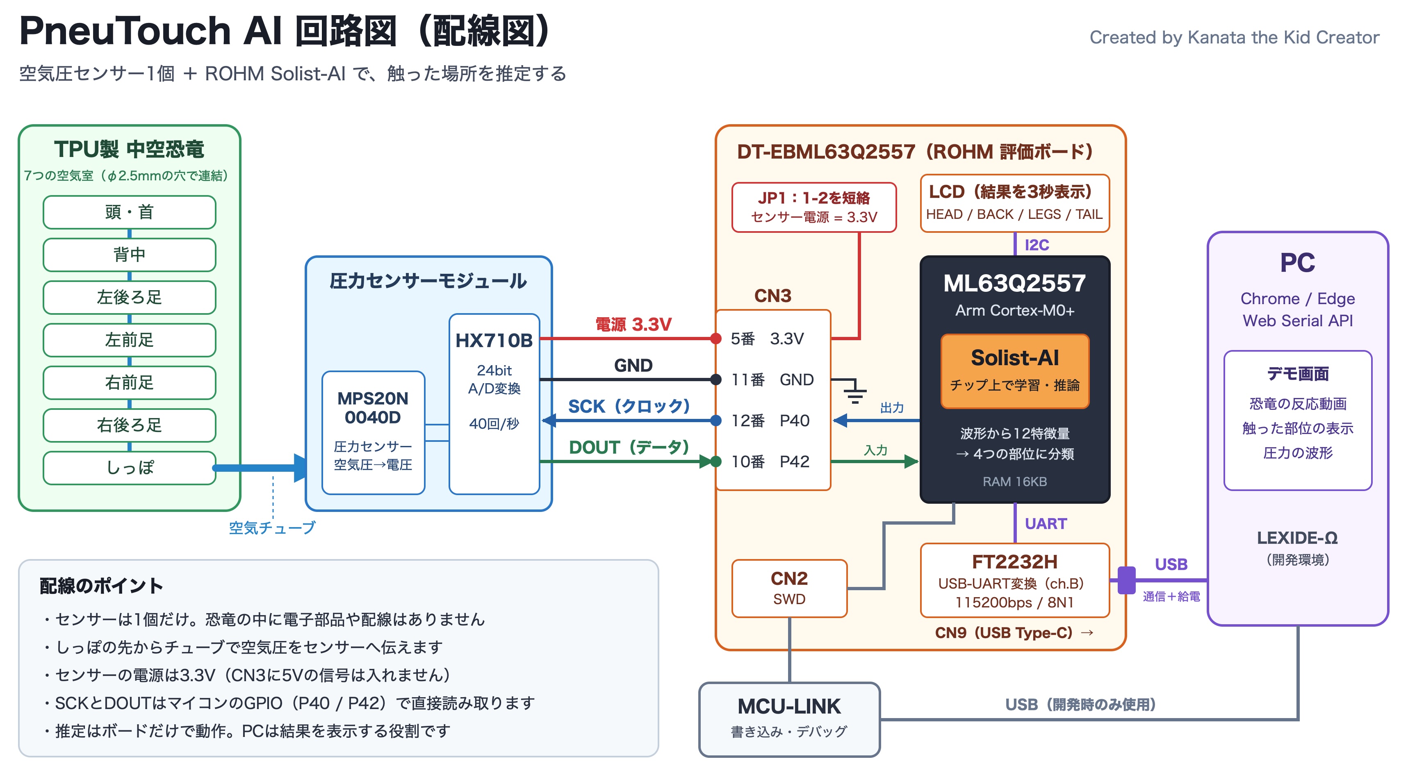
images/final/circuit-diagram.jpg
