CreatorKanata/pneutouch-ai-rehc2026/images/final/wallpaper.jpg

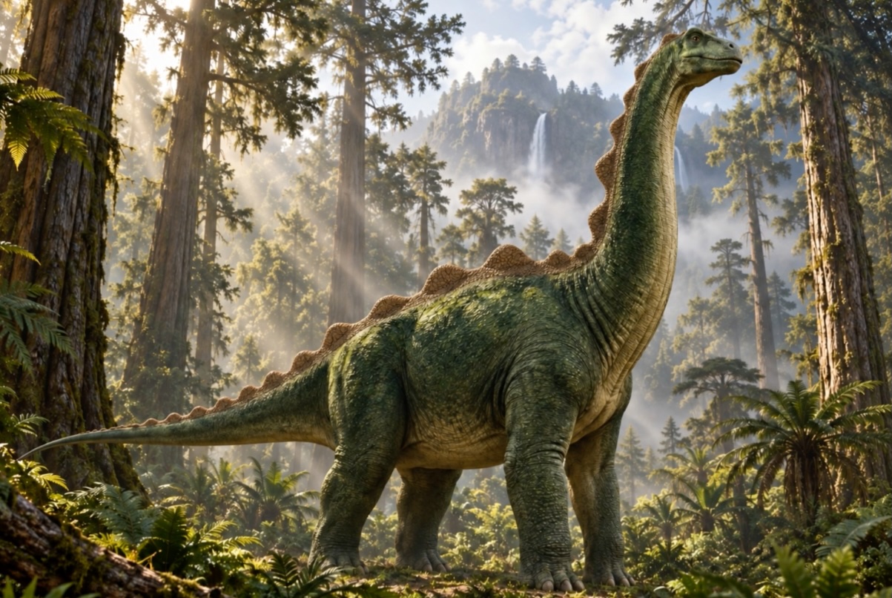
images/final/wallpaper.jpg
