CreatorKanata/pneutouch-ai-rehc2026/images/protopedia/air-chambers-illustration-original.png

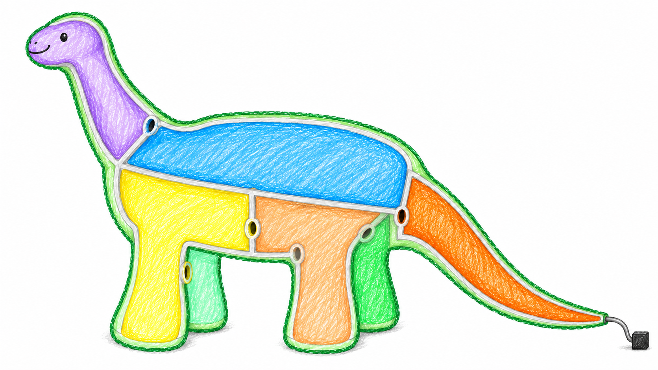
images/protopedia/air-chambers-illustration-original.png
