CreatorKanata/pneutouch-ai-rehc2026/images/protopedia/air-chambers-notitle.jpg

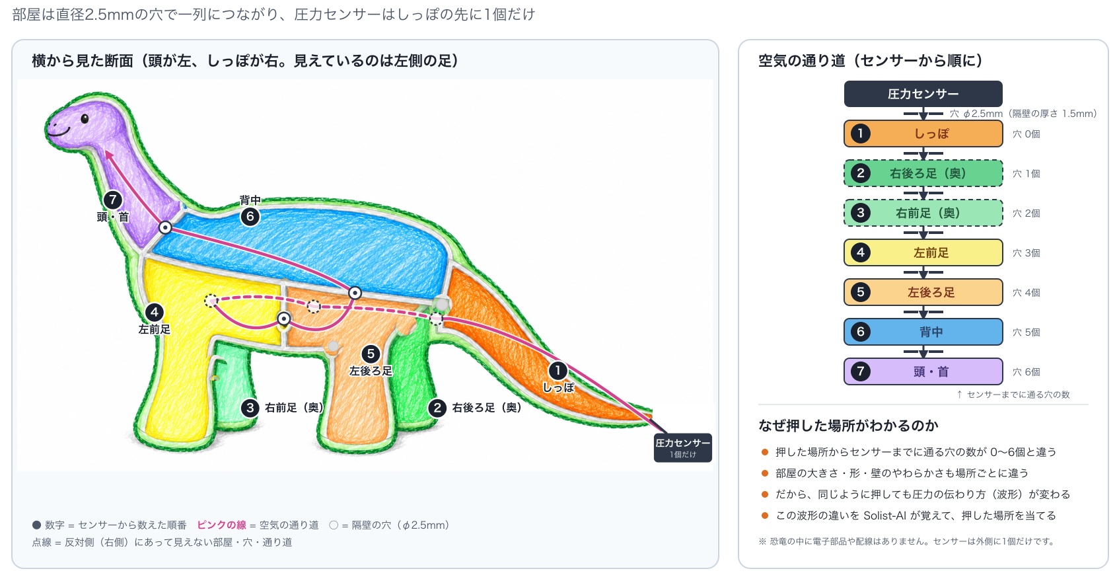
images/protopedia/air-chambers-notitle.jpg
