CreatorKanata/pneutouch-ai-rehc2026/images/protopedia/air-pressure-sensor.jpg

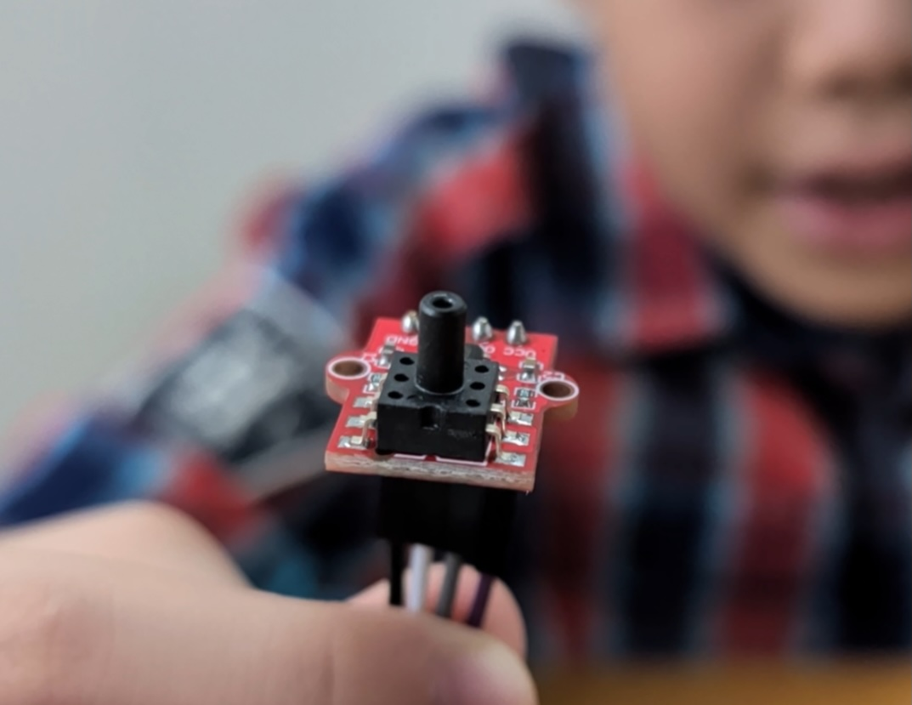
images/protopedia/air-pressure-sensor.jpg
