CreatorKanata/pneutouch-ai-rehc2026/images/protopedia/app.jpg

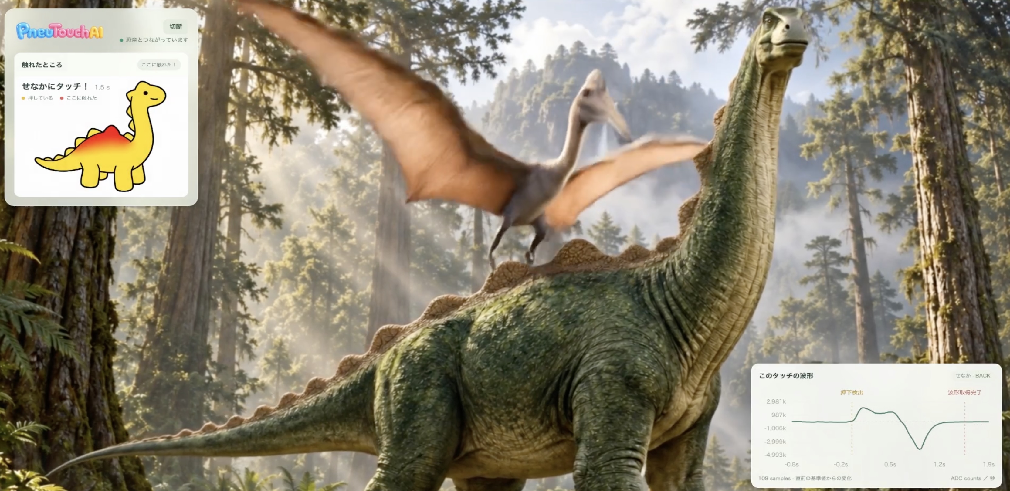
images/protopedia/app.jpg
