CreatorKanata/pneutouch-ai-rehc2026/images/protopedia/dino-figure-inside.jpg

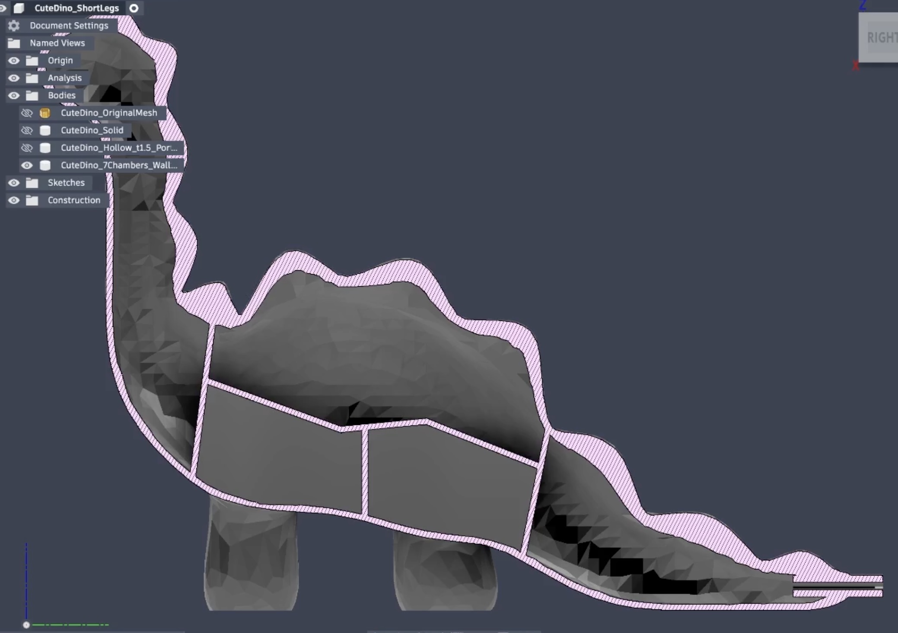
images/protopedia/dino-figure-inside.jpg
