CreatorKanata/pneutouch-ai-rehc2026/images/protopedia/thumbnail-orig.jpg

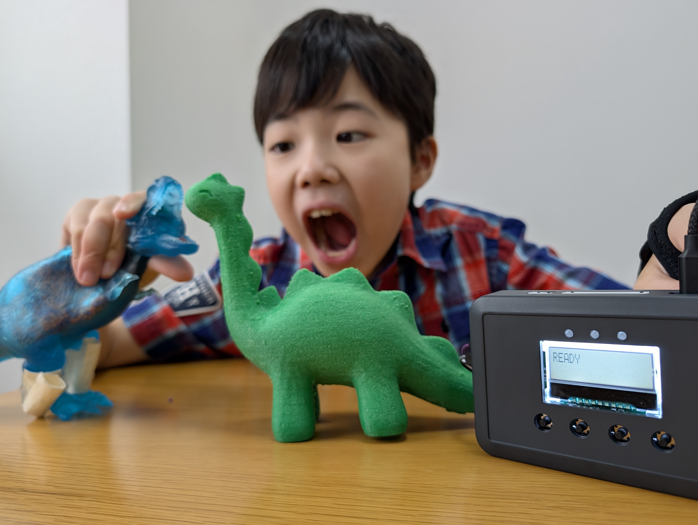
images/protopedia/thumbnail-orig.jpg
