CreatorKanata/pneutouch-ai-rehc2026/images/protopedia/waveform-features-notitle.jpg

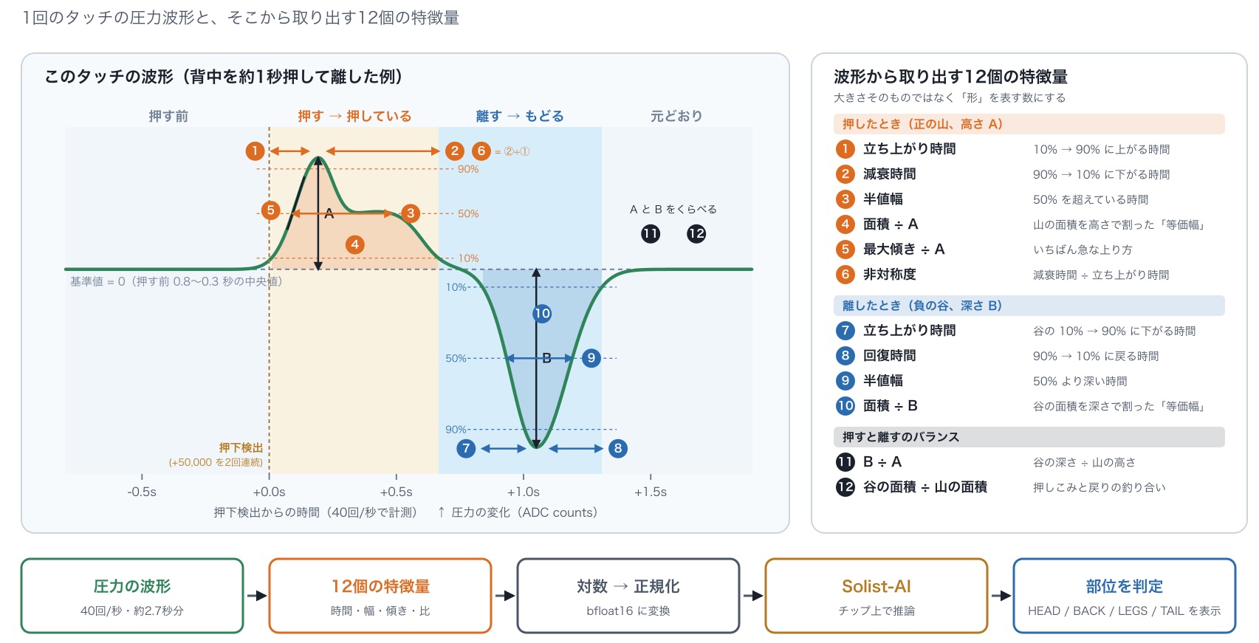
images/protopedia/waveform-features-notitle.jpg
