CreatorKanata/pneutouch-ai-rehc2026/3d-models/case/dino-case-front-body.3mf

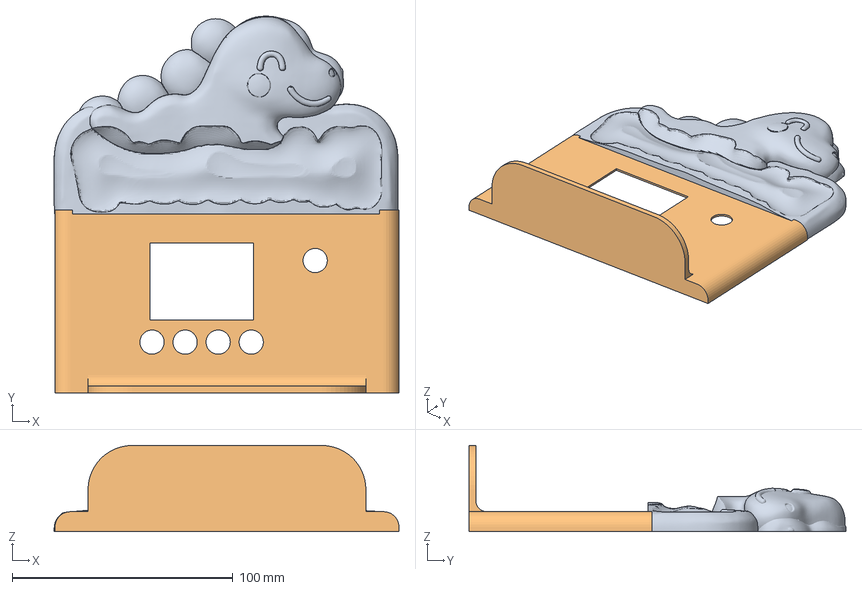
[picture p51: CAD file, 2026-11-10]
3d-models/case/dino-case-front-body.3mf
156.4 x 170.8 x 39.0 mm
3d logo mascot
dino-cover-front.stl
