CreatorKanata/pneutouch-ai-rehc2026/3d-models/new-dinasour-7chambers-t1p8-back-raised.stl

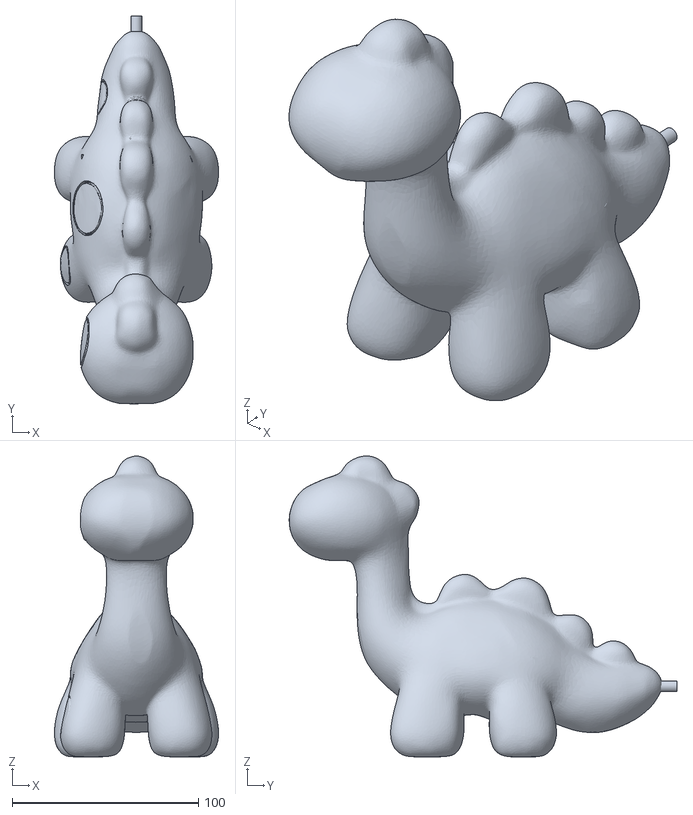
[picture p52: CAD file, 2026-11-10]
3d-models/new-dinasour-7chambers-t1p8-back-raised.stl
88.0 x 207.9 x 161.5
