CreatorKanata/pneutouch-ai-rehc2026/3d-models/test-pieces-internal/ti4-gap-1.5.stl

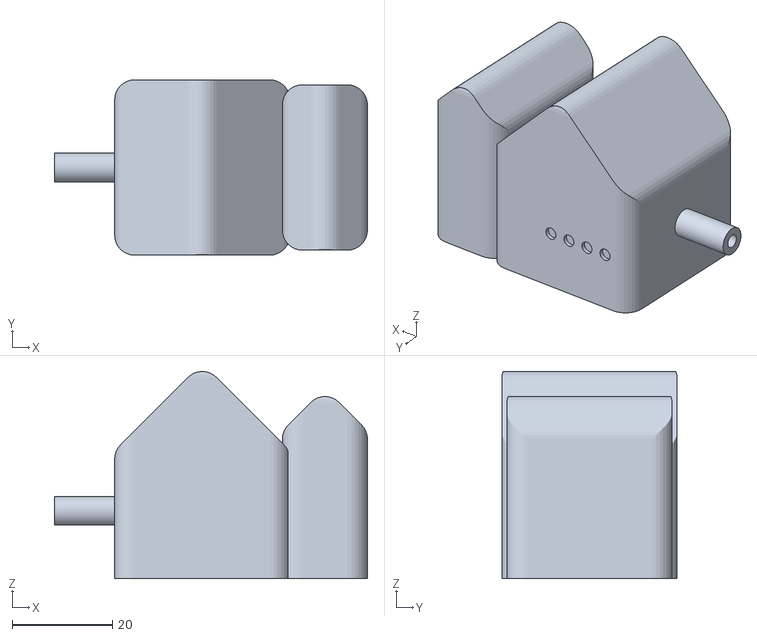
[picture p53: CAD file, 2026-10-20]
3d-models/test-pieces-internal/ti4-gap-1.5.stl
62.5 x 35.0 x 41.3
