CreatorKanata/pneutouch-ai-rehc2026/3d-models/test-pieces/tp2-flat-2.5.stl

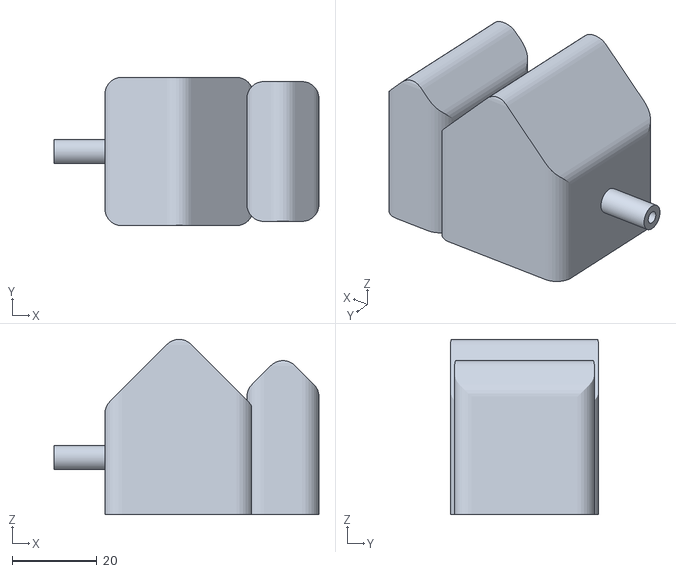
[picture p54: CAD file, 2026-10-20]
3d-models/test-pieces/tp2-flat-2.5.stl
62.5 x 35.0 x 41.3
