CreatorKanata/pneutouch-ai-rehc2026/3d-models/case/dino-case-front-sign.3mf

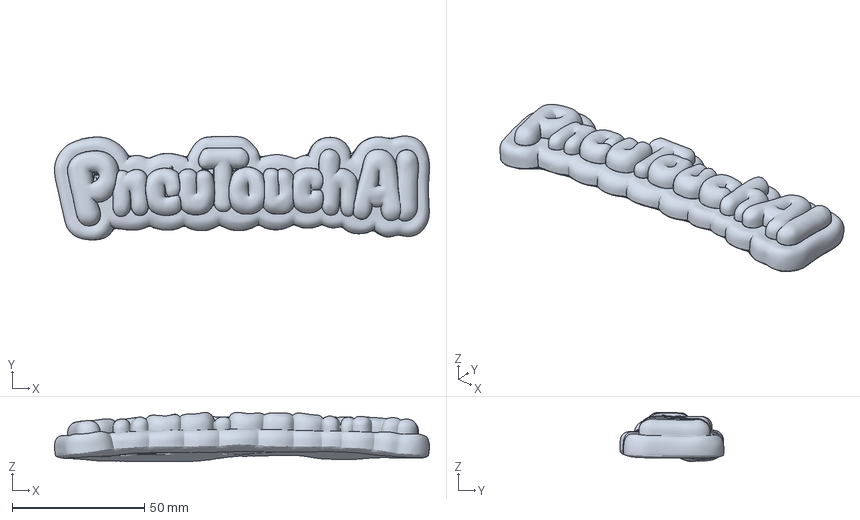
[picture p55: CAD file, 2026-11-10]
3d-models/case/dino-case-front-sign.3mf
141.7 x 39.2 x 18.7 mm
