CreatorKanata/pneutouch-ai-rehc2026/3d-models/dino-air-7segments.3mf

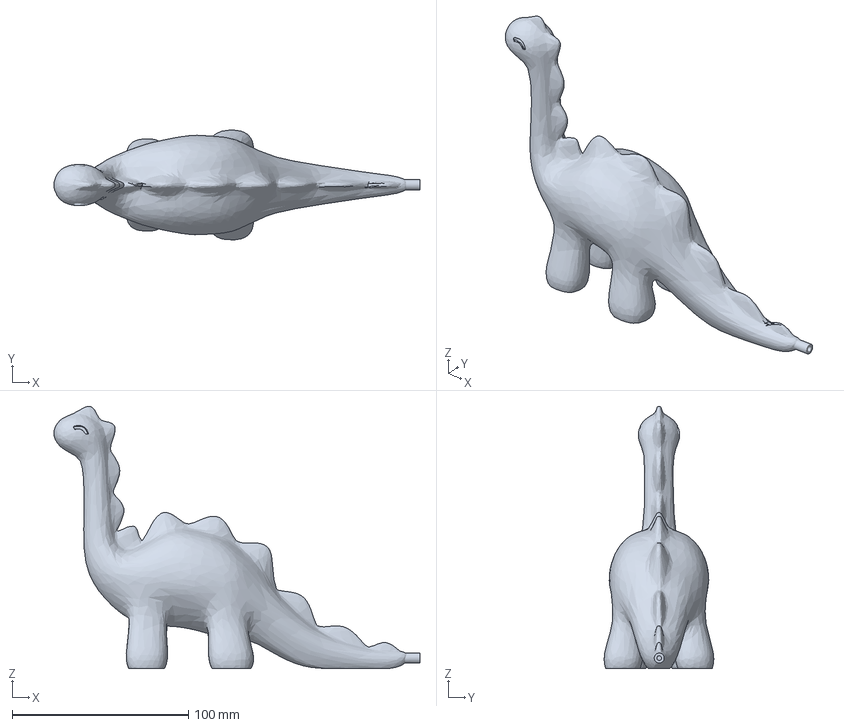
[picture p56: CAD file, 2026-09-20]
3d-models/dino-air-7segments.3mf
207.5 x 62.2 x 148.8 mm
