CreatorKanata/pneutouch-ai-rehc2026/3d-models/test-pieces/tp5-flat-1.5-small.stl

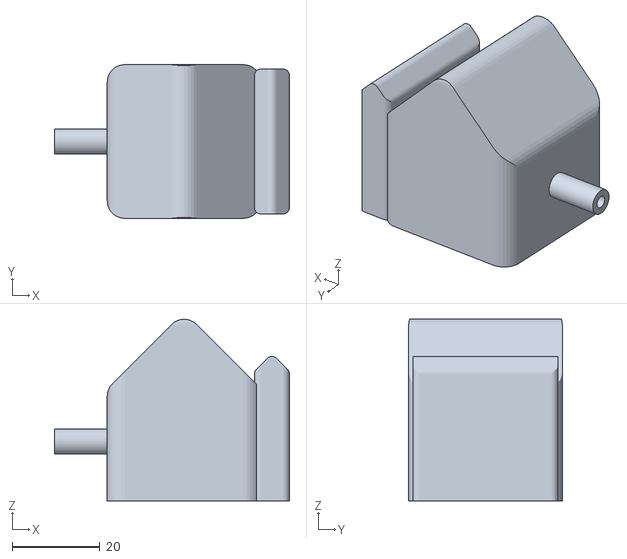
[picture p57: CAD file, 2026-10-20]
3d-models/test-pieces/tp5-flat-1.5-small.stl
53.5 x 35.0 x 41.3
