CreatorKanata/pneutouch-ai-rehc2026/3d-models/test-pieces/tp3-dome-1.5.stl

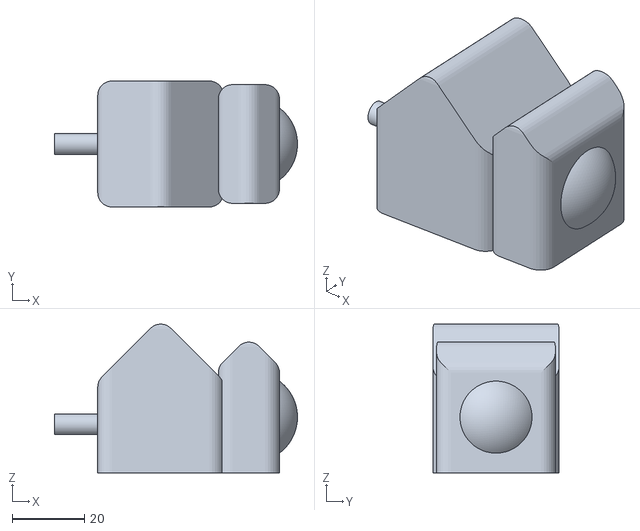
[picture p58: CAD file, 2026-10-20]
3d-models/test-pieces/tp3-dome-1.5.stl
67.5 x 35.0 x 41.3
