CreatorKanata/pneutouch-ai-rehc2026/3d-models/old/dino-air-no-segments.stl

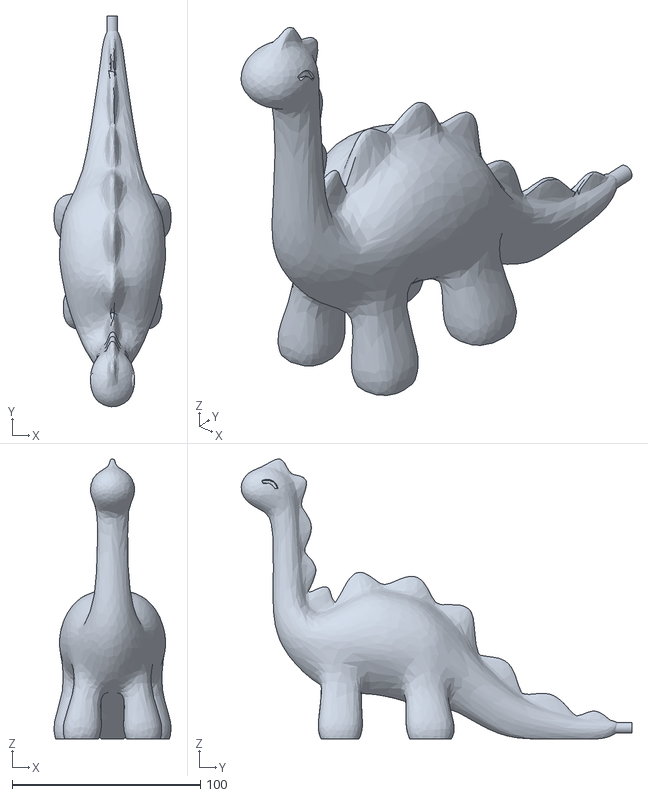
[picture p59: CAD file, 2026-11-10, an earlier design]
3d-models/old/dino-air-no-segments.stl
62.2 x 207.5 x 148.8
