CreatorKanata/pneutouch-ai-rehc2026/3d-models/old/new-dinosaur/02-pink-layout/new-dinasour-7chambers-t1p8-pink.stl

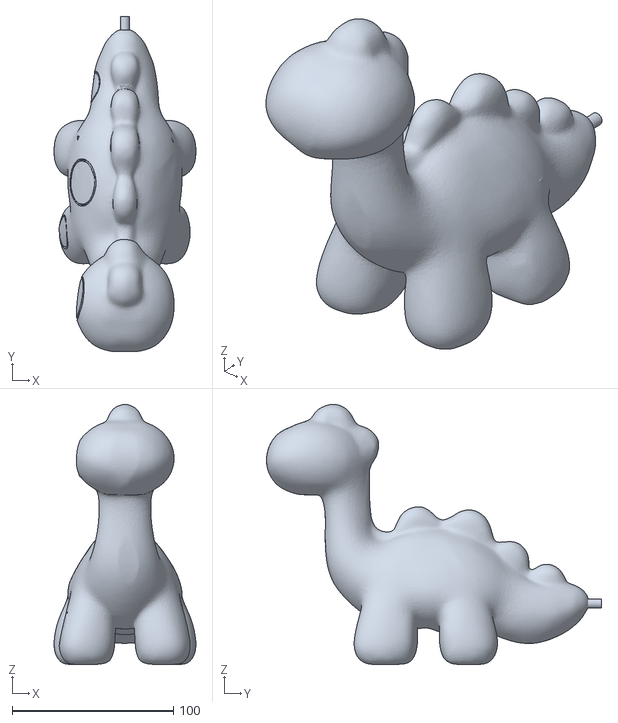
[picture p60: CAD file, 2026-11-10, an earlier design]
3d-models/old/new-dinosaur/02-pink-layout/new-dinasour-7chambers-t1p8-pink.stl
88.0 x 207.9 x 161.5
