CreatorKanata/pneutouch-ai-rehc2026/(list of files, cad)

Other CAD files:
3d-models/test-pieces-internal/ti3-ribs.stl
3d-models/test-pieces/tp4-bellows-1.5.stl
3d-models/test-pieces-internal/ti1-plain.stl
3d-models/test-pieces-internal/ti5-gap-3.0.stl
3d-models/test-pieces/tp1-flat-1.5.stl
3d-models/test-pieces-internal/ti2-thick-3.0.stl
3d-models/old/new-dinosaur/03-back-reversed/new-dinasour-7chambers-t1p8-back-reversed.stl
3d-models/old/dino-air-7segments.3mf
3d-models/dino-air-7segments.stl
