CreatorKanata/pneutouch-ai-rehc2026/3d-models/test-pieces-internal/how-to-identify.png

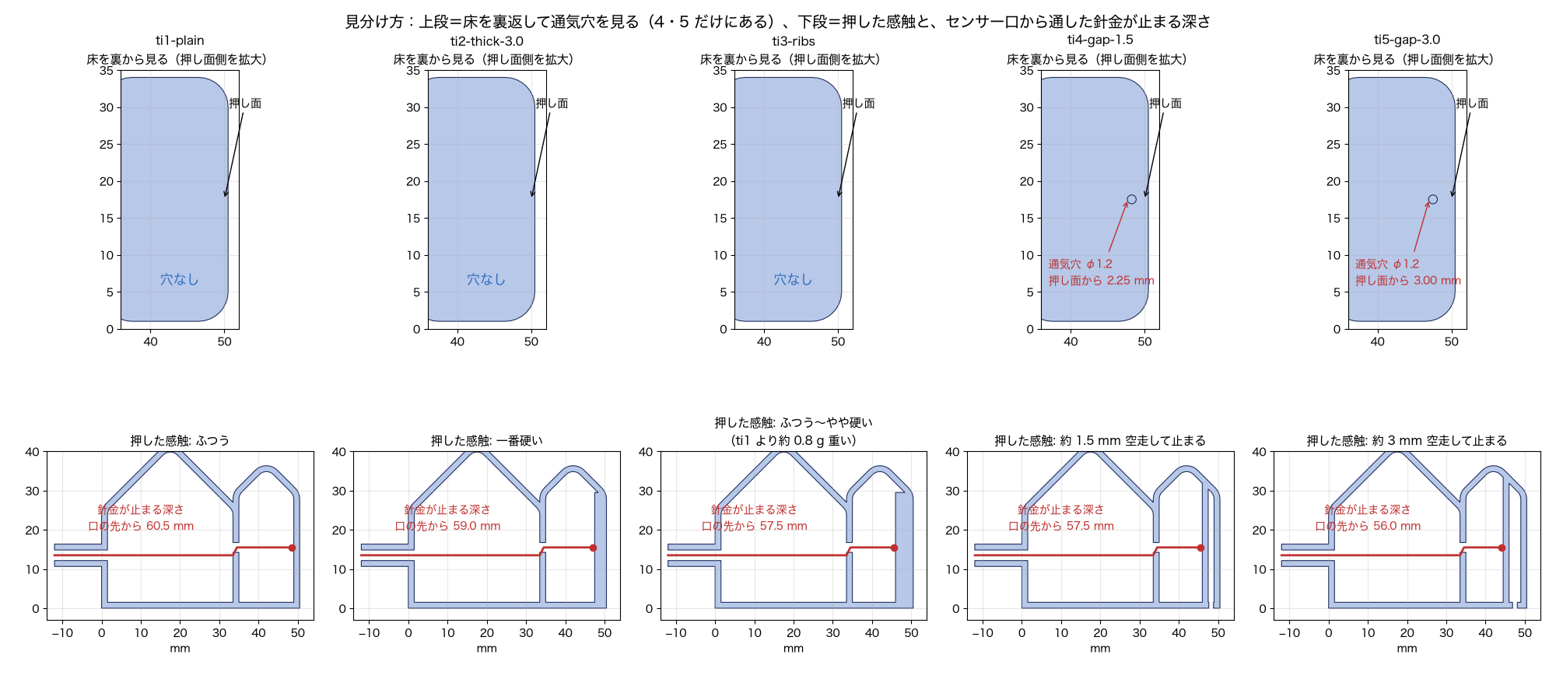
3d-models/test-pieces-internal/how-to-identify.png
