CreatorKanata/pneutouch-ai-rehc2026/3d-models/test-pieces-internal/README.md

# 内部構造だけが違う試験片（2026-10-16）

`tools/make_test_pieces.py --set internal` で生成。**外形はすべて同じ**（皮は平面 1.5 mm、縁は半径 4 mm で丸め）で、
皮の内側だけが違う。「表面の形は指定され、内部の設計だけで押した場所を見分ける」という前提に合わせたもの。
（押し面そのものを変える旧セットは `../test-pieces/`。）

| ファイル | 内部 | 狙い | TPU 体積 |
|---|---|---|---:|
| `ti1-plain.stl` | なし | 基準 | 14.2 cm³ |
| `ti2-thick-3.0.stl` | 内側から肉厚 3.0 mm | 硬さだけ変える（c/k は変わらない予想） | 15.4 cm³ |
| `ti3-ribs.stl` | 皮の裏に縦リブ（1.5 × 高さ 3、ピッチ 6） | 曲げ剛性と減衰を変える | 14.8 cm³ |
| `ti4-gap-1.5.stl` | 皮の裏に 1.5 mm の隙間＋第 2 の膜 1.5 mm | 押し込みの「あそび」1.5 mm → 遅れて立ち上がる 2 段の山 | 15.5 cm³ |
| `ti5-gap-3.0.stl` | 皮の裏に 3.0 mm の隙間＋第 2 の膜 1.5 mm | あそび 3.0 mm。ti4 との差が「設計で変えられる量」 | 15.5 cm³ |

隙間（ポケット）は床の φ1.2 mm の穴で外気に通じている（通気しないと空気ばねになって動かない）。
主室とは第 2 の膜で仕切られ、φ2.5 mm の穴で胴体室につながるのは主室のほう。

共通: 胴体室 内寸 32×32×24 mm、壁 1.5 mm、押す室 内寸 30×28、奥行 14、センサー口は外径 5.7 / 内径 2.7 / 長さ 12 mm。
すべての壁は 1.5 mm 以上。

## 見分け方（印刷済みの個体に番号がない場合）

1. 裏返して床を見る。押し面に近い床に φ1.2 mm の穴がある 2 個が ti4 / ti5。
2. ti4 / ti5 は押し面の中央を押す。空走が約 1.5 mm なら ti4、約 3 mm なら ti5。
3. 残り 3 個で押し面が一番硬いものが ti2。
4. ti1 と ti3 は重さ（ti3 が約 0.8 g 重い）か、センサー口から φ1 mm の針金を通して止まる深さで判別する。
   口の先端から止まるまで: ti1 60.5 / ti2 59.0 / ti3 57.5 / ti4 57.5 / ti5 56.0 mm（隔壁の穴は口の軸から z 方向に 2 mm ずれている）。

2026-10-20 以降に生成した STL には、胴体の +Y 側面に番号と同じ個数のくぼみ（φ2.5、深さ 0.8）が付く。

## 印刷

- STL の向きのまま（床がベッド、押し面は +X の垂直な壁、屋根は 45° 切妻）。サポート不要。リブと第 2 の膜は垂直な板なのでそのまま印刷できる。
- 材料 TPU 85A、1 個あたり約 2 時間の見込み。
- 印刷順: **ti1 → ti4 → ti5**（あそびの効果を先に）→ ti3 → ti2。

## 測定（印刷後）

1. センサー口に恐竜と同じチューブでモジュールをつなぐ。学習ツール（`python tools/serve.py`）で CSV を記録。
2. 押し面の中央を「約 1 秒押して離し、3 秒待つ」で 10 回。強さは弱・普通・強を混ぜる。
3. 5 種類を同じ日に、同じ人が測る。ファイル名に片の名前を入れる。
4. `tools/analyze_pressure.py` で 12 特徴量を出し、`rise_ms`、`width_ms`、`decay_ms`、`recovery_ms`、`slope_norm` を片ごとに比べる。
5. **go 条件**: ti1 / ti4 / ti5 の 3 つが、強弱を混ぜても最近重心法で 8 割以上分かれる（あそびが設計変数になる証拠）。
   加えて ti3 か ti2 が ti1 と分かれれば、設計変数が 2 つになる。
