CreatorKanata/pneutouch-ai-rehc2026/3d-models/test-pieces/README.md

# 空気圧試験片（2026-10-15）

`tools/make_test_pieces.py` で生成。押し面の力学だけが違う 5 種類で、「壁の沈み込みの速さが 40 SPS の波形を変えるか」を確かめる
（設計の根拠は `docs/final-judging/reprint-design.md` 3d 節）。

```sh
.venv/bin/python tools/make_test_pieces.py --out 3d-models/test-pieces
```

| ファイル | 押し面 | 狙い | TPU 体積 |
|---|---|---|---:|
| `tp1-flat-1.5.stl` | 平面 1.5 mm | 基準（速く沈む） | 14.2 cm³ |
| `tp2-flat-2.5.stl` | 平面 2.5 mm | 硬さだけ変える対照 | 15.0 cm³ |
| `tp3-dome-1.5.stl` | 球面ドーム（底半径 10、高さ 5、壁 1.5） | スナップによる 2 段の山 | 14.4 cm³ |
| `tp4-bellows-1.5.stl` | 蛇腹 3.5 山（振幅 3、ピッチ 8、壁 1.5） | 遅い復元 | 14.3 cm³ |
| `tp5-flat-1.5-small.stl` | 平面 1.5 mm、奥行 5（容積 1/3） | 容積による圧力フィードバック | 12.5 cm³ |

共通: 胴体室 内寸 32×32×24 mm、壁 1.5 mm、押す室 内寸 30×28 mm（奥行 14）、隔壁 φ2.5 mm の穴 1 個、
センサー口は外径 5.7 / 内径 2.7 / 長さ 12 mm（恐竜のしっぽと同じ）。**すべての壁は 1.5 mm 以上**（TPU の破れ・ピンホール対策）。
ベッド接地面以外の縁は半径 4 mm で丸めてある（押しやすさ。蛇腹の山は 1.5 mm、奥行 5 の片は 1.5 mm）。

## 印刷

- 向き: STL のまま（床 z=0 がベッド、押し面は +X 側の垂直な壁、屋根は 45° の切妻）。サポート不要。
- 材料: TPU 85A。恐竜本体と同じ設定（層厚・壁数）で、気密のため壁数 3 以上か 1.5 mm を満たすよう確認する。
- 印刷順: **tp1 → tp3 → tp4**（形の効果を見る 3 つを先に）→ tp2 → tp5。1 個あたり約 2 時間の見込み（恐竜 68.5 cm³ が 10 時間）。
- ドームと蛇腹は横向きの張り出しが最大 45° なので印刷できるはずだが、垂れたら冷却を上げる。

## 測定（10/16）

1. センサー口に恐竜と同じチューブで HX710B モジュールをつなぐ。学習ツール（`python tools/serve.py`）で CSV を記録。
2. 押し面の中央を「約 1 秒押して離し、3 秒待つ」で 10 回。強さは弱・普通・強を混ぜる。
3. 5 種類を同じ日に、同じ人が測る。ファイル名に片の名前を入れる。
4. `tools/analyze_pressure.py` で 12 特徴量を出し、`width_ms`、`decay_ms`、`recovery_ms` を片ごとに比べる。
5. **go 条件**: 5 種類のうち 4 種類以上で山の幅・減衰が互いに 2 倍以上違い、強弱で順序が入れ替わらない。
   通れば恐竜 v2（頭＝速い、背中＝遅い、尾＝やや速い、足＝基準）の CAD に進む。
