CreatorKanata/pneutouch-ai-rehc2026/docs/analysis/2026-09-20-live-calibration/README.md

# ライブデモ用の追加計測

2026-09-20、最初のライブ試験で頭・背中がTAILになったため、現在の押し方を追加計測する。
各区間はユーザーの「開始」で受信を始め、「終了」で止める。約1秒押して離し、約3秒待つ。
MCUには教師ラベルを送らず、実センサーの取得をCSVへ保存する。CSVのlabelは従来の7区画番号。

| ファイル | 指定部位 | 状態 |
|---|---|---|
| pressure-head-20260920-200652.csv | HEAD / zone 7 | 2441点、欠番0。全文特徴3件、うち開始前の押下を含む1件を除く完全な波形は2件 |
| pressure-head-supplement-20260920.csv | HEAD / zone 7 | 3817点、欠番0、13イベント。ユーザーが全件頭・首と確認済み |
| pressure-back-20260920.csv | BACK / zone 2 | 4719点、欠番0。完全なC再生と実機特徴が一致した12件を採用 |
| pressure-legs-20260920.csv | LEGS / CSV label 3 | 4613点、欠番0。完全な17件を採用。label 3は今回は足4本全体を表し、右後ろ足だけという意味ではない |
| pressure-tail-20260920.csv | TAIL / zone 1 | 4705点、欠番0。完全な16件を採用 |

合計60件。`model-selection.json`で選択・確認用データを分離した実チップ比較を記録する。
実装・結果・制限の説明は[ライブデモ](../../live-pressure-demo-20260920.md)。

計測のJSONは開始・終了時刻とサンプル数、UARTログはMCUのイベント・特徴・推定・LCD通知を残す。
推定された文字は正解ラベルとして使わない。指定部位とユーザーの確認だけを教師情報とする。
元の43件は `../2026-09-20-pressure/results/solist-inputs.json` に保存済み。
