CreatorKanata/pneutouch-ai-rehc2026/docs/analysis/2026-10-21-test-pieces/README.md

# 試験片 ti1 / ti4 / ti5 の計測（2026-10-21）

手順: [docs/final-judging/test-pieces-protocol.md](../../final-judging/test-pieces-protocol.md)。
操作者 1 名（Hide）、同日・同セッション、TPU 85A の試験片、センサーは恐竜と同じ MPS20N0040D + HX710B、現行ファームウェア（40 SPS）。
生データは `raw/`（SHA-256 は `raw/SHA256SUMS`）。解析は `tools/analyze_test_pieces.py`、結果は `summary.md`、`waveforms.png`、`features.png`、`events.csv`。

## 結果

| 片 | 内部 | n | 山の幅 ms | 減衰 ms | 谷の幅 ms | 回復 ms |
|---|---|---:|---:|---:|---:|---:|
| ti1 | なし | 16 | 445 | 336 | 253 | 414 |
| ti4 | あそび 1.5 mm | 10 | 412 | 116 | 229 | 366 |
| ti5 | あそび 3.0 mm | 10 | 289 | 140 | 200 | 380 |

- ti1 / ti4 / ti5 の 3 分類（一回抜き最近重心法、振幅を使わない 12 特徴量）: **97.2% → go**。
- 減衰時間の中央値の比: ti1/ti4 = 2.89、ti1/ti5 = 2.41（2 倍以上）。ti4/ti5 は山の幅で 1.43 倍だが 2 分類では 95%。
- 波形: あそびのある片は山の後に急に落ちて谷が早く来る。あそびなしは山がゆっくり減衰する。

## 制限

- 1 人・1 日・1 セッション。操作者差・別日の再現は未確認。
- 押す強さと減衰時間の相関は −0.56〜−0.70（強いほど短い）。強さを混ぜても分類は 97% だったが、特徴が完全に強さ不変ではない。
- ti2（肉厚）と ti3（リブ）は未計測。
