CreatorKanata/pneutouch-ai-rehc2026/docs/analysis/2026-10-21-test-pieces/summary.md

# 試験片の比較

入力イベント: 検出 36、完全な波形 36。

## 片ごとの中央値（完全な波形のみ）

| 片 | n | 山 (k) | 立ち上がり ms | 山の幅 ms | 減衰 ms | 谷の幅 ms | 回復 ms | 谷/山 | 面積比 |
|---|---:|---:|---:|---:|---:|---:|---:|---:|---:|
| ti1 | 16 | 1152 | 260 | 445 | 336 | 253 | 414 | 1.50 | 0.94 |
| ti4 | 10 | 1640 | 201 | 412 | 116 | 229 | 366 | 1.13 | 0.79 |
| ti5 | 10 | 1562 | 179 | 289 | 140 | 200 | 380 | 1.11 | 0.94 |

## 分離（一回抜き最近重心法、振幅を含まない 12 特徴量）

- ti1 / ti4 / ti5 の 3 分類（go 判定）: **97.2%** → **go**（基準: 80% 以上、丸め前の精度で判定）
- go 判定用の完全な波形数: ti1=16、ti4=10、ti5=10

全片・ペア別の精度は参考値（go 判定には使わない）。

- 全片: **97%**（偶然 33%）
- ti1 vs ti4: 96%
- ti1 vs ti5: 96%
- ti4 vs ti5: 95%

## go / no-go の判定材料

### 時間特徴の中央値の比（片のペアごとに最大のもの。2 倍以上なら「設計で差が作れた」）

| 片 A | 片 B | 特徴 | 比 |
|---|---|---|---:|
| ti1 | ti4 | decay_ms | 2.89 ✔ |
| ti1 | ti5 | decay_ms | 2.41 ✔ |
| ti4 | ti5 | width_ms | 1.43 |

### 押す強さとの相関（片の中で、山の高さの順位と時間特徴の順位の相関。|ρ| が小さいほど強さに頑健）

| 片 | width_ms | decay_ms | recovery_ms | release_width_ms |
|---|---:|---:|---:|---:|
| ti1 | -0.03 | -0.56 | +0.85 | +0.35 |
| ti4 | -0.65 | -0.70 | +0.52 | +0.41 |
| ti5 | -0.37 | -0.58 | +0.70 | +0.43 |

## 図

- `waveforms.png`: 片ごとの平均波形（左: 生の counts、右: 山で正規化）
- `features.png`: 特徴量の散布図
- `events.csv`: 全イベントの特徴量
