CreatorKanata/pneutouch-ai-rehc2026/docs/analysis/2026-10-21-test-pieces/events.csv

piece | file | event | complete | exclusion | rise_ms | width_ms | decay_ms | release_width_ms | recovery_ms | trough_peak_ratio | area_ratio | peak_counts | trough_counts | rise_ms | decay_ms | width_ms | area_width_ms | slope_norm_s | asymmetry | release_rise_ms | recovery_ms | release_width_ms | release_area_width_ms | trough_peak_ratio | area_ratio
ti1 | ti1-plain-20261021-1..csv | 1 | True |  | 240.3010258464362 | 465.8391607813677 | 680.0337036590838 | 259.34906737526563 | 384.1684923461077 | 1.6793089090706714 | 0.9781334785057227 | 485146.0 | 814710.0 | 240.3010258464362 | 680.0337036590838 | 465.8391607813677 | 506.0945790542735 | 6.50913333305841 | 2.8299242638009283 | 143.24778122347493 | 384.1684923461077 | 259.34906737526563 | 294.7808163163942 | 1.6793089090706714 | 0.9781334785057227
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
