CreatorKanata/pneutouch-ai-rehc2026/docs/analysis/2026-09-20-live-calibration/pressure-back-20260920.csv

host_utc | seq | mcu_ms | raw | label
2026-09-20T11:12:48.591044+00:00 | 19536 | 723297 | 4015914 | 2
2026-09-20T11:12:48.606022+00:00 | 19537 | 723322 | 4013729 | 2
2026-09-20T11:12:48.637788+00:00 | 19538 | 723347 | 4025153 | 2
2026-09-20T11:12:48.654027+00:00 | 19539 | 723372 | 4052049 | 2
2026-09-20T11:12:48.684768+00:00 | 19540 | 723397 | 4091214 | 2
2026-09-20T11:12:48.716916+00:00 | 19541 | 723423 | 4105583 | 2
2026-09-20T11:12:48.732913+00:00 | 19542 | 723448 | 4079050 | 2
2026-09-20T11:12:48.765914+00:00 | 19543 | 723473 | 4044010 | 2
2026-09-20T11:12:48.780914+00:00 | 19544 | 723498 | 4004503 | 2
2026-09-20T11:12:48.812930+00:00 | 19545 | 723523 | 3973385 | 2
2026-09-20T11:12:48.828948+00:00 | 19546 | 723549 | 3953669 | 2
2026-09-20T11:12:48.862003+00:00 | 19547 | 723574 | 3940936 | 2
2026-09-20T11:12:48.892940+00:00 | 19548 | 723599 | 3943655 | 2
2026-09-20T11:12:48.908766+00:00 | 19549 | 723624 | 3954014 | 2
2026-09-20T11:12:48.940684+00:00 | 19550 | 723649 | 3961586 | 2
2026-09-20T11:12:48.956871+00:00 | 19551 | 723675 | 3976725 | 2
2026-09-20T11:12:48.989127+00:00 | 19552 | 723700 | 3990121 | 2
2026-09-20T11:12:49.005917+00:00 | 19553 | 723725 | 3985181 | 2
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
