CreatorKanata/pneutouch-ai-rehc2026/docs/analysis/2026-09-20-live-calibration/pressure-head-20260920-200652.csv

host_utc | seq | mcu_ms | raw | label
2026-09-20T11:06:52.138472+00:00 | 5401 | 366796 | 4233064 | 7
2026-09-20T11:06:52.170467+00:00 | 5402 | 366822 | 4221825 | 7
2026-09-20T11:06:52.186470+00:00 | 5403 | 366847 | 4198706 | 7
2026-09-20T11:06:52.218574+00:00 | 5404 | 366872 | 4167968 | 7
2026-09-20T11:06:52.234593+00:00 | 5405 | 366897 | 4135979 | 7
2026-09-20T11:06:52.266530+00:00 | 5406 | 366922 | 4103883 | 7
2026-09-20T11:06:52.297669+00:00 | 5407 | 366948 | 4069493 | 7
2026-09-20T11:06:52.314469+00:00 | 5408 | 366973 | 4033473 | 7
2026-09-20T11:06:52.346588+00:00 | 5409 | 366998 | 4004961 | 7
2026-09-20T11:06:52.362470+00:00 | 5410 | 367023 | 3984986 | 7
2026-09-20T11:06:52.393829+00:00 | 5411 | 367048 | 3971835 | 7
2026-09-20T11:06:52.409824+00:00 | 5412 | 367074 | 3961346 | 7
2026-09-20T11:06:52.441784+00:00 | 5413 | 367099 | 3954194 | 7
2026-09-20T11:06:52.473816+00:00 | 5414 | 367124 | 3949860 | 7
2026-09-20T11:06:52.489794+00:00 | 5415 | 367149 | 3947119 | 7
2026-09-20T11:06:52.521734+00:00 | 5416 | 367174 | 3942860 | 7
2026-09-20T11:06:52.538149+00:00 | 5417 | 367199 | 3934113 | 7
2026-09-20T11:06:52.570851+00:00 | 5418 | 367225 | 3927607 | 7
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
