CreatorKanata/pneutouch-ai-rehc2026/docs/analysis/2026-09-20-live-calibration/pressure-head-supplement-20260920.csv

host_utc | seq | mcu_ms | raw | label
2026-09-20T11:09:50.234283+00:00 | 12470 | 544921 | 3951019 | 7
2026-09-20T11:09:50.253604+00:00 | 12471 | 544946 | 3951213 | 7
2026-09-20T11:09:50.282374+00:00 | 12472 | 544971 | 3950865 | 7
2026-09-20T11:09:50.301472+00:00 | 12473 | 544997 | 3950462 | 7
2026-09-20T11:09:50.330297+00:00 | 12474 | 545022 | 3950147 | 7
2026-09-20T11:09:50.362295+00:00 | 12475 | 545047 | 3950399 | 7
2026-09-20T11:09:50.394748+00:00 | 12476 | 545072 | 3950547 | 7
2026-09-20T11:09:50.411625+00:00 | 12477 | 545097 | 3950326 | 7
2026-09-20T11:09:50.442684+00:00 | 12478 | 545123 | 3950380 | 7
2026-09-20T11:09:50.458332+00:00 | 12479 | 545148 | 3950330 | 7
2026-09-20T11:09:50.490276+00:00 | 12480 | 545173 | 3950418 | 7
2026-09-20T11:09:50.506283+00:00 | 12481 | 545198 | 3950509 | 7
2026-09-20T11:09:50.538678+00:00 | 12482 | 545223 | 3950406 | 7
2026-09-20T11:09:50.570159+00:00 | 12483 | 545248 | 3949973 | 7
2026-09-20T11:09:50.587325+00:00 | 12484 | 545274 | 3950573 | 7
2026-09-20T11:09:50.618303+00:00 | 12485 | 545299 | 3950525 | 7
2026-09-20T11:09:50.634294+00:00 | 12486 | 545324 | 3949881 | 7
2026-09-20T11:09:50.666297+00:00 | 12487 | 545349 | 3950159 | 7
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
