CreatorKanata/pneutouch-ai-rehc2026/docs/analysis/2026-09-20-live-calibration/pressure-legs-20260920.csv

host_utc | seq | mcu_ms | raw | label
2026-09-20T11:17:19.840966+00:00 | 30287 | 994602 | 3930182 | 3
2026-09-20T11:17:19.873968+00:00 | 30288 | 994627 | 3931389 | 3
2026-09-20T11:17:19.903967+00:00 | 30289 | 994653 | 3930256 | 3
2026-09-20T11:17:19.920965+00:00 | 30290 | 994678 | 3928564 | 3
2026-09-20T11:17:19.951843+00:00 | 30291 | 994703 | 3928511 | 3
2026-09-20T11:17:19.967837+00:00 | 30292 | 994728 | 3928162 | 3
2026-09-20T11:17:20.000775+00:00 | 30293 | 994753 | 3927800 | 3
2026-09-20T11:17:20.015842+00:00 | 30294 | 994779 | 3928529 | 3
2026-09-20T11:17:20.047843+00:00 | 30295 | 994804 | 3929099 | 3
2026-09-20T11:17:20.079874+00:00 | 30296 | 994829 | 3928736 | 3
2026-09-20T11:17:20.095837+00:00 | 30297 | 994854 | 3928800 | 3
2026-09-20T11:17:20.127837+00:00 | 30298 | 994879 | 3929279 | 3
2026-09-20T11:17:20.143835+00:00 | 30299 | 994904 | 3930265 | 3
2026-09-20T11:17:20.175857+00:00 | 30300 | 994930 | 3930283 | 3
2026-09-20T11:17:20.191854+00:00 | 30301 | 994955 | 3930707 | 3
2026-09-20T11:17:20.223675+00:00 | 30302 | 994980 | 3931708 | 3
2026-09-20T11:17:20.255784+00:00 | 30303 | 995005 | 3932176 | 3
2026-09-20T11:17:20.271836+00:00 | 30304 | 995030 | 3933052 | 3
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
