CreatorKanata/pneutouch-ai-rehc2026/docs/analysis/2026-09-20-live-calibration/pressure-tail-20260920.csv

host_utc | seq | mcu_ms | raw | label
2026-09-20T11:21:11.504123+00:00 | 39383 | 1224197 | 3951685 | 1
2026-09-20T11:21:11.519006+00:00 | 39384 | 1224223 | 3951347 | 1
2026-09-20T11:21:11.551715+00:00 | 39385 | 1224248 | 3951760 | 1
2026-09-20T11:21:11.568701+00:00 | 39386 | 1224273 | 3951158 | 1
2026-09-20T11:21:11.599944+00:00 | 39387 | 1224298 | 3950291 | 1
2026-09-20T11:21:11.630720+00:00 | 39388 | 1224323 | 3950440 | 1
2026-09-20T11:21:11.646669+00:00 | 39389 | 1224349 | 3951261 | 1
2026-09-20T11:21:11.678904+00:00 | 39390 | 1224374 | 3953579 | 1
2026-09-20T11:21:11.694921+00:00 | 39391 | 1224399 | 3957737 | 1
2026-09-20T11:21:11.717549+00:00 | 39392 | 1224424 | 3965267 | 1
2026-09-20T11:21:11.742244+00:00 | 39393 | 1224449 | 3981176 | 1
2026-09-20T11:21:11.774869+00:00 | 39394 | 1224475 | 4005543 | 1
2026-09-20T11:21:11.799842+00:00 | 39395 | 1224500 | 4054745 | 1
2026-09-20T11:21:11.823682+00:00 | 39396 | 1224525 | 4144516 | 1
2026-09-20T11:21:11.854882+00:00 | 39397 | 1224550 | 4282217 | 1
2026-09-20T11:21:11.865622+00:00 | 39398 | 1224575 | 4426029 | 1
2026-09-20T11:21:11.899351+00:00 | 39399 | 1224601 | 4531634 | 1
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
