CreatorKanata/pneutouch-ai-rehc2026/docs/analysis/2026-09-20-pressure/results/events.csv

apparent_decay_tau_ms | area_counts_s | area_ratio | area_width_ms | asymmetry | baseline_counts | baseline_sd | complete | decay_log_r2 | decay_ms | event | exclusion | extraction_threshold_counts | file | hold_proxy_s | kind | label_basis | middle_fraction | negative_onset_s | onset_s | peak_counts | peak_from_wave_onset_ms | peak_index | peak_s | post_event_shift_counts | recovery_ms | recovery_s | release_area_counts_s | release_area_width_ms | release_rise_ms | release_width_ms | rise_ms | signal_noise_ratio | slope_norm_s | spectral_centroid_hz | spectral_high_fraction | spectral_rms_hz | trigger_s | trough_counts | trough_index | trough_peak_ratio | trough_s | width_ms | zone_id
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
