CreatorKanata/pneutouch-ai-rehc2026/3d-models/test-pieces-internal/detail.png

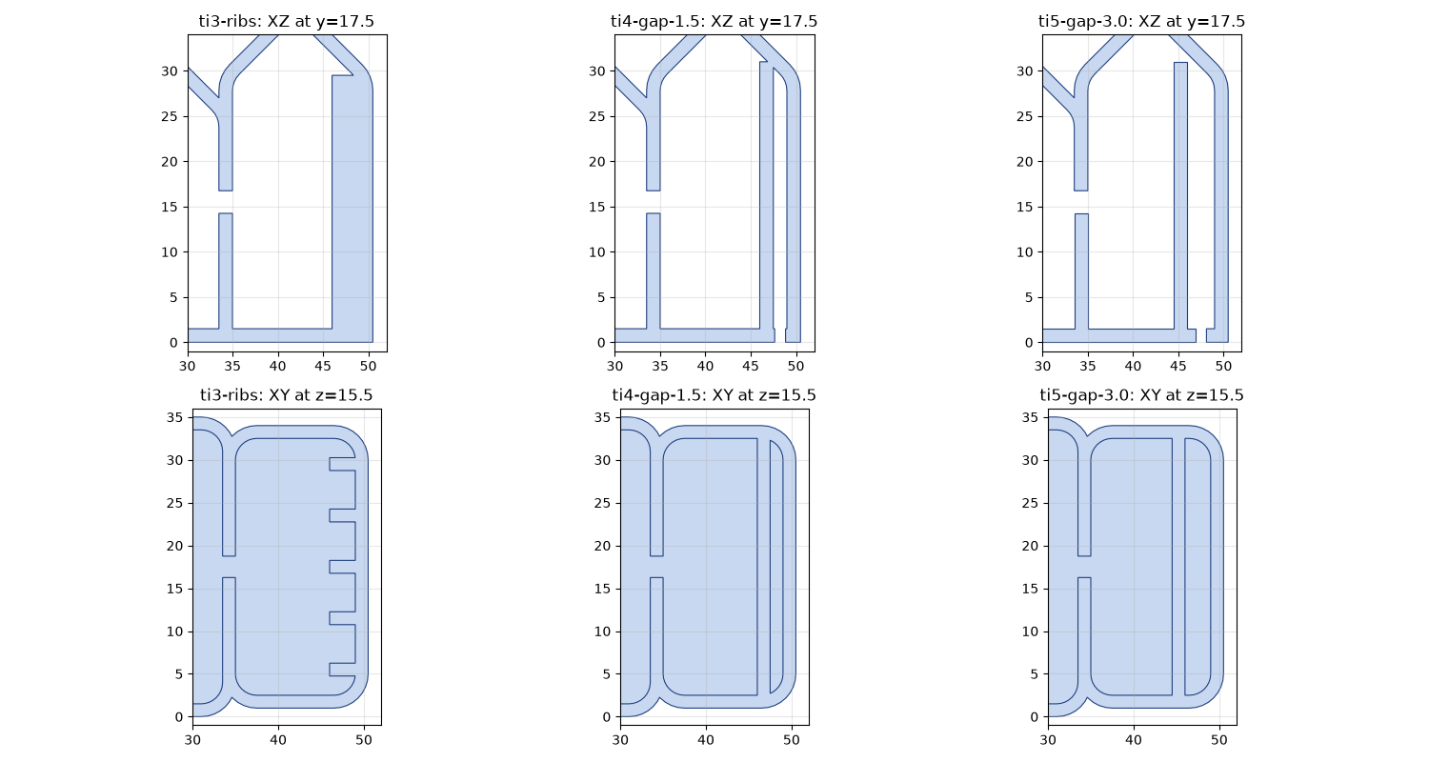
3d-models/test-pieces-internal/detail.png
