CreatorKanata/pneutouch-ai-rehc2026/3d-models/test-pieces-internal/gap-explained.png

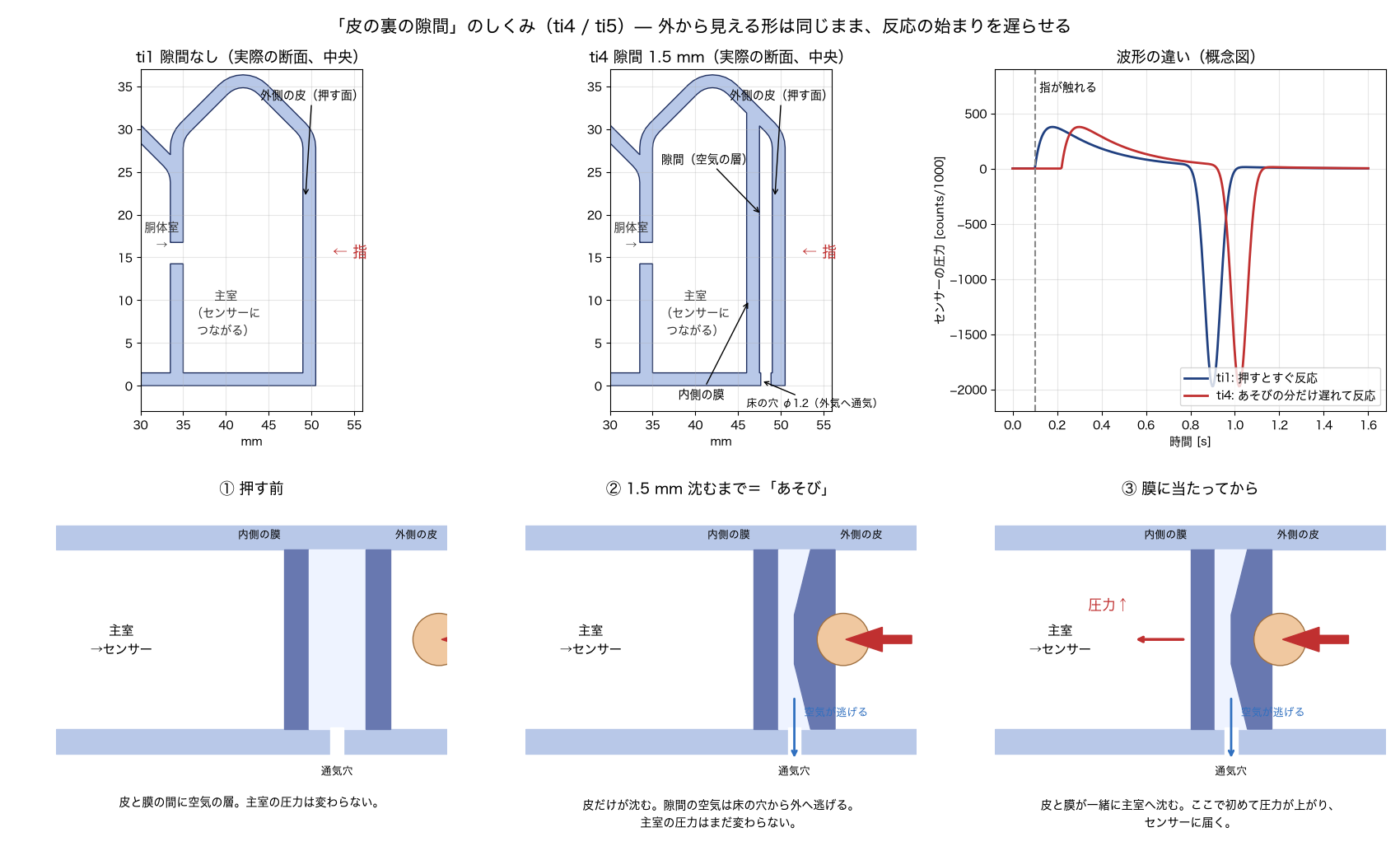
3d-models/test-pieces-internal/gap-explained.png
