CreatorKanata/pneutouch-ai-rehc2026/3d-models/test-pieces-internal/id-dimples.png

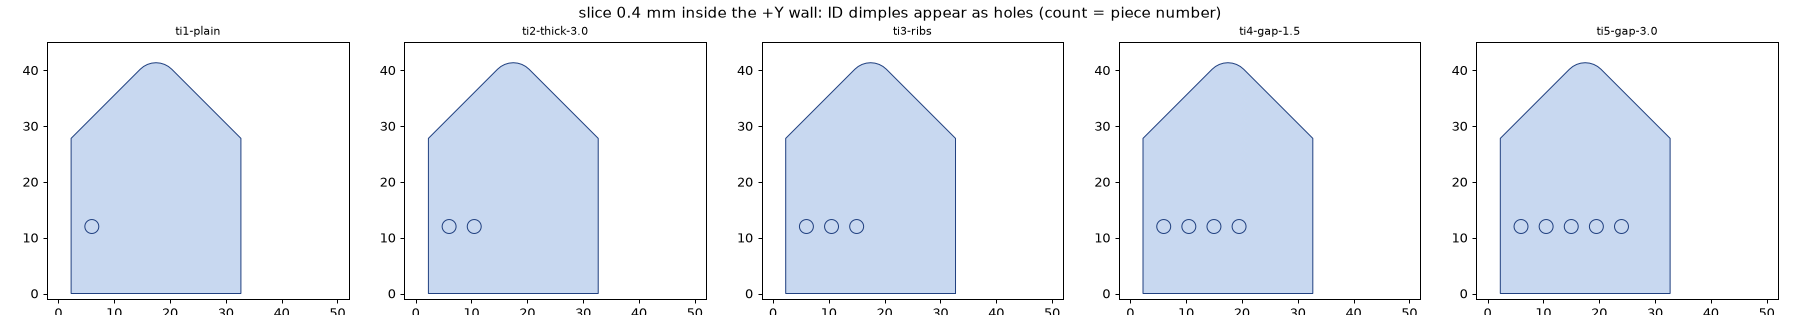
3d-models/test-pieces-internal/id-dimples.png
