CreatorKanata/pneutouch-ai-rehc2026/3d-models/test-pieces-internal/preview.png

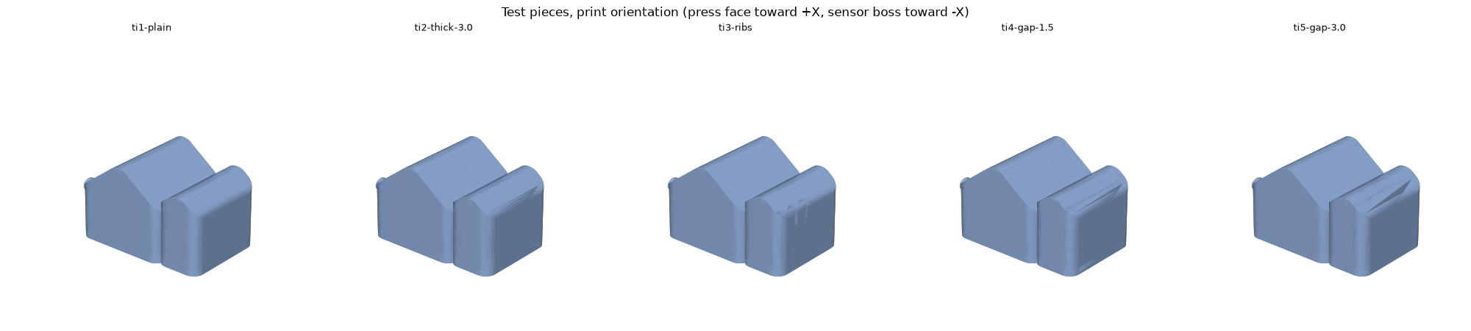
3d-models/test-pieces-internal/preview.png
