CreatorKanata/pneutouch-ai-rehc2026/3d-models/test-pieces-internal/sections.png

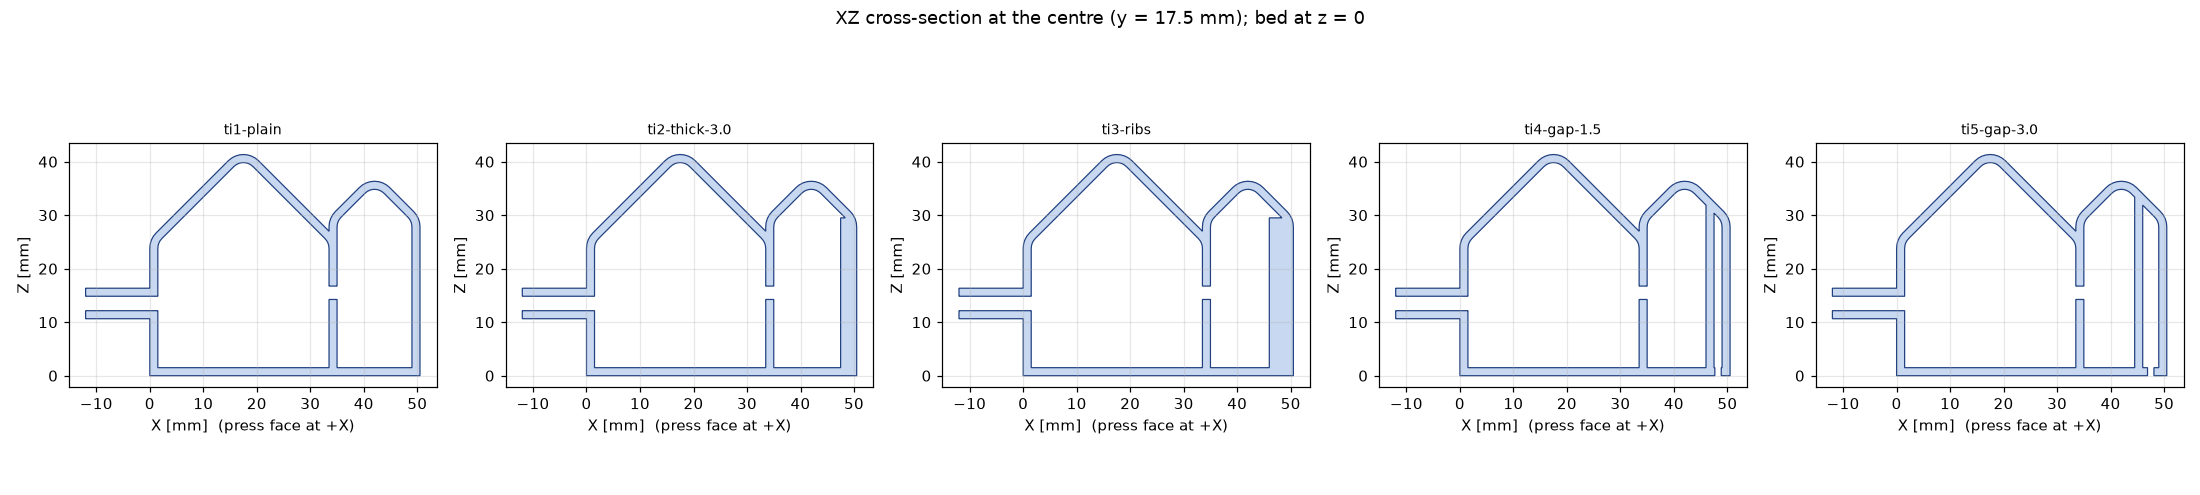
3d-models/test-pieces-internal/sections.png
