CreatorKanata/pneutouch-ai-rehc2026/docs/analysis/2026-10-21-test-pieces/features.png

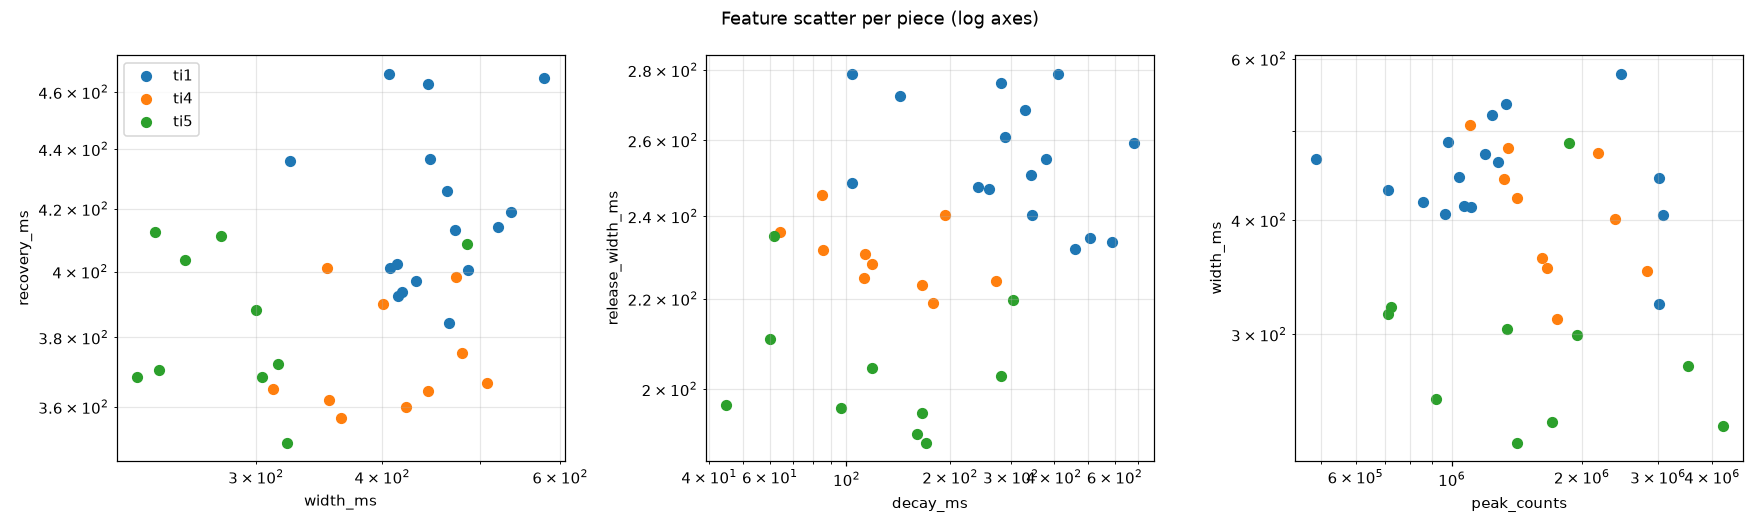
docs/analysis/2026-10-21-test-pieces/features.png
