CreatorKanata/pneutouch-ai-rehc2026/src/pneutouch-solist/S_PneuTouch/pneu_config.h

/* Generated from config.py. Edit the source configuration. */
#ifndef PNEU_CONFIG_H
#define PNEU_CONFIG_H
#define PNEU_CPU_HZ 48000000U
#define PNEU_UART_BAUD 115200U
#define PNEU_UART_DIVISOR 25U
#define PNEU_UART_ADJUST 25U
#define PNEU_SAMPLE_RATE_HZ 40U
#define PNEU_SENSOR_TIMEOUT_MS 1000U
#define PNEU_SETTLE_MS 500U
#define PNEU_CLOCK_HALF_US 2U
#define PNEU_HX_PULSES 27U
#endif
