CreatorKanata/pneutouch-ai-rehc2026/src/pneutouch-solist/S_Driver/saAdc0.h

/*****************************************************************************
 saAdc0.h

 Copyright (C) 2024 ROHM Co., Ltd.
 All rights reserved.

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
 History
    2024.07.31 Ver 1.0.0

******************************************************************************/
/**
 * @file    saAdc0.h
 *
 * This module is 'SA-ADC0' drivers.
 *
 */
/**
 *  @addtogroup driver
 *  @{
 *
 *  @defgroup SA-ADC
 *  @{
 *
 *  @brief Successive Approximation Type A/D Converter register related
 *
 *  @file
 */

#ifndef SAADC0_H__
#define SAADC0_H__

#include "mcu.h"
#include "rdwr_reg.h"
#include "saAdc_common.h"


/*############################################################################*/
/*#                                  API                                     #*/
/*############################################################################*/

/**
 * Enable A/D conversion start trigger
 *
 * @param   -
 * @return  None
 */
#define         saAdc0_enaTrigger()              set_bit( SADC0->SADCON, (1U << 1U) )

/**
 * Disable A/D conversion start trigger
 *
 * @param   -
 * @return  None
 */
#define         saAdc0_disTrigger()              clear_bit( SADC0->SADCON, (1U << 1U) )

/**
 * Start A/D conversion
 *
 * @param   -
 * @return  None
 */
#define         saAdc0_start()                   set_bit( SADC0->SADCON, (1U << 0U) )

/**
 * Stop A/D conversion
 *
 * @param   -
 * @return  None
 */
#define         saAdc0_stop()                    clear_bit( SADC0->SADCON, (1U << 0U) )

/**
 * Getting A/D conversion running
 *
 * @param       -
 * @retval      0               Stopped
 * @retval      "other than 0"  Running
 */
#define         saAdc0_getRunning()              get_bit( SADC0->SADCON, (1U << 0U) )

/**
 * Set A/D start trigger source
 *
 * @param[in]   trigger   Trigger source
 *                          - SAADC_SASTS_TM0INT
 *                          - SAADC_SASTS_TM1INT
 *                          - SAADC_SASTS_TM2INT
 *                          - SAADC_SASTS_TM3INT
 *                          - SAADC_SASTS_FTM0TGO
 *                          - SAADC_SASTS_FTM1TGO
 *                          - SAADC_SASTS_NTMS0TGO0
 *                          - SAADC_SASTS_NTMS0TGO1
 *                          - SAADC_SASTS_NTMS1TGO0
 *                          - SAADC_SASTS_NTMS1TGO1
 *                          - SAADC_SASTS_NTMS2TGO0
 *                          - SAADC_SASTS_NTMS2TGO1
 * @return      None
 */
#define         saAdc0_setTrigger( trigger )     write_reg32( SADC0->SADTRG, (trigger) )

/**
 * Enable A/D channel 0
 *
 * @param   -
 * @return  None
 */
#define         saAdc0_enaCh0()                  set_bit( SADC0->SADEN, (1U << 0U) )

/**
 * Disable A/D channel 0
 *
 * @param   -
 * @return  None
 */
#define         saAdc0_disCh0()                  clear_bit( SADC0->SADEN, (1U << 0U) )

/**
 * Enable A/D channel 1
 *
 * @param   -
 * @return  None
 */
#define         saAdc0_enaCh1()                  set_bit( SADC0->SADEN, (1U << 1U) )

/**
 * Disable A/D channel 1
 *
 * @param   -
 * @return  None
 */
#define         saAdc0_disCh1()                  clear_bit( SADC0->SADEN, (1U << 1U) )

/**
 * Enable A/D channel 2
 *
 * @param   -
 * @return  None
 */
#define         saAdc0_enaCh2()                  set_bit( SADC0->SADEN, (1U << 2U) )

/**
 * Disable A/D channel 2
 *
 * @param   -
 * @return  None
 */
#define         saAdc0_disCh2()                  clear_bit( SADC0->SADEN, (1U << 2U) )

/**
 * Enable A/D channel 3
 *
 * @param   -
 * @return  None
 */
#define         saAdc0_enaCh3()                  set_bit( SADC0->SADEN, (1U << 3U) )

/**
 * Disable A/D channel 3
 *
 * @param   -
 * @return  None
 */
#define         saAdc0_disCh3()                  clear_bit( SADC0->SADEN, (1U << 3U) )

/**
 * Enable A/D channel 4
 *
 * @param   -
 * @return  None
 */
#define         saAdc0_enaCh4()                  set_bit( SADC0->SADEN, (1U << 4U) )

/**
 * Disable A/D channel 4
 *
 * @param   -
 * @return  None
 */
#define         saAdc0_disCh4()                  clear_bit( SADC0->SADEN, (1U << 4U) )

/**
 * Enable A/D channel 5
 *
 * @param   -
 * @return  None
 */
#define         saAdc0_enaCh5()                  set_bit( SADC0->SADEN, (1U << 5U) )

/**
 * Disable A/D channel 5
 *
 * @param   -
 * @return  None
 */
#define         saAdc0_disCh5()                  clear_bit( SADC0->SADEN, (1U << 5U) )

/**
 * Enable A/D channel 6
 *
 * @param   -
 * @return  None
 */
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
 * @return  A/D conversion result8
 */
#define         saAdc0_getResult8()              read_reg32( SADC0->SADR8 )

/**
 * Getting A/D conversion result9
 *
 * @param   -
 * @return  A/D conversion result9
 */
#define         saAdc0_getResult9()              read_reg32( SADC0->SADR9 )

/**
 * Getting A/D conversion result10
 *
 * @param   -
 * @return  A/D conversion result10
 */
#define         saAdc0_getResult10()              read_reg32( SADC0->SADR10 )

/**
 * Getting A/D conversion result11
 *
 * @param   -
 * @return  A/D conversion result11
 */
#define         saAdc0_getResult11()              read_reg32( SADC0->SADR11 )

/**
 * Set A/D converter test mode
 *
 * @param[in]   mode   Test mode
 *                        - SAADC_SADTMOD_DISABLE
 *                        - SAADC_SADTMOD_FULLSCALE
 *                        - SAADC_SADTMOD_ZEROSCALE
 *                        - SAADC_SADTMOD_VREFSCALE
 * @return      None
 */
#define         saAdc0_setTestmode( mode )       write_reg32( SADC0->SADTMOD, (mode) )


void saAdc0_init( initAdc_t *st_initAdc );
void saAdc0_setEnableChannel( enableAdcChannel_t *st_enableChannel );

#endif /*SAADC0_H__*/

/** @} */
/** @} */
