CreatorKanata/pneutouch-ai-rehc2026/src/pneutouch-solist/S_System/main.h

/*****************************************************************************
 * File: main.h
 * Title: PneutouchAI
 * LastUpdated: 2026.09.20
 * Copyright (C) 2026 Kanata the Kid Creator
******************************************************************************/

/**
 * @file main.h
 * @brief PneutouchAI by Kanata the Kid Creator
 */
 
#ifndef MAIN_H__
#define MAIN_H__

#endif // MAIN_H__ 
