CreatorKanata/pneutouch-ai-rehc2026/src/pneutouch-solist/S_Driver/uartf1.h

/*****************************************************************************
 uartf1.h

 Copyright (C) 2024 ROHM Co., Ltd.
 All rights reserved.

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
 History
    2024.07.31 Ver 1.0.0

******************************************************************************/
/**
 * @file    uartf1.h
 *
 * This module is 'UARTF1' drivers.
 *
 */
/**
 *  @addtogroup driver
 *  @{
 *
 *  @defgroup UARTF
 *  @{
 *
 *  @brief UART with FIFO register related
 *
 *  @file
 */

#ifndef UARTF1_H__
#define UARTF1_H__

#include "mcu.h"
#include "rdwr_reg.h"
#include "uartf_common.h"

/*############################################################################*/
/*#                                  Macro                                   #*/
/*############################################################################*/

/*############################################################################*/
/*#                                  API                                     #*/
/*############################################################################*/
/**
 * Getting reception data
 *
 * @param       -
 * @return      A reception data <br>
 *              (A value of UAF0BUF register)
 */
#define         uartf1_getc()           read_reg32( UARTF1->UAF0BUF )

/**
 * Sending transmission of data
 *
 * @param[in]   data    A transmission data
 *              (Setting value of UAF0BUF register)
 * @return  None
 */
#define         uartf1_putc( data )     write_reg32( UARTF1->UAF0BUF, data )

/**
 * Checking UARTF(Writing) busy status
 *
 * @param       -
 * @retval      0                busy status : Normal(able to write)
 * @retval      "other than 0"   busy status : Busy
 */
#define         uartf1_checkWriteBusy() ( ( ! get_bit( UARTF1->UAF0LSR, (1 << 5) )) )

/**
 * Checking UARTF(Reading) ready status
 *
 * @param       -
 * @retval      0                ready status : Normal
 * @retval      "other than 0"   ready status : Ready(able to read, and reception data is valid)
 */
#define         uartf1_checkReadReady() ( get_bit( UARTF1->UAF0LSR, (1 << 0) ) )
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
