CreatorKanata/pneutouch-ai-rehc2026/(commit log)

2026-09-19 恐竜の3Dモデルを追加し、参照資料を管理対象外にする
    [dino-air-7segments.stl]
2026-09-19 企画・ハードウェア調査と開発計画を文書化
2026-09-19 追加資料の調査とSolist-AI実装・内蔵ADC活用案を文書化
2026-09-19 MPS20N0040D用アンプとADCの回路検討を文書化
2026-09-20 HX710BのPhase 0計測プロジェクトと7区画モデルを追加
    DT-EBML63Q2557用LEXIDE設定、HX710B読取、PC波形表示・CSV収集、配線と開発手順を追加。現在のリンカー入口にテストを合わせ、C/Python/JavaScriptのホストテストを確認。Windowsの最終ビルドと実機計測は未確認。
    [dino-air-7segments.3mf]
2026-09-20 動作確認済みPneutouchAiプロジェクトを追加
    src/pneutouch-solist を今後のメインのファームウェア開発プロジェクトとして保存。
    PneutouchAi Debug / PneutouchAi Write の両設定を含め、Debug / Release のビルド出力を除外。
    旧 src/pneutouch-solist-ai は移植時の参考用に保持。
2026-09-20 PneutouchAiへHX710B計測を移植しCOM7で実測確認
    新しいメインプロジェクトのS_PneuTouchにHX710B読取、安定待ち、タイムアウト、PNEU1送信とデバッグ状態を追加。生成設定・検査・配布ZIPと手順をPneutouchAiへ切り替える。旧プロジェクトは参考用に保持。
    Windows Debugビルドはエラー・警告0。PneutouchAi Writeで書き込み、COM7から30秒で1190点、39.72 SPS、欠番0を実測。押下中に2388304〜7647159 countsへ変化。
    Python 10件、JavaScript 7件、Armオブジェクト10件とZIP内容を確認。POSIX専用1件はスキップ。追加Cホストテストは対応コンパイラー未導入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
2026-09-20 7区画の圧力特徴分析と開始時刻未知の再生検証を保存
    40 SPSの7区画43回と先行交互試行16回を再解析。生CSV、ハッシュ、特徴分布、分類の探索評価、因果的なイベント検出再生、6図と再現コードをdocsへ保存。
    検証: Pythonテスト18件成功・POSIX専用1件スキップ。解析JSONの再現性と入力SHA-256を確認。
    [events.csv, model-scores.csv, pressure-tail-back-20260920-164229-continuous.csv, pressure-zone01-tail-20260920-171235.csv, pressure-zone02-back-20260920-171556.csv, pressure-zone03-right-hind-leg-20260920-171839.csv, pressure-zone04-left-hind-leg-20260920-172018.csv, pressure-zone05-right-front-leg-20260920-173826.csv]
2026-09-20 圧力特徴抽出とSolist-AI実機の4分類自動比較を追加
    開始時刻未知の12特徴抽出とPAI1学習・推論モードを追加。保存43イベントで12特徴量・64点波形・128点波形を実機比較し、分割・予測・時間・通信ログをdocsへ保存。
    Debugビルドはエラー・警告0。C 5スイート、Python 22件（1件skip）、JS 7件を確認。比較後の通常取得は39.71 SPS・欠番0。ライブ分類とモデル永続保存は未統合。
2026-09-20 PneutouchAIの実圧力4分類とLCD表示を実装
    実圧力から12特徴を抽出し、SolistAIで4分類してLCDへ3秒表示。追加計測60件を起動時に学習する。
    PneutouchAI / Kanata the Kid Creator表記へ統一。特徴抽出の改善前後は13記録で一致。C 7スイート、Python 22件（1スキップ）、JavaScript 7件成功。Debugビルド0エラー・既存警告6件、実機書き込みと取得再開を確認。
    保留8件は6件正解、学習60件の再現は46件。HEAD/LEGS誤分類は未解決。データ・全スコア・制限をdocsに保存。
    [pressure-back-20260920.csv, pressure-head-20260920-200652.csv, pressure-head-supplement-20260920.csv, pressure-legs-20260920.csv, pressure-tail-20260920.csv]
2026-09-20 デモ用の恐竜動画を追加
2026-09-20 HEAD/LEGS専用判別と実機検証を追加
    通常4分類がHEAD/LEGSを返した場合に、正圧ピークを含む12入力の専用モデルで再判別する。両モデルを起動時に学習し、TAIL/BACKの一次判定は維持する。
    保存記録の4分割比較は全体52/60、HEAD 15/15。書き込んだ2インスタンスの学習済みデータ再現は56/60、通常モデルの全60判定が改良前と一致。実押下ではHEAD/LEGSが半々程度という報告があり、誤判定は未解決。全比較・制限をdocsへ保存。
    C 7スイート、Python 22件（1スキップ）、JavaScript 7件成功。Debug差分ビルド0エラー・0警告、実機Writeと通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
2026-09-20 HEAD/LEGSの波形再検証と空気圧フィルタの設計検討を追加
    既存8記録・65イベントを現行C特徴抽出と照合し、振幅の大小逆転、解放形状の重なり、足の小振幅9件の棄却を再検証。採用閾値のオフライン感度分析、4枚の図、イベント表と整列波形を保存。
    穴・隔壁によるRC的な作用の未確認点と、頭側流路を調整する試験案を一次資料と併記。今回の作業では追加計測・モデル変更・実機書き込みを行っていない。
    [aligned-waveforms.csv, events.csv]
2026-09-20 局所変形と穴径による復元への影響を分析に追記
2026-09-20 デモで使う押されたところを表示する画像を追加
2026-09-20 pngをjpgに
2026-09-20 実圧力とSolistAI推定に連動するHTMLデモを追加
    COM7をWeb Serialで受信し、押下時に全体黄色、推定確定時に部位の赤画像を3秒表示。部位動画は5秒で待機ループへ戻し、実測波形を表示する。
    ユーザー提供JPEG6枚を組み込み、pushing.jpgをpressed.jpgへ改名。localhost用配信サーバーと操作手順を追加。
    検証: Node 14件、Python 2件、Chrome統合試験（実UART記録、4部位、3秒/5秒切替、切断、モバイル表示）が成功。
2026-09-20 恐竜動画を全面表示しステータスと波形を左上に重ねる
    動画を画面全体に表示し、左上の半透明パネルへ状態画像と実測波形、接続表示を配置。ページ全体のFullscreen APIを使い、全画面でもパネルを維持する。
    Chromeで配置、全画面への移行と解除、既存の3秒/5秒切替、実測記録表示、切断とモバイル表示を確認。
2026-09-20 推定波形を右下に5秒間だけ表示する
    波形を右下の全画面・音声ボタンの上へ移動。初期状態は非表示とし、新しい推定結果から5秒で非表示に戻す。連続推定は最新の結果から5秒に更新し、重複結果や遅延した特徴量で再表示しない。
    Node 15件とChrome統合試験が成功。初期非表示、推定時表示、右下配置、3秒後の継続と5秒後の非表示を確認。
2026-09-20 feat: ロゴ画像を追加しデモのHUDを整理する
    - READMEのトップにサムネイル画像を配置
    - デモ左上のロゴテキストをロゴ画像に置き換え、接続ボタンをロゴ右側に移動
    - タグライン・接続の説明・案内文・英語ラベル・タッチ後の案内を削除し、案内行はエラー時のみ表示
    - 「どこをさわる？」と凡例を恐竜画像の左上に重ねて表示
    - 起動用サーバーに /images/logo/ の配信ルートを追加しテストで確認
2026-09-21 chore: videos/rehc2026 を gitignore に追加
2026-09-28 chore: Apache License 2.0 を追加
    LICENSE に Apache License 2.0 の全文、NOTICE に著作権表示を追加。
    ROHM 提供のドライバー・サンプルコードと恐竜の外形は、
    提供元の条件に従うことを NOTICE に明記する。
2026-09-28 docs: README をシステムの説明中心に書き直す
    公開リポジトリ向けに、開発経過の記録を外してシステムの説明に絞る。
    - ProtoPedia と YouTube のリンクを追加
    - システム構成図と回路図を追加
    - しくみ、ハードウェア、ソフトウェア、使い方を整理
    - ライセンスの節を追加
    検証記録は docs/ に残し、README からリンクする。
2026-10-01 docs: ProtoPedia 掲載用の写真を追加
    サムネイル、デモ画面、恐竜の内部構造、圧力センサーの4枚。
    thumbnail.jpg は EXIF（位置情報を含む）と HDR 用トレーラーを除去済み。
2026-10-02 docs: 波形と空気室のつながりの説明図を追加
    - waveform-features: 押して離したときの圧力波形と12特徴量の対応図
    - air-chambers: 生成イラストに穴・通り道・順番を重ねた空気室の接続図
    - 元イラスト（Codex 生成、注釈なし）と生成スクリプトを同梱
    - README の「7つの空気室」と「AIモデル」に図を追加
2026-10-02 docs: ProtoPedia 用にタイトルなしの説明図を追加
    air-chambers と waveform-features の、見出し部分を除いた版。
2026-10-02 docs: README のしくみを図に沿って4段階で説明する
    空気室のつながりと波形・特徴量の図を使い、
    部屋の構造 → 波形 → AI → 反応の順に書き直す。
2026-10-04 docs: ProtoPedia 用の説明文を読みやすく整える
    - 行の途中で切れていた箇所と余分なインデントを直す
    - 太字と文末コロンを減らし、英単語前後の半角空白を外す
    - こだわったところを段落に、処理の流れを敬体の1文にそろえる
2026-10-04 docs: ProtoPedia のストーリーを一人称にし、回路図の説明を追加
    - story.md を恐竜バトルを出発点とするかなたの語りに書き直す
    - system-structure.md に配線図の説明文と画像の代替テキストを追加
    - 処理の流れのラベル後にコロンを付ける
2026-10-20 docs: 最終審査に向けた戦略・先行研究調査・試験片の手順を docs/final-judging に追加
    - 公式サイトと最終審査会ページの記録、GPT 案の原文、実装との照合と判断
    - 10 日間の計画、teach モード仕様、5 分プレゼン構成、Codex の第二意見
    - 再印刷の検討（流路では見分けられないことの計算と訂正、皮の内側で符号化する方針）
    - 受動流体・音響・流れと構造符号化の 3 調査と、何で場所を見分けられるかの総合判断
    - 試験片 ti1〜ti5 のテスト手順
2026-10-20 feat: 空気圧の集中定数シミュレーターを追加
    空気室（気体の容量＋壁の力学）、流路（層流＋オリフィス損失）、漏れ、指の押下を
    モデル化し、40 SPS でサンプリングしてファームウェアと同じ 12 特徴量で分離精度を比べる。
    実しっぽ波形で校正（残差 0.041）。結果は docs/analysis/2026-10-15-pneumatic-sim/。
    印刷できる流路では時定数が ms 級で位置を符号化できず、区画ごとの壁の沈み込み時定数を
    2 倍以上ずらすと 4 分類 95% になることを示した。
2026-10-20 feat: 試験片の STL 生成と解析スクリプトを追加
    - tools/make_test_pieces.py: manifold3d で試験片を生成。押し面そのものを変えるセット（tp1〜5）と、
    外形は同じで皮の内側だけ変えるセット（ti1〜5: 肉厚、リブ、あそび 1.5 / 3.0 mm）。
    最小肉厚 1.5 mm、縁の丸め、番号と同じ個数の識別くぼみ、断面図と 3D プレビューを出力
    - tools/analyze_test_pieces.py: 記録 CSV から片ごとの中央値、一回抜き最近重心法の分離、
    時定数比、押す強さとの相関、平均波形を出す（9 月の恐竜データで動作確認）
    - 3d-models/test-pieces*/: STL、README、説明図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
2026-10-20 fix: 試験片の測定手順と3分類のgo判定を修正
2026-10-21 feat: 試験片 ti1/ti4/ti5 の検証結果（go）と恐竜 v2（足あそび）の STL 生成を追加
    - docs/analysis/2026-10-21-test-pieces: 生データ、summary、波形。3 分類 97.2%、減衰比 2.4〜2.9 倍
    - docs/final-judging/test-pieces-results.md: 検証結果のまとめ
    - what-discriminates.md 6 節: 小さい穴で流路時定数を作る案の計算（φ0.3〜0.5 が必要、印刷不可）
    - tools/make_dino_v2.py: 外形そのまま、足 4 本の内側に通気付きスリーブ（gap 2.5）。自立形状と support_check
    - reprint-design.md 3f: v2 設計と印刷性の修正
2026-10-21 feat: 85A 恐竜の再学習ツールと手順を追加
    - tools/prepare_retrain.py / retrain_report.py / retrain_replay.py: 収録フォルダーから学習 JSON、summary、波形を生成。
    特徴は MCU の PNEF1 テレメトリーか、ホストで再生した C 特徴抽出（--replay）
    - tools/capture_live_calibration.py: --stop を任意に、--seconds と Ctrl-C 対応
    - docs/final-judging/retrain-85a.md: 収録 → 生成 → ビルド → 独立評価の手順と 10/21 の結果
2026-10-21 feat: 85A 恐竜 v2 で再学習したモデルを埋め込み、山の高さのしきい値を 40000 に変更
    - pressure_features.c: MIN_PEAK_COUNTS 40000（旧 100000）。85A の足は山が 49k〜88k で全件 INVALID だった
    - pressure_model_data.h: 10/21 収録の 80 例（HEAD 20 / BACK 21 / LEGS 14 / TAIL 25）で再生成
    - docs/analysis/2026-10-21-dino-85a: 学習 JSON、summary（一回抜き 4 分類 87.5%、HEAD/LEGS 94.1%）、波形
2026-10-22 feat: 足の検出しきい値を 30000 に下げ、モデル入力に山と谷の絶対値を追加
    85A 恐竜では足の正の山が 30〜88k しかなく、トリガー 50000 では大半を取りこぼし、
    検出できた分も形だけの 12 特徴ではしっぽと区別できなかった（一回抜き 4 分類 73.5%）。
    - pressure_features.c: TRIGGER_COUNTS 50000→30000、MIN_PEAK_COUNTS 40000→25000
    - pressure_model.c / generate_pressure_model.py: 主モデルと HEAD/LEGS 専用モデルの両方で
    入力 5 = 正の山/1000、入力 10 = 谷の大きさ/1000（predict に trough 引数を追加）
    - pressure_model_data.h: 117 件（docs/analysis/2026-10-22-dino-85a）で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
2026-10-22 feat: 10/23 の背中・しっぽを加えた 141 件でモデルを再生成、恐竜は v1 形状の 85A と訂正
    - 書き込み後に背中が TAIL、しっぽが LEGS になる問題は、10/23 の押し方（山が低く谷が深い）が
    10/21 の学習データと違うため。両日分を合わせて再学習（docs/analysis/2026-10-23-dino-85a、
    一回抜き 88.7%、TAIL/BACK 100%）
    - docs: 印刷した恐竜は v2 ではなく v1 の STL を 85A で印刷したものと訂正（retrain-85a.md、
    plan-10days.md、README）
2026-10-23 feat: 空気室のない恐竜 STL と最終審査用の画像を追加
    - 3d-models/dino-air-no-segments.stl: 仕切り（空気室）をなくした恐竜。外形は dino-air-7segments と同じ
    - images/final/: 最終審査の資料用画像（サムネイル、空気室図、回路図、波形と特徴量）
2026-10-23 feat: 学習データを FeRAM に置き、チップ上で特徴を自動選定する新方式（new-approach）
    - 学習データのコード埋め込み（pressure_model_data.h と生成ツール）を廃止し、基板の FeRAM に
    4 スロット × 最大 1000 件（uint16_t）の記録（ラベル + 14 値）として保存する
    - 起動時にチップが 14 候補（12 特徴 + 山 + 谷）の Fisher 比を計算し、自動（または k 固定）で選んで
    Solist-AI 1 インスタンスを学習する。HEAD/LEGS 専門モデルは廃止
    - UART に PST1 コマンド（INFO/SLOT/OPEN/PUT/COMMIT/GET/ERASE/USE/TRAIN/SELFTEST）を追加し、
    tools/model_store.py で書き込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
2026-10-23 fix: 正規化を 1σ にして TAIL を学習できるようにし、PC ツールは常に取得停止してから送る
    - feature_select.c / feature_select.py: スケールを母標準偏差 ×3 から ×1 に。3σ では隠れ層が
    線形のままで、振幅軸の中間にある TAIL を学習データすら覚えられなかった（10/23 実機実験、
    時系列で後ろ 25% を外した判定で k=4・1σ が 4 部位とも 100%）
    - 自動選定のしきい値を最大値の 1/16 から 1/10 に（85A データで 4 個: 谷、山、戻りの幅、面積幅）
    - tools/model_store.py: info/selftest/dump も先に PAI1 MODE 1 にする。取得中は受信バッファーが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
2026-10-23 feat: チップ上で k を交差検証で自動決定し、足りない部位を提案、FeRAM 読み出しを高速化
    - PST1 TUNE / model_store.py tune: k=4..8 を 4 分割交差検証で試し、最良の k と
    部位ごとの再現率をスロットヘッダー（バイト 9、20..23）に保存。起動時は保存した k で学習
    - 再現率 90% 未満の部位を提案: # PNEM4、LCD "READY MORE <部位>"、PC ツールの日本語表示
    - LCD に TUNE の進捗 "TUNE 7/20 57%"
    - FeRAM: pneu_store_get のヘッダーキャッシュ、SoftSpi の内側ループを単純書込み 2 回に、
    正規化の割り算を 1/scale の掛け算に。SoftSpi は模擬スレーブでホ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
2026-10-23 feat: TUNE の LCD を "TUNE k5 r3/4 57%" にし、大きい k は 1% 超の差でだけ採用
    - LCD 1 行目は試している特徴数 k と 4 分割の何回目かを表示（終わった回数/20 をやめる）
    - keep_best: 大きい k は正解数が記録数の 1%（最低 1 件）より多く上回るときだけ採用
    （実機で k=7 が k=4 に 176 件中 1 件差で勝っていたのはノイズ）
    - ビルド名 na4-margin
2026-10-23 feat: LCD の TUNE 行を "TUNE k5 r4 57%" に、2 行目の右端を "k4" に
    - 1 行目は "/4" を省き、% の左に必ず空白（100% でも r4 と数字がくっつかない）
    - 2 行目の選んだ数は "k4" の形（10 以上は数字 2 桁）
    - ビルド名 na6-k
2026-10-23 feat: チップ上で特徴の組み合わせを 2 段階で探索し、選んだマスクをスロットに保存（subset-search）
    - 表引き log（257 点、線形補間、誤差 < 4e-6）。PC 側も同じ表でビット一致
    - TUNE: Fisher 上位 7 個の 3〜7 個の全組み合わせ 99 通りを「各部位 10 件で学習、残り全件で判定」×2 で
    一次選考 → 上位 5 候補と王者（Fisher 自動選択）を 4 分割交差検証 → 王者を記録数の 2% 超で上回る
    挑戦者だけ採用
    - スロットヘッダー v2: 特徴マスク u16（バイト 24）、CRC はバイト 30。v1 ヘッダーもそのまま読める
    - 起動時はマスクどおりに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
2026-10-24 feat: ボタンだけで TUNE・スロット切替・学習データの記録ができるようにし、tune の表示に混同行列を追加
    - SW2 長押し 2 秒 = TUNE（結果は # PNET1）、SW3 短押し = 次のスロットへ切替 → 再学習（# PNES1）
    - SW4 短押し = 有効スロットに追記で記録開始／終了（終了で確定 → 再学習）、SW4 長押し = 空きスロットで
    新規記録開始、記録中の SW4 長押し = 今回の記録をすべて取り消し
    - SW5 短押し = 部位切替（TAIL→BACK→LEGS→HEAD）、SW5 長押し = 直前の 1 件を取り消し
    - 記録中は押すたびに 14 値を FeRAM に保存（# PNER1,REC）、LCD は "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
2026-10-24 docs: FeRAM スロット 2 の 176 件を基準データとして保存（docs/analysis/2026-10-24-fram-slot2-176）
    - 2026-10-24 に実機から吸い出した 176 件（TAIL 37 / BACK 33 / LEGS 69 / HEAD 37）。
    10/23 の転送元と全件ビット一致、実機 4 分割 94.9%、k=4
    - model-store.md に基準データの場所と戻し方を追記
2026-10-24 feat: LCD の "READY MORE <部位>" をやめ、提案は info コマンドと # PNEM4 で見る
    - 学習後の LCD は SLOT 通知 → READY のみ
    - model_store.py info にスロットごとの k・特徴名・部位別再現率・提案を表示（未調整は「未調整」）
    - ビルド名 ss4-lcd
2026-10-24 feat: 物体プロファイル DINO / KRAG（帽子 HAT・顔 FACE の 2 箇所）をスロット名で切り替え
    - スロット名の先頭 4 文字 DINO/KRAG で物体を判別（印なしは DINO）。KRAG は学習・選択・TUNE・判定を 2 クラスに限定
    - SW3 のスロット切替がそのまま DINO ⇄ KRAG の切替。LCD "READY KRAG"、通知 "S3 KRAG 40 k3"
    - SW4 長押しで "NEW: DINO (SW5)" の選択画面 → SW5 で物体を選び SW4 で新規記録開始（名前 KRAGBTN / DINOBTN）
    - PC ツール: load --object KRAG、info/dump/tune に物体名と部位名、UART 起動行に object=
    - ビルド名 ss5-krag
2026-10-24 feat: 検出しきい値を物体ごとに持ち、KRAG は +7000 で押しを拾う
    - pressure_features に pneu_detect_t（trigger/quiet/min_peak/min_trough）。DINO 30000/25000/25000/30000、
    KRAG 7000/5000/6000/6000（2026-10-24 実測: 帽子 +4k〜+18k、顔 +23k〜+29k、ノイズ ±1k）
    - 録音中は録音先スロットの物体、それ以外は有効モデルの物体のしきい値に従う
    - 起動行と切替時に # PNEM5,detect=…,object=…
    - ビルド名 ss6-thresh
2026-10-24 feat: 空気室のない恐竜 STL と最終審査用の画像を追加
    (cherry picked from commit cb42d664907687dba57439016ce0bafb892eab01)
    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
2026-11-10 feat: HTML デモを恐竜／からあげモードに対応し、ブラウザーからスロットを切り替えられるようにする
    - # PNEM3 の object=DINO|KRAG でモード（部位・動画・状態カード）を切り替える
    - # PNES1（実機 SW3 のスロット切替）に追従して「切り替え中」を表示する
    - 「モデル一覧」で PST1 のスロット一覧を読み、選択欄から PST1 USE で切り替える
    - コマンド送信用に CRC-16/CCITT-FALSE と SerialConnection.write（1 バイトずつの送信に対応）を追加
    - assets.json を objects.DINO / objects.KRAG の構成に変更し、からあげの画像・動画を追加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
2026-11-10 feat: 新しい恐竜の 3D モデル（7 空気室・BackRaised）とケースを追加し、旧モデルを old/ に移動
    - 最新版の印刷用 STL / 3MF、Fusion ファイル、加工前の元 STL
    - 確認資料（notes/）と過去版 01〜03（old/new-dinosaur/）
    - ケースの 3MF（case/）
    - 以前の dino-air-* は old/ に移動
    - 3d-models/README.md に各ファイルの説明を追加
2026-11-10 docs: 最終審査の本番用原稿（4 分）とスライド（PDF / PPTX）を追加
2026-11-11 feat: HTML デモを USB シリアルでつなぐ Android アプリを追加し、動画再生ボタンは自動再生が止められたときだけ出す
    Android アプリ（android/）
    - src/demo-visualizer を WebView でそのまま表示する。HTML・動画・画像はビルド時に APK へ取り込む
    - ボードの FT2232H（チャネル B、115200 baud）を usb-serial-for-android で読み書きし、
    navigator.serial の代わりになる shim で既存の JavaScript につなぐ
    - 動画の Range 要求に 206 で応える。横向き固定・全画面・スリープなし
    - Android では「COM7」の代わりに「USBケーブル」と表示する（PC の表示は変わら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
